davidReward/dokustudienarbeit/README.md

# Bitte beachten: http://stackoverflow.com/questions/6188780/git-latex-workflow
