davidReward/dokustudienarbeit/V2Doku/bericht.tex

%%%%%%%%%%%%%%%%%%%%%%%%%%%%%%%%%%%%%%%%%%%%%%%%%%%%%%%%%%%%%%%%%%%%%%%%%%%%%%
%% Descr:       Vorlage für Berichte der DHBW-Karlsruhe
%% Author:      Prof. Dr. Jürgen Vollmer, vollmer@dhbw-karlsruhe.de
%% $Id: bericht.tex,v 1.9 2010/04/10 10:43:57 vollmer Exp $
%%%%%%%%%%%%%%%%%%%%%%%%%%%%%%%%%%%%%%%%%%%%%%%%%%%%%%%%%%%%%%%%%%%%%%%%%%%%%%

\documentclass[
   ngerman          % neue deutsche Rechtschreibung
  ,a4paper          % Papiergrösse
% ,twoside          % Zweiseitiger Druck (rechts/links)
% ,10pt             % Schriftgrösse
% ,11pt
	,12pt
  ,pdftex
]{report}

% Bitte die Codierung Ihrer Dateien auswählen:
%\usepackage[latin1]{inputenc}      % Für UNIX mit ISO-LATIN-codierten Dateien
%\usepackage[applemac]{inputenc}  % Für Apple Mac
%\usepackage[ansinew]{inputenc}   % Für Microsoft Windows
\usepackage[utf8]{inputenc}      % UTF-8 codierte Dateien

% Um Markierungen von Baustellen zu ermöglichen.
\usepackage{color}
\usepackage{bericht}
\usepackage{geometry}
\usepackage{booktabs} % Schönere Tabellen
\usepackage{pdfpages}
\geometry{a4paper, top=25mm, left=25mm, right=25mm, bottom=25mm,
headsep=10mm, footskip=12mm}
\newcommand{\zB}{z.\,B.\ }
\newcommand{\dahe}{d.\,h.\ }

%%%%%%%%%%%%%%%%%%%%%%%%%%%%%%%%%%%%%%%%%%%%%%%%%%%%%%%%%%%%%%%%%%%%%%%%%%%%%%%
%% Angaben zur Arbeit
%%%%%%%%%%%%%%%%%%%%%%%%%%%%%%%%%%%%%%%%%%%%%%%%%%%%%%%%%%%%%%%%%%%%%%%%%%%%%%%

\newcommand{\Autor}{Jan Gerber und David Preiß}
\newcommand{\MatrikelNummer}{5757291 (Jan Gerber) 3199578(David Preiß)}
\newcommand{\Kursbezeichnung}{TINF14B3}

\newcommand{\FirmenName}{EDEKA Handelsgesellschaft Südwest mbH }
\newcommand{\FirmenStadt}{Offenburg }

%\newcommand{\BetreuerFirma}{Roland Schober}
\newcommand{\BetreuerDHBW}{Prof. Hans-Jörg Haubner}

%\newcommand{\Was}{Praxisbericht}
%\newcommand{\Was}{Robotik II}
\newcommand{\Was}{Studienarbeit}
%\newcommand{\Was}{BACHELORARBEIT}

\newcommand{\Titel}{Sensorknoten - Internet der Dinge}

\newcommand{\AbgabeDatum}{15. Mai 2017}

\newcommand{\Dauer}{Theoriephase 5. \& 6. Semester}

\newcommand{\Abschluss}{Bachelor of Engineering}
% \newcommand{\Abschluss}{Bachelor of Science}

\newcommand{\Studiengang}{Informationstechnik}
% \newcommand{\Studiengang}{Angewandte Informatik}

\newcommand{\ITServices}{IT Services }
\newcommand{\ESW}{EDEKA S\"udwest }
\newcommand{\ESWformal}{EDEKA Handelsgesellschaft S\"udwest mbH }

\hypersetup{%%
  pdfauthor={\Autor},
  pdftitle={\Titel},
  pdfsubject={\Was}
}

%%%%%%%%%%%%%%%%%%%%%%%%%%%%%%%%%%%%%%%%%%%%%%%%%%%%%%%%%%%%%%%%%%%%%%%%%%%%%%%

% Wenn \includeonly{..} benutzt wird, werden nur diese Kaptitel ausgegeben.
%\includeonly{
%  abk
% ,kapitel1
% ,kapitel2
% ,changelog
%}

%%%%%%%%%%%%%%%%%%%%%%%%%%%%%%%%%%%%%%%%%%%%%%%%%%%%%%%%%%%%%%%%%%%%%%%%%%%%%%%

% Benutzt man das "biblatex"-Paket, dann muß das hier stehen:
% BIBLATEX
\bibliography{bericht}

\sloppy

% Alter some LaTeX defaults for better treatment of figures:
    % See p.105 of "TeX Unbound" for suggested values.
    % See pp. 199-200 of Lamport's "LaTeX" book for details.
    %   General parameters, for ALL pages:
    \renewcommand{\topfraction}{0.8}	% max fraction of floats at top
    \renewcommand{\bottomfraction}{0.5}	% max fraction of floats at bottom
    %   Parameters for TEXT pages (not float pages):
    \setcounter{topnumber}{2}
    \setcounter{bottomnumber}{1}
    \setcounter{totalnumber}{5}     % 2 may work better
    %\setcounter{dbltopnumber}{2}    % for 2-column pages
    \renewcommand{\dbltopfraction}{0.9}	% fit big float above 2-col. text
    \renewcommand{\textfraction}{0.1}	% allow minimal text w. figs
    %   Parameters for FLOAT pages (not text pages):
    \renewcommand{\floatpagefraction}{0.4}	% require fuller float pages
	% N.B.: floatpagefraction MUST be less than topfraction !!
    \renewcommand{\dblfloatpagefraction}{0.7}	% require fuller float pages

	% remember to use [htp] or [htpb] for placement

\begin{document}
\lstset{language=Java}
\singlespacing % Alles bis zum eigentlichen Text in 1-fachen Zeilenabstand

%%%%%%%%%%%%%%%%%%%%%%%%%%%%%%%%%%%%%%%%%%%%%%%%%%%%%%%%%%%%%%%%%%%%%%%%%%%%%%%
{
\sffamily
\begin{titlepage}
\begin{center}
\vspace*{-2cm}
\hfill
%\includegraphics[width=4cm]{pics/dhbw-logo}\\[2cm]

\begin{figure}
%\subfigure{\includegraphics[width=0.10\textwidth]{pics/edekaneu.png}}\hfill
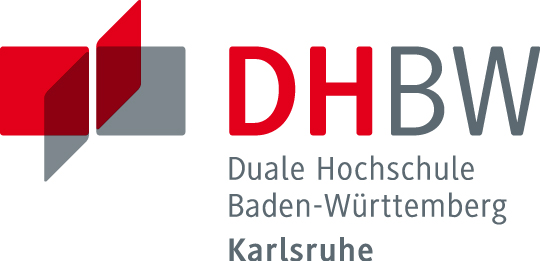
[picture p1: V2Doku/pics/dhbw-logo.png]
\subfigure{}\\[1.5cm]
\end{figure}

{\onehalfspacing \Huge \Titel}\\[1.5cm]

{\Huge  \Was}\\[1.5cm]
{\large für die Prüfung zum}\\[0.5cm]
{\Large \Abschluss}\\[0.5cm]
{\large des Studienganges \Studiengang}\\[0.5cm]
{\large an der}\\[0.5cm]
{\large Dualen Hochschule Baden-Württemberg Karlsruhe}\\[0.5cm]
{\large von}\\[0.5cm]
{\large\bfseries \Autor}\\[1cm]
{\large Abgabedatum \AbgabeDatum}
\vfill

\end{center}
\begin{tabular}{l@{\hspace{2cm}}l}
Bearbeitungszeitraum	         & \Dauer 			\\
Matrikelnummer	                 & \MatrikelNummer		\\
Kurs			         & \Kursbezeichnung		\\
%Ausbildungsfirma				 & \FirmenName \FirmenStadt \\
%Betreuer der Ausbildungsfirma	 & \BetreuerFirma		\\
Gutachter der Dualen Hochschule	 & \BetreuerDHBW		\\
\end{tabular}

\end{titlepage}
}
%%%%%%%%%%%%%%%%%%%%%%%%%%%%%%%%%%%%%%%%%%%%%%%%%%%%%%%%%%%%%%%%%%%%%%%%%%%%%%%

\pagenumbering{roman}

% Nur für Bachelorarbeiten einfügen:
%\input{sperrvermerk}
\input{erklaerung.tex}

\renewcommand{\abstractname}{Zusammenfassung}
\begin{abstract}
\begin{onehalfspacing}
Diese Studienarbeit thematisiert sich mit einem Sensorknoten für das Internet der Dinge. Hierzu werden die theoretischen und technischen Grundlagen des Raspberry Pis und  des Arduinos vorgestellt. Die Umsetzung beschäftigt sich mit der Planung und Entwicklung des Knotens und der dafür benötigter Komponenten.

Im Vordergrund der Arbeit steht die Umsetzung der Sensorknoten mit Hilfe eines Funkmoduls. Sie kommunizieren über eine Art Mesh-Netz untereinander und mit dem Raspberry Pi. 

Motivation der Studienarbeit ist der Wunsch nach einem skalierbaren und energiesparendem Sensorknoten. Er solll die gesammelten Messdaten in einer Datenbank speichen und diese anschließend visualisiert darstellt. Ferner sollen die Bedürfnisse des Nutzers nach einem \textit{Plug and Play} System nicht vernachlässigt werden.

\end{onehalfspacing}
\end{abstract}

%\newpage
% Beginn römische Ziffern bei den Verzeichnissen

\tableofcontents           % Inhaltsverzeichnis hier ausgeben
\listoffigures             % Liste der Abbildungen
\listoftables              % Liste der Tabellen
\lstlistoflistings         % Liste der Listings
%\listofequations           % Liste der Formeln

%%%%%%%%%% WORKAROUND: Eigener Pagestyle für Abkuerzungsverzeichnis %%%%%%%%%%%%%%
\fancypagestyle{abk}{%
\fancyhf{} % clear all header and footer fields
\fancyfoot[C]{\thepage}
\rhead{\slshape ABKÜRZUNGSVERZEICHNIS}
}
\pagestyle{abk}
%%%%%%%%%%%%%%%%%%%%%%%%%%%%%%%%%%%%%%%%%%%%%%%%%%%%%%%%%%%%%%%%%%%%%%%%%%%%%%%%%%%%%

% Jetzt kommt der "eigentliche" Text
\include{abk}              % Abkürzungsverzeichnis

%%%%%%%%%%  meinen Pagestyle wiederherstellen %%%%%%%%%%%%%%%
\pagestyle{fancy}
\fancyhf{} % -- alle Bereiche leeren
\rhead{\slshape\leftmark}
\fancyfoot[C]{\thepage}
%%%%%%%%%%%%%%%%%%%%%%%%%%%%%%%%%%%%%%%%%%%%%%%%%%%%%%%%%%%%%

%Beginn arabische Ziffern und 1,5 Zeilenabstand bei eigentlichem Text
\pagenumbering{arabic}

\onehalfspacing

% ########## Gliederung der Arbeit ################

\input{kapitel/01einleitung} 
\input{kapitel/02analyse}
\input{kapitel/03grundlagen}
\input{kapitel/04konzeption}
\input{kapitel/05realisierung}
\input{kapitel/06fazit} 

% #################################################

%\include{changelog}

\singlespacing %Literaturverzeichnis wieder 1-facher Zeilenabstand.

\addcontentsline{toc}{chapter}{Literaturverzeichnis}

% Haben Sie das "biblatex"-Paket nicht installiert, benutzen Sie folgendes:
% Ohne das "biblatex"-Paket (s. bericht.sty) produziert folgendes
% "deutsche" Zitate in Literaturverzeichnissen gemaß der Norm DIN 1505,
% Teil 2 vom Jan. 1984.
% Die Zitatmarken werden alphabetisch nach Verfassern
% sortiert und sind durch abgekürzte Verfasserbuchstaben plus
% Erscheinungsjahr in eckigen Klammern gekennzeichnet.

% \bibliographystyle{alphadin}
% \bibliography{bericht}

%%%%%%%%%%%%%%%%%%%%%%%%%%%%%%%%%%%%%%%5
% BIBLATEX
% Benutzt man das "biblatex"-Paket, muß man folgendes schreiben:
\def\refname{Literaturverzeichnis}
\printbibliography    

%%%%%%%%%%%%%%%%%%%%%%%%%%%%%%%%%%%%%%%5

% Ab hier beginnt der Anhang

\include{kapitel/anhang}

\newpage
%\addcontentsline{toc}{chapter}{Liste der ToDo's}
%\listoftodos[Liste der ToDo's]

\end{document}
