davidReward/dokustudienarbeit/V2Doku/erklaerung.tex

%%%%%%%%%%%%%%%%%%%%%%%%%%%%%%%%%%%%%%%%%%%%%%%%%%%%%%%%%%%%%%%%%%%%%%%%%%%%%%
%% Descr:       Vorlage für Berichte der DHBW-Karlsruhe, Erklärung
%% Author:      Prof. Dr. Jürgen Vollmer, vollmer@dhbw-karlsruhe.de
%% $Id: erklaerung.tex,v 1.1 2010/01/27 17:08:52 vollmer Exp $
%%%%%%%%%%%%%%%%%%%%%%%%%%%%%%%%%%%%%%%%%%%%%%%%%%%%%%%%%%%%%%%%%%%%%%%%%%%%%%%

% In Bachelorarbeiten muss eine schriftliche Erklärung abgegeben werden. In allen anderen
% Arbeiten entfällt diese. Hierin bestätigen die Studierenden, dass die Bachelorarbeit
% selbständig verfasst und sämtliche Quellen und Hilfsmittel angegeben sind. Diese Erklärung
% bildet das zweite Blatt der Arbeit. Der Text dieser Erklärung muss auf einer separaten Seite
% wie unten angegeben lauten.

\newpage
\thispagestyle{empty}
\begin{framed}
\begin{center}
\Large\bfseries \textsf{Erklärung}
\end{center}

\noindent
gemäß § 5 (3) der "`Studien- und Prüfungsordnung DHBW Technik"' vom 22. September 2011. 

\noindent
Ich habe die vorliegende Arbeit selbstständig verfasst und keine anderen als die angegebenen
Quellen und Hilfsmittel verwendet.

\vspace{3cm}
\noindent
\underline{\hspace{4cm}}\hfill\underline{\hspace{6cm}}\\
Ort~~~~~Datum\hfill Unterschrift\hspace{3.85cm}

\vspace{1cm}
\noindent
\underline{\hspace{4cm}}\hfill\underline{\hspace{6cm}}\\
Ort~~~~~Datum\hfill Unterschrift\hspace{3.85cm}

%\vspace{1cm}
%\noindent
%\underline{\hspace{4cm}}\hfill\underline{\hspace{6cm}}\\
%Ort~~~~~Datum\hfill Unterschrift\hspace{4cm}
%
%
%
%\vspace{1cm}
%\noindent
%\underline{\hspace{4cm}}\hfill\underline{\hspace{6cm}}\\
%Ort~~~~~Datum\hfill Unterschrift\hspace{4cm}

\end{framed}

%%%%%%%%%%%%%%%%%%%%%%%%%%%%%%%%%%%%%%%%%%%%%%%%%%%%%%%%%%%%%%%%%%%%%%%%%%%%%%%
\endinput
%%%%%%%%%%%%%%%%%%%%%%%%%%%%%%%%%%%%%%%%%%%%%%%%%%%%%%%%%%%%%%%%%%%%%%%%%%%%%%%
