davidReward/dokustudienarbeit/V2Doku/sperrvermerk.tex

\newpage
\thispagestyle{empty}
\begin{framed}
\begin{center}
\Large\bfseries \textsf{Sperrvermerk}
\end{center}

\noindent
Die vorliegende Arbeit beinhaltet interne vertrauliche Informationen 
der Firma EDEKA Handelsgesellschaft Südwest mbH. 

\noindent
Die Weitergabe des Inhaltes der Arbeit und eventuell beiliegender Zeichnungen und Daten im Gesamten oder in Teilen ist grundsätzlich untersagt. 

\noindent
Es dürfen keinerlei Kopien oder Abschriften – auch in digitaler Form - gefertigt werden. Ausnahmen bedürfen der schriftlichen Genehmigung der Firma EDEKA Handelsgesellschaft Südwest mbH in Abstimmung mit dem/der Verfasser/in.

\noindent
Die vorliegende Arbeit ist nur den Korrektoren sowie ggf. den Mitgliedern des Prüfungsausschusses zugänglich zu machen. 

\vspace{2cm}
\noindent
\underline{\hspace{4cm}}\\
Stempel\hspace{4cm}

\vspace{1cm}
\noindent
\underline{\hspace{4cm}}\hfill\underline{\hspace{7cm}}\\
Ort~~~~~Datum\hfill Unterschrift des Ausbildungsleiters\hspace{0.7cm}

\end{framed}
