davidReward/dokustudienarbeit/V2Doku/kapitel/anhang.tex

\includepdf[pages=-]{bilder/ArduinoNano-rotated.pdf}
\includepdf[pages=-]{bilder/ArduinoProMini-rotated.pdf}
\includepdf[pages=-]{bilder/ArduinoProMiniUeberarbeitet-rotated.pdf}
