davidReward/dokustudienarbeit/V2Doku/kapitel/05realisierung.tex

\chapter{Realisierung/Implementierung}
\input{kapitel/05/topologie}
\input{kapitel/05/sensoren}
\input{kapitel/05/hw}
%\input{kapitel/05/sender}
\input{kapitel/05/energiespar}
\input{kapitel/05/receiver}
%\input{kapitel/05/dv}
\input{kapitel/05/db}
\input{kapitel/05/webservice}
\input{kapitel/05/frontend}
