davidReward/dokustudienarbeit/V2Doku/anhang/00sperrvermerk.tex

\chapter*{Sperrvermerk}
Der vorliegende Praxisbericht ist mit einem Sperrvermerk versehen und wird ausschließlich zu Prüfungszwecken am Studiengang Informationstechnik der Dualen Hochschule Baden-Württemberg Karlsruhe vorgelegt.
Jede Einsichtnahme und Veröffentlichung – auch von Teilen der Arbeit – bedarf der vorherigen Zustimmung durch die Haake \& Partner GmbH.
