davidReward/dokustudienarbeit/V2Doku/kapitel/01einleitung.tex

\chapter{Einleitung}
Dies ist die Studienarbeit der Studenten der Informationstechnik Jan Gerber und David Preiß. Die Studenten realisierten das Projekt im fünften und sechsten Theoriesemester an der DHBW in Karlsruhe. Sie wurden betreut von Herrn Professor Hans-Jörg Haubner.
\input{kapitel/01/ziel}
\input{kapitel/01/aufgabe}
\input{kapitel/01/technik}
\input{kapitel/01/motivation}
