davidReward/dokustudienarbeit/V2Doku/anhang/03abkJan.tex

 \acro{GPIO}{General Purpose Input Output}
 \acro{REST}{Representational State Transferr}
 \acro{ROA}{Resource-oriented architecture}
 \acro{HTTP}{Hypertext Transfer Protoco}
 \acro{URI}{Uniform Resource Identifier}
 \acro{SSL}{Secure Sockets Layer}
 \acro{HATEOAS}{Hypermedia As The Engine Of Application State}
 \acro{HTTPS}{HyperText Transfer Protocol Secure}
 \acro{IDE}{Integrated Development Environment}
 \acro{USART}{Universal synchronous/asynchronous Receiver-Transmitter}
 \acro{WDT}{Watchdog Timer}
 \acro{SQL}{Structured Query Language}
 \acro{JSON}{JavaScript Object Notation}
 \acro{PCB}{Printed Circuit Board}
