davidReward/dokustudienarbeit/V2Doku/kapitel/03grundlagen.tex

\chapter{Theoretische und technische Grundlagen}
\input{kapitel/03/iot}
\input{kapitel/03/arduino}
\input{kapitel/03/raspi}
\input{kapitel/03/communication}
\input{kapitel/03/sensorik}
\input{kapitel/03/mesh}
\input{kapitel/03/rest}
