davidReward/dokustudienarbeit/V2Doku/kapitel/00deckblatt.tex

\begin{titlepage}
	\begin{longtable}{p{.4\textwidth} p{.4\textwidth}}
		{}
	\end{longtable}
	\enlargethispage{20mm}
	\begin{center}
		\vspace*{12mm}	{\LARGE \textbf{ IoT-Sensorknoten} }\\
		\vspace*{12mm}	{\large \textbf{ Studienarbeit}}\\
		\vspace*{12mm}	für die Prüfung zum\\
		\vspace*{3mm}		{\textbf{ Bachelor of Engineering}}\\
    \vspace*{12mm}	des Studienganges Informationstechnik{} \\
    \vspace*{3mm}		an der Dualen Hochschule Baden-Württemberg Karlsruhe{} \\
		\vspace*{12mm}	von\\
		\vspace*{3mm}		{\large \textbf{ Jan Gerber und David Preiß}}\\
		\vspace*{12mm}	September 2015\\
	\end{center}
	\vfill
	\begin{spacing}{1.2}
	\begin{tabbing}
		mmmmmmmmmmmmmmmmmmmmmm            \= \kill
		\textbf{Bearbeitungszeitraum}       \>  Theoriephase\\
		\textbf{Matrikelnummer, Kurs}  \>  3199578, TINF14B3\\
		\textbf{Betreuer}               \>  Prof. Hans-Jörg Haubner
	\end{tabbing}
	\end{spacing}
\end{titlepage}
\pagenumbering{Roman}
