davidReward/dokustudienarbeit/V2Doku/kapitel/02analyse.tex

\chapter{Problemstellung}
In diesem Kapitel soll die Problemstellung genauer erläutert werden. Hierfür wird der Ist-Zustand genauer betrachtet, sowie der Soll-Zustand der nach der Fertigstellung der Studienarbeit erreicht werden sollte. 
\input{kapitel/02/ist}
\input{kapitel/02/soll}
