davidReward/dokustudienarbeit/V2Doku/anhang/03abkDavid.tex

 \acro{RISC}{Reduced Instruction Set Computer}
 \acro{DSP}{Digitaler Signalprozessor}
 \acro{MMU}{Memory Management Unit}
 \acro{GPIO}{General-purpose input/output}
 \acro{CSI}{Camera Serial Interface}
 \acro{DSI}{Display Serial Interface}
 \acro{SPI}{Serial Peripheral Interface Bus}
 \acro{I2C}[I\textsuperscript{2}C]{Inter-Integrated Circuit}
 \acro{PIXEL}{Pi Improved Xwindows Environment, Lightweight}
 \acro{LXDE}{Lightweight X11 Desktop Environment}
 \acro{IoT}{Internet of Things}
 \acro{RFID}{radio-frequency identification}
 \acro{NFC}{Near Field Communication}
