davidReward/dokustudienarbeit/V2Doku/literatur/links.txt

arm-2009.pdf https://osg.informatik.tu-chemnitz.de/lehre/lab/slides/arm-2009.pdf
