davidReward/dokustudienarbeit/V2Doku/kapitel/01/aufgabe.tex

\section{Aufgabenstellung}
Für die eigentlichen Sensorknoten sollen Arduinos zum Einsatz kommen. Sie lesen die entsprechenden Sensoren aus. Die erfassten Daten senden sie über ein Funkmodul an einen Raspberry Pi. Dieser hat eine Internetanbindung. Der Raspberry Pi verarbeitet die Daten, bringt sie in einen standardisiertes Format und gibt sie an einen externen Server weiter. Der  externe Server kann dann eine Auswertung der Daten vornehmen.
