davidReward/dokustudienarbeit/V2Doku/kapitel/01/technik.tex

\section{Stand der Technik}
Für die Umsetzung der gestellten Aufgabe eigenen sich Arduino-Mikrocontroller und der Raspberry Pi besonders. Sie lösen die generell bestehenden technischen Probleme relativ gut. Zu diesen Problemen gehört unter anderem der Energieverbrauch und die Kommunikation. Für den Bau von Prototypen sind diese Mikrocontroller sehr beliebt. 

Fertige Produkte auf dem Markt nutzen dagegen meist proprietäre eingebettete Systeme. Diese lassen sich allerdings schlecht oder gar nicht modifizieren.
