davidReward/dokustudienarbeit/V2Doku/kapitel/01/ziel.tex

\section{Ziel dieser Arbeit}
Die vorliegende Arbeit zielt darauf ab, Sensorknoten für das Internet of Things zu realisieren. Die Sensorknoten sollen möglichst selbstkonfigurierend sein. Die Teilnahme an dem zu entwickelnden Mesh-Netz soll keine Vorkonfiguration erfordern. 

Ferner ist das Ziel, dass die Sensorknoten energiesparend sind, sodass sie sich mittels Batterie betreiben lassen. Dadurch ergibt sich ein breites Anwendungsgebiet für die Sensorknoten.
