davidReward/dokustudienarbeit/V2Doku/kapitel/03/power.tex

\section{Energiemanagement  mit Interrupts}
