davidReward/dokustudienarbeit/studienarbeit.tex

\documentclass[a4paper,12pt]{scrreprt}

\usepackage[ngerman]{babel}
\usepackage[utf8]{inputenc}
\usepackage{graphicx}
\usepackage{longtable}
\usepackage{fancyhdr}
\usepackage[autostyle=true,german=quotes]{csquotes}
\usepackage{hyperref}
\usepackage[printonlyused]{acronym}
\usepackage{setspace}
\usepackage[utf8]{inputenc} 
\usepackage{listings}

\lstset{breaklines=true}
\pagestyle{fancy}
\fancyhf{}
\lhead{\fancyplain{}{\rightmark }} 
\lfoot[Autor: Jan Gerber, David Preiß]{Autor: Jan Gerber, David Preiß}
\rfoot[\thepage]{\thepage}
\onehalfspacing

\begin{document}

%DECKBLATT
\input{kapitel/00deckblatt}

%SPERRVERMERK
%\input{anhang/00sperrvermerk}

%ERKLÄRUNG
\input{anhang/01erklaerung}

%ABSTRACT
\input{anhang/02abstract}

\tableofcontents

%ABK
\input{anhang/03abk}

\listoffigures

%Bilder einfügen: 
%\begin{figure}
%\includegraphics[width=\columnwidth]{bilder/engDaxRoute} 
%\caption{engDAX Webinterface: engDAX-Routenkonfiguration}
%\label{engDAX Webinterface: engDAX-Routenkonfiguration}
%\end{figure}

\listoftables

%FORMELVZ
%##TODO##

\cleardoublepage
\pagenumbering{arabic}

%HAUPTTEIL
\input{kapitel/01einleitung} 
\input{kapitel/02analyse}
\input{kapitel/03grundlagen}
\input{kapitel/04konzeption}
\input{kapitel/05realisierung}
\input{kapitel/06fazit} 

%LITERATUR
\input{anhang/i_literatur}

\end{document}
