davidReward/dokustudienarbeit/pa1u2.tex

\documentclass[a4paper,12pt]{scrreprt}

\usepackage[ngerman]{babel}
\usepackage[utf8]{inputenc}
\usepackage{graphicx}
\usepackage{longtable}
\usepackage{fancyhdr}
\usepackage[autostyle=true,german=quotes]{csquotes}
\usepackage{hyperref}
\usepackage[printonlyused]{acronym}
\usepackage{setspace}
\usepackage[utf8]{inputenc} 

\pagestyle{fancy}
\fancyhf{}
\lhead{\fancyplain{}{\rightmark }} 
\lfoot[Autor: David Preiß]{Autor: David Preiß}
\rfoot[\thepage]{\thepage}
\onehalfspacing

\begin{document}

%DECKBLATT
\input{kapitel/00deckblatt}

%SPERRVERMERK
\input{anhang/00sperrvermerk}

%ERKLÄRUNG
\input{anhang/01erklaerung}

%ABSTRACT
\input{anhang/02abstract}

\tableofcontents

%ABK
\input{anhang/03abk}

\listoffigures

\listoftables

%FORMELVZ
%##TODO##

\cleardoublepage
\pagenumbering{arabic}

%HAUPTTEIL
\input{kapitel/01einleitung} 
\input{kapitel/02analyse}
\input{kapitel/03praxis1}
\input{kapitel/04praxis2}
   
%LITERATUR
\input{anhang/i_literatur}

\end{document}
