davidReward/dokustudienarbeit/V2Doku/anhang/01erklaerung.tex

\chapter*{Erklärung}
Ich erkläre hiermit ehrenwörtlich: \\
\begin{enumerate}
\item dass ich meinen Praxisbericht ohne fremde Hilfe angefertigt habe;
\item dass ich die Übernahme wörtlicher Zitate aus der Literatur sowie die Verwendung der Gedanken
anderer Autoren an den entsprechenden Stellen innerhalb der Arbeit gekennzeichnet habe;
\item dass ich meinen Praxisbericht bei keiner anderen Prüfung vorgelegt habe;
\item dass die eingereichte elektronische Fassung exakt mit der eingereichten schriftlichen Fassung
übereinstimmt.
\end{enumerate}

Ich bin mir bewusst, dass eine falsche Erklärung rechtliche Folgen haben wird.
\vspace{3em}

Karlsruhe, September 2015
\vspace{4em}

David Preiß
