davidReward/dokustudienarbeit/V2Doku/kapitel/06fazit.tex

\chapter{Lösungsbewertung und Fazit}
\input{kapitel/06/vergleich}
\input{kapitel/06/bewertung}
\input{kapitel/06/zusammenfassung}
\input{kapitel/06/ausblick}
