davidReward/dokustudienarbeit/V2Doku/kapitel/01/motivation.tex

\section{Motivation und Vorausblick}
Hardwareentwicklung, Softwareentwicklung sowie die Webentwicklung sind die relevanten Bereiche dieser Arbeit. 

Nach der Einleitung betrachten die Autoren die gestellte Problemstellung. 
Im dritten Kapitel werden relevante technische und theoretische Grundlagen vermittelt. 

Anschließend folgt die Konzeption. Hier sind die grundsätzlichen Überlegungen zur Realisierung des Projekts niedergeschrieben und graphisch veranschaulicht. 

In dem Kapitel Implementierung sind wesentliche Schritte zur Realisierung beschrieben. Ebenso sind dort relevante Quellcodeausschnitte erklärt.

Das Fazit enthält einen Vergleich zwischen der gestellten Aufgabe und dem Ergebnis sowie einen Ausblick inwiefern dieses Projekt fortsetzbar ist.
