davidReward/dokustudienarbeit/V2Doku/literatur/arm-2009.pdf

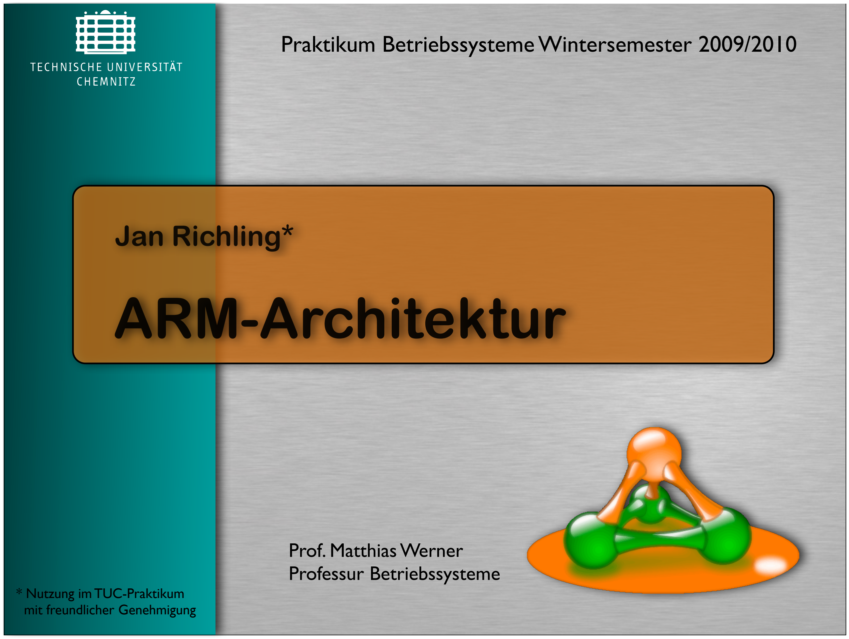
[picture p23: figure]
Prof. Matthias Werner Professur Betriebssysteme; ARM-Architektur; Jan Richling*; * Nutzung im TUC-Praktikum

Praktikum Betriebssysteme Wintersemester 2009/2010

mit freundlicher Genehmigung | Prof. Dr. Matthias Werner | Praktikum Betriebssysteme WS 2009/2010

ARM-Architektur

2-

## Ziele

- !"##"#$"%#"#&'"%&(%)*"++)%,%-./0"102%&'"%&3/"$4$,5)%6&*7"-1+&8#07/-1$2#9& "/#"+&:"0%/";++<+0"6+&=>%&'/"+"
▶(%)*"++)%6)'/
▶(%)*"++)%*2+0?#'"
▶@"9/+0"%
▶A#0"%%240+&2#'&B2+#,.6"#
- B++"6;$"%4%)9%,66/"%2#9&,2=&B@C ▶:"=".$++,0*
▶:"+)#'"%."/0"#
- D4"/-."%&E,6&:"/+4/"$&BFGH@CGIJJK
- 8/#L&2#'&B2+9,;"&E,6&:"/+4/"$&BFGH@CGIJJK
- (%)9%,66/"%2#9
▶D4%,-."#
▶32+,66"#+4/"$&M)#&NL&2#'&B++"6;$"%4%)9%,66"#

2

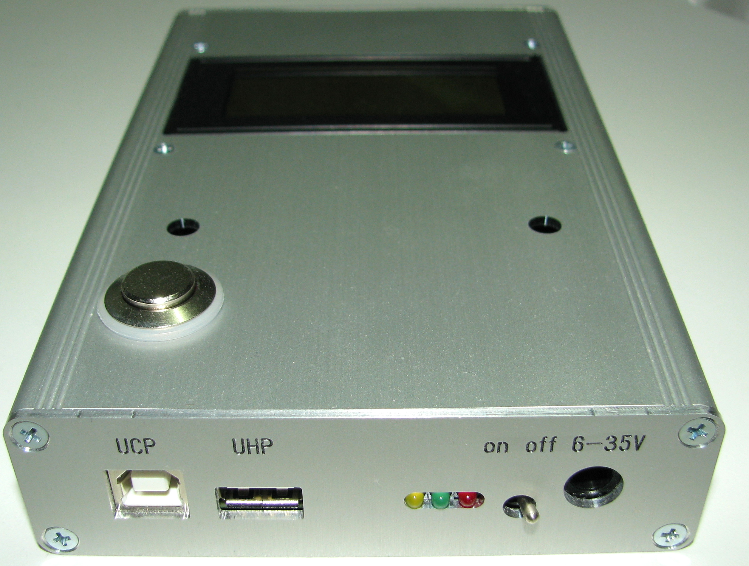
[picture p24: figure]

Prof. Dr. Matthias Werner | Praktikum Betriebssysteme WS 2009/2010

ARM-Architektur

## Zielplattform

- D<+0"6
8/#9";"O"0"+&D<+0"6&,$+&PD<+0"6&)#&,&N./4Q&ED)NK ▶!"#$%&'()*'$+%&$,-".%//"-0%-&$1&+$&2(%.1$2**%$31&04"&2*%&$56&(%6'%&$+%/$ 7%8(&%-/
▶92-:;%-$(6&21/
<D4"/-."%
<D0%)6M"%+)%92#9
<D-.#/O+0"$$"#
- (%)*"++)%
▶,-".%//"-2-8(6'%0'1-=$>7? ▶@%3%(*//2'.=$>7?ABC
▶,-".%//"-32D6*6%=$>7?E
▶,-".%//"-0%-&=$>7?EFGC
▶,-".%//"-=$>CEH7?EFGG

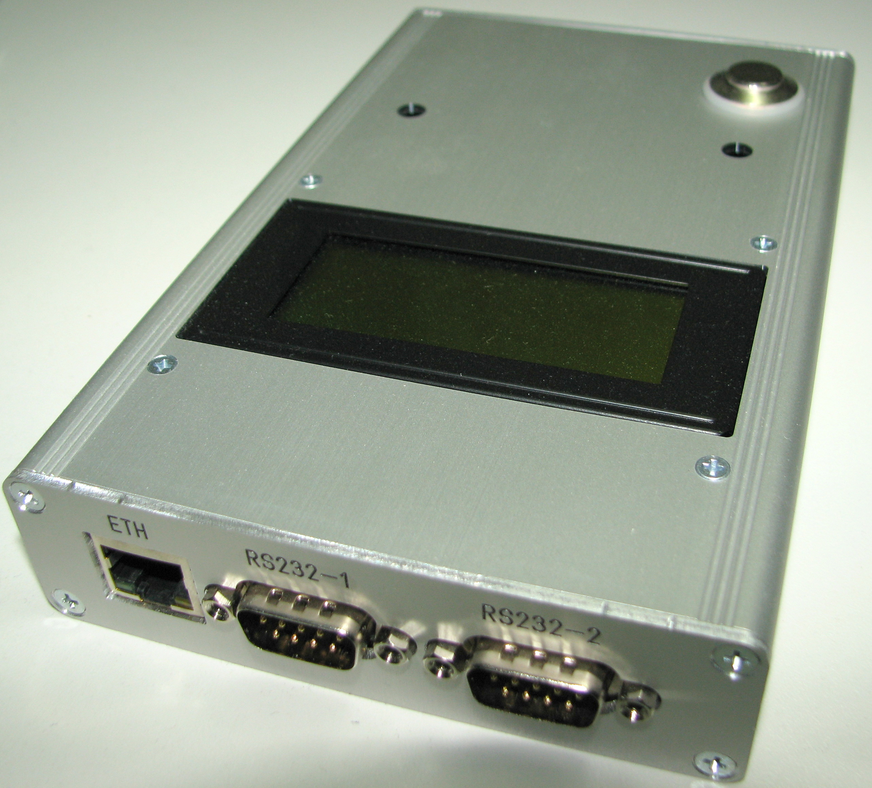
[picture p25: figure]

3 | Prof. Dr. Matthias Werner | Praktikum Betriebssysteme WS 2009/2010

ARM-Architektur

## Taskit Portux MiniPC TUB

- BFGH@CGIJJ
- HR&C:&S$,+.
- RT&C:&@BC
- HUJ&CV*
- 80."%#"0&HJJ&C:/0W+
- T&X&+"%/"$$
- YD:&V)+0&2#'&F,%9"0
- F"X0'/+4$,<&HRXT
- @"+"0LF,+0"%
- :))0$),'"%Z&2;))0
- !,##&[/#2X&;))0"#

Prof. Dr. Matthias Werner | Praktikum Betriebssysteme WS 2009/2010
2-

## Was ist ARM?

- 8/#"&S/%6,
▶B-)%#&@ADN&C,-./#"
▶B'M,#-"'&@ADN&C,-./#"
▶B'M,#-"'&@ADN&C,-./#"+\&[0'] ▶HGU^LHGU_Z&8#07/-1$2#9&'"%&B-)%#&@ADN&C,-./#"&'2%-.&'/"&B-)%#\&[0']&2#0"%& ["/02#9&M)#&D0"M"&S2%;"%&2#'&@)9"%&ED)4./"K&`/$+)# ▶B;&HGGJZ&`"/0"%"#07/-1$2#9&2#'&a"%6,%102#9&'2%-.&'/"&B@C\&[0']
- 8/#&(%)*"++)%'"+/9#
- :"*"/-.#2#9&M)#&(%)*"++)%1"%#"#
▶:"/+4/"$7"/+"&B@CGIJF
- b"+-.?c+4%/#*/4Z
▶a"%1,2=&M)#&d"+/9#+&/#&S)%6&M)#&V,%'7,%";"+-.%"/;2#9"# ▶!"/#"&"/9"#"&V"%+0"$$2#9&M)#&V,%'7,%"
▶[/*"#*#".6"%&E;"/+4/"$+7"/+"&B06"$K&/#0"9%/"%"#&!"%#"&/#&"/9"#"&V,%'7,%"&
E;"/+4/"$+7"/+"&BFGH@CGIJJK
5 | Prof. Dr. Matthias Werner | Praktikum Betriebssysteme WS 2009/2010
2-

## Varianten

- FLa,%/,#0"Z
Y#0"%+0>0*0&F.26;LC)'2+
- CLa,%/,#0"Z
Y#0"%+0>0*0&C2$e4$/1,e)#&*7"/"%&^IL:/0L3,.$"#&*2&"/#"%&RTL:/0L3,.$&E$,#9"& C2$e4$/1,e)#K
- 8La,%/,#0"Z
8#.,#-"'&dD(&f&A#+0%21e)#"#&=>%&:"+-.$"2#/92#9&0<4/+-."%&dD(L g4"%,e)#"#
- hLa,%/,#0"Z
h,*"$$"&f;/"0"0&D)cL&2#'&V,%'7,%";"+-.$"2#/92#9&=>%&h,M,L:<0"-)'"

6

ARM-Architektur

## Versionen 1-4

- a"%+/)#&HZ
i/"&/#&"/#"6&1)66"%*/"$$"#&(%)'210&M"%7"#'"0\&IRL:/0&B'%"++%,26\&#2%& 9"%/#9"&F"/$6"#9"&'"+&,102"$$"#&A#+0%21e)#++,0*"+
- a"%+/)#&IZ
8%7"/0"%0"&a"%+/)#&H\&6".%&@"9/+0"%\&!)4%)*"++)%LY#0"%+0>0*2#9\&IRL:/0& B'%"++%,26\&C2$e4$/1,e)#+/#+0%21e)#"#
- a"%+/)#&^Z
^IL:/0&B'%"++%,26\&=>.%0&D0,02+%"9/+0"%&N(D@&2#'&D(D@&"/#\&*7"/&#"2"& (%)*"++)%6)'/\&CLa,%/,#0"
- a"%+/)#&TZ
*2+?0*$/-."%&ED<+0"6K&(%)*"++)%6)'2+\&F.26;LC)'2+&
EFLa,%/,#0"K
▶>-8(6'%0'1-$+%-$I6%*J*2K"-D
▶>**%$6&$+6%/%-$LM$A"-N%/'%**'%&$9%'26*/$N%*'%&$2;$L%-/6"&$B
7 | Prof. Dr. Matthias Werner | Praktikum Betriebssysteme WS 2009/2010

ARM-Architektur

## Versionen 5-7

- a"%+/)#&_Z
8%7"/0"%0&a"%+/)#&T&26&"/#/9"&A#+0%21e)#"#\&M"%;"++"%0&32+,66"#,%;"/0& *7/+-."#&F.26;L&2#'&B@CLC)'2+\&hL&2#'&8La,%/,#0"
- a"%+/)#&RZ
A#+0%21e)#"#&=>%&;"++"%"&C2$e6"'/,LY#0"%+0>0*2#9&E+4"*/"$$&DACdL A#+0%21e)#"#K\&M"%;"++"%0"&A#0"%%240L:".,#'$2#9\&#"2"&D0,02+;/0+\&F.26;I& )4e)#,$
- a"%+/)#&jZ
F.26;I&);$/9,0)%/+-.\&#"2"&DACdLA#+0%21e)#"#&Ei8gi&k&4,-1"'&DACdK\& dD(LY#0"%+0>0*2#9\&(%)l$"&=>% ▶>&O%&+1&N%&$P>7?AQR>S=$??TU$("(%$,%-3"-D2&8%$;%6$&6%+-6N%D$ 5&%-N6%A%-;-218(U$"J4D6%-'$3:-$?1*4'2/06&N ▶58('.%6'$P>7?AQR7S=$V%-6&N%$M2'%&.U$L"-(%-/2N;2-0%6'U$N%/8(:'.'%-$!J%68(%-▶?68-"8"&'-"**%-$P>7?AQR?S=$V%-6&N%$C-2&/6/'"-2&.2(*U$L"-(%-/2N;2-0%6'U$4%3$ %6&N%;%W%'

Prof. Dr. Matthias Werner | Praktikum Betriebssysteme WS 2009/2010
2-

## Namensbildung für Implementationen

- :"9/##"#&6/0&B@CM]]]
▶N%3"*N'$A"&$+%-$L%-/6"&XXX
▶XXX$1&+$+2&&$+%-$>13.)(*1&N$+%-$L2-62&'%& ▶@%/"&+%-(%6'=$?"+%**%$2;$L%-/6"&$B$1&'%-/':'.%&$6&$+%-$7%N%*$?U$/"$+2//$+6%/$ &68('$D%(-$213N%3:(-'$O6-+X$>1/&2(D%&$"(&%$?$O%-+%&$2*/$Y?$N%0%&&.%68(&%'
- :"/+4/"$Z&B@CM_FXC
- :"+)#'"%."/0Z&:"*"/-.#2#9"#&).#"&QMm&;"*"/-.#"#&A64$"6"#0,e)#"#\
- 3,.$&/+0&#/-.0&'/%"10&6/0&B%-./0"102%M"%+/)#&1)%%"$/"%0
- :"/+4/"$Z&
▶Z%-&$>7?EFGC$6/'$%6&%$[DJ*%D%&'24"&$+%-$EX$V%&%-24"&$P>7?ES$1&+$ 6DJ*%D%&4%-'$>7?R>-8(6'%0'1-$ABCU$2*/"$L%-/6"&$B$D6'$C(1D;R?"+1/
▶!\/'%DR"&R2R#(6J$>CEH7?EFGG$%&'()*'$1X2X$%6&%&$>7?EFGCRZ%-&
9 | Prof. Dr. Matthias Werner | Praktikum Betriebssysteme WS 2009/2010
2-

## ARM: Einordnung

- 3/"$+<+0"6"Z&8/#9";"O"0"&D<+0"6"
- b"%/#9"%&8#"%9/"M"%;%,2-.
- V)."&("%=)%6,#*&E9"6"++"#&,#&6,%10>;$/-."#&C/1%)-)#0%)$$"%#K
- V)."&A#0"9%,e)#&ED)NK
- S?./91"/0&*2%&B2+=>.%2#9&P>;$/-."%Q&:"0%/";++<+0"6"&E[/#2X\&`/#')7+&C);/$"\&'/M"%+"& 8-.0*"/0+<+0"6"K
- ("%=)%6,#*Z
- i/-.0&'/%"10&6/0&(NLF"-.#/1&M"%9$"/-.;,%
- BFGH@CGIJJ&"#0+4%/-.0&;"/&A#0"9"%La"%,%;"/02#9&/#&"07,&"/#"6&("#e26&H&6/0& M"%9$"/-.;,%"%&F,1n%"o2"#*
- BFGH@CGIJJZ&IJJ&CA(D&EC/$$/)#&A#+0%2-e)#+&4"%&D"-)#'K&$,20&B06"$
- 8#"%9/"M"%;%,2-.
- BFGH@CGIJJ&;"#pe90&2#0"%&a)$$,+0&I_&6B&;"/&H\U&a)$0Z&T_&6`
- BFGH@CGIJJ&;%,2-.0&/6&D0,#';<&J\_&6B&;"/&H\U&a)$0Z&J\G&6`
- A#0"9%/"%0"&("%/4."%/"&1,##&'/"+"&`"%0"&q"&#,-.&i20*2#9&"%.p."# [8d&,#&AWgL()%0Z&HJ&)'"%&6".%&6B
- r;$/-."%7"/+"&1"/#"&;"+)#'"%"#&!>.$6,s#,.6"#

10

ARM-Architektur

## Architektur-Parameter

- @ADNLd"+/9#
- ^IL:/0&B'%"++L&2#'&d,0"#;2+&E6,X]&T&b:&,'%"++/"%;,%K
- [),'WD0)%"LB%-./0"102%
- ^LB'%"++LA#+0%21e)#"#&6/0&="+0"%&[?#9"&E^I&:/0K
- j&(%)*"++)%LC)'/
- ^j&@"9/+0"%
- _&9%2#'+?0*$/-."&B'%"++/"%2#9+6)'/&6/0&q"7"/$+&;/+&*2&HH&Y#0"%=)%6,0"#
- d,0"#0<4"#Z
- `)%0&E^I&:/0K\&,#&TL:<0"Lb%"#*"#&,2+9"%/-.0"0
- V,$;7)%0&EHR&:/0K\&,#&IL:<0"Lb%"#*"#&,2+9"%/-.0"0
- :<0"&EU&:/0K
- A#+0%21e)#"#
- _T&B@CLA#+0%21e)#"#Z&9"#,2&"/#&`)%0&;%"/0
- ^U&F.26;LA#+0%21e)#"#Z&9"#,2&"/#&V,$;7)%0&;%"/0
- d,0"#M"%,%;"/0"#'"&g4"%,e)#"#&,%;"/0"#&,$$"&,2=&`p%0"%#
11 | Prof. Dr. Matthias Werner | Praktikum Betriebssysteme WS 2009/2010

ARM-Architektur

## Prozessor-Modi

User | usr | Regulärer Benutzermodus
System | sys | Regulärer privilegierter Modus
Modus | Kurzform

Beschreibung

Supervisor | svc | Modus für Systemrufe (SWI)
Abort | abt | Memory Abort
Undefined | und | Undefinierte Instruktionen
Interrupt | irq | Interrupts
Fast Interrupt | fiq | Beschleunigte Interrupts

### Ausnahme-Modi

Prof. Dr. Matthias Werner | Praktikum Betriebssysteme WS 2009/2010
2-

## Prozessor-Modi

- B$$"&C)'/&,2s"%&Y+"%LC)'"&+/#'&4%/M/$"9/"%0
- B$$"&C)'/&;/+&,2=&Y+"%&2#'&D<+0"6&+/#'&B2+#,.6"LC)'/
- (%)9%,66"&$,2="#&/6&Y+"%LC)'2+\&;/+&B2+#,.6"&,2c%/O\&'/"&/6& ;"0%"t"#'"#&C)'2+&;".,#'"$0&7/%'
- C)'/&.,;"#&0"/$7"/+"&6)'2+L+4"*/l+-."&@"9/+0"%
- (%)*"++)%&+0,%0"0&/6&D24"%M/+)%LC)'2+
- 8X4$/*/0"&C)'2+LY6+-.,$02#9"#&+/#'&/#&,$$"#&4%/M/$"9/"%0"#&C)'/&6p9$/-.
- Y+"%LC)'2+&1,##&#2%&>;"%&D)c7,%"LA#0"%%240&ED`AK&,1eM&M"%$,++"#&7"%'"#
13 | Prof. Dr. Matthias Werner | Praktikum Betriebssysteme WS 2009/2010
2-

## Register

- ^j&@"9/+0"%
- i20*"%+/-.0Z&@JL@H_
- @JL@HI&6"/+0&;"$/";/9&;"#20*;,%
- :"+)#'"%"&S2#1e)#"#&2#'&@"9/+0"%Z ▶7H]=$,#$^$,-"N-2D$#"1&'%-▶7HB=$M7$^$M6&0$7%N6/'%-$P>1/&2(D%R?"+1/U$@MR[&/'-104"&S ▶7H_=$!,$^$!'280J"6&'%-
▶#,!7=$#1--%&'$,-"N-2D$!'2'1/$7%N6/'%-▶!,!7=$!2A%+$,-"N-2D$!'2'1/$7%N6/'%-
- @"9/+0"%&+/#'&0"/$7"/+"&6)'2+L+4"*/l+-. ▶L%-%6&328('$?"+1/O%8(/%*
▶5-.%1N'$D"+1/R2;()&N6N%$!68('$213$7%N6/'%-▶5-3"-+%-'$@%28('1&N$;%6$+%-$@%'-6%;//\/'%D%&'O680*1&N

14

ARM-Architektur

## Register und Prozessor-Modi

User/System
R0
R1
R2
R3
R4
R5
R6
R7 | Fast Interrupt
R8 | R8_fiq
R9 | R9_fiq
R10 | R10_fiq
R11 | R11_fiq
R12 | R12_fiq | Interrupt | Supervisor | Undefined | Abort
R13 SP | R13_fiq | R13_irq | R13_svc | R13_undef | R13_abt
R14 LR | R14_fiq | R14_irq | R14_svc | R14_undef | R14_abt
R15 PC
cpsr
| spsr_fiq | spsr_irq | spsr_svc | spsr_undef | spsr_abt
15 | Prof. Dr. Matthias Werner | Praktikum Betriebssysteme WS 2009/2010

ARM-Architektur

## Register und Prozessor-Modi

CPSR PC

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
User/System-Modus

CPSR | PC

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
R13_svc
R14_svc

Supervisor-Modus

SPSR_svc

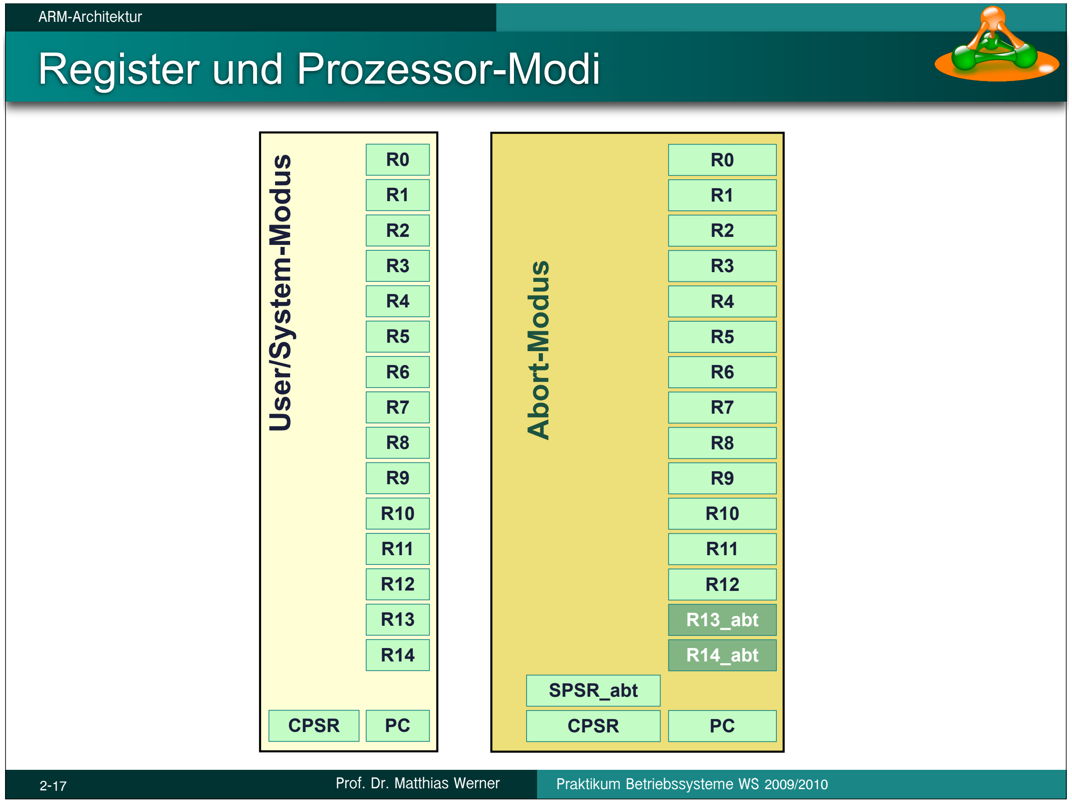
[picture p26: figure]
Register und Prozessor-Modi; CPSR; R13_abt; R14_abt; Abort-Modus; SPSR_abt; User/System-Modus

Prof. Dr. Matthias Werner | Praktikum Betriebssysteme WS 2009/2010

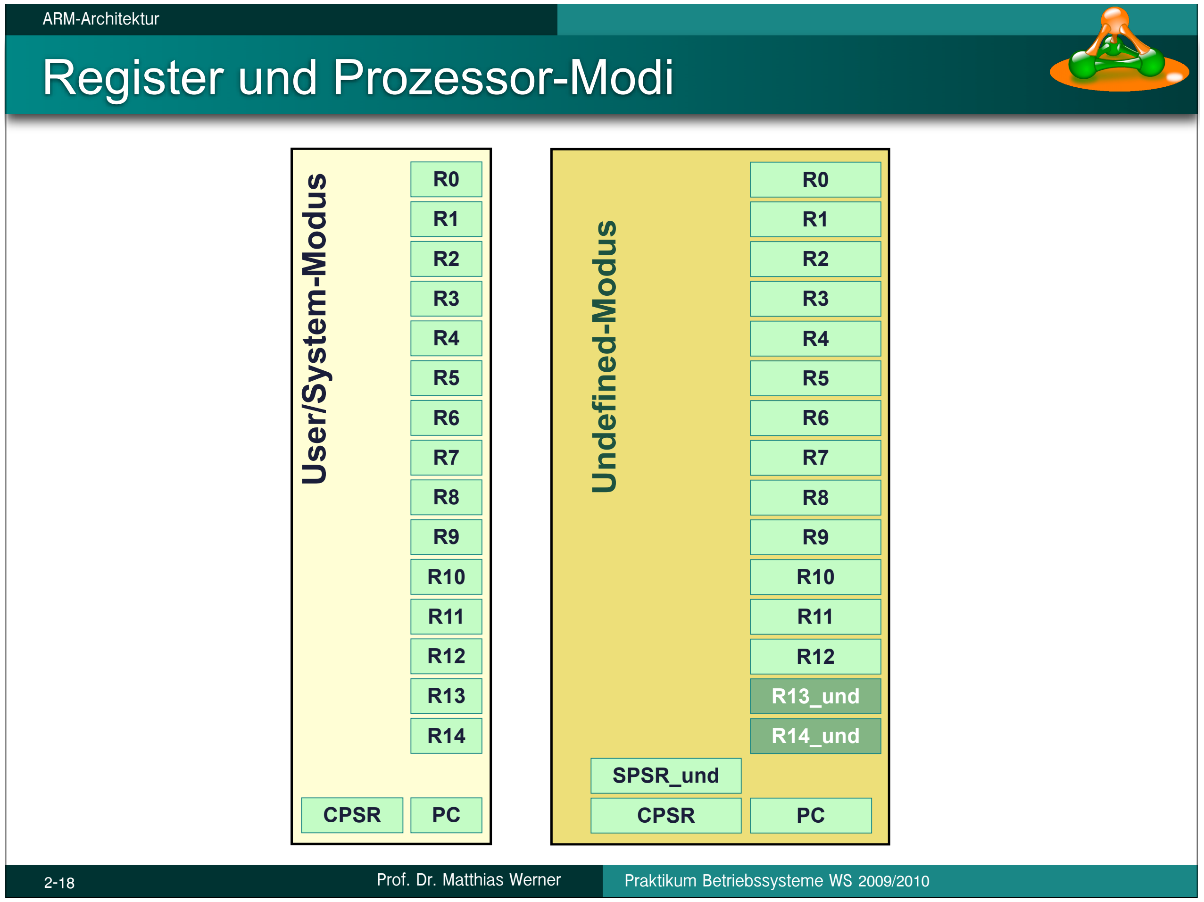
[picture p27: figure]
Register und Prozessor-Modi; CPSR; R13_und; R14_und; Undefined-Modus; SPSR_und; User/System-Modus

Prof. Dr. Matthias Werner | Praktikum Betriebssysteme WS 2009/2010

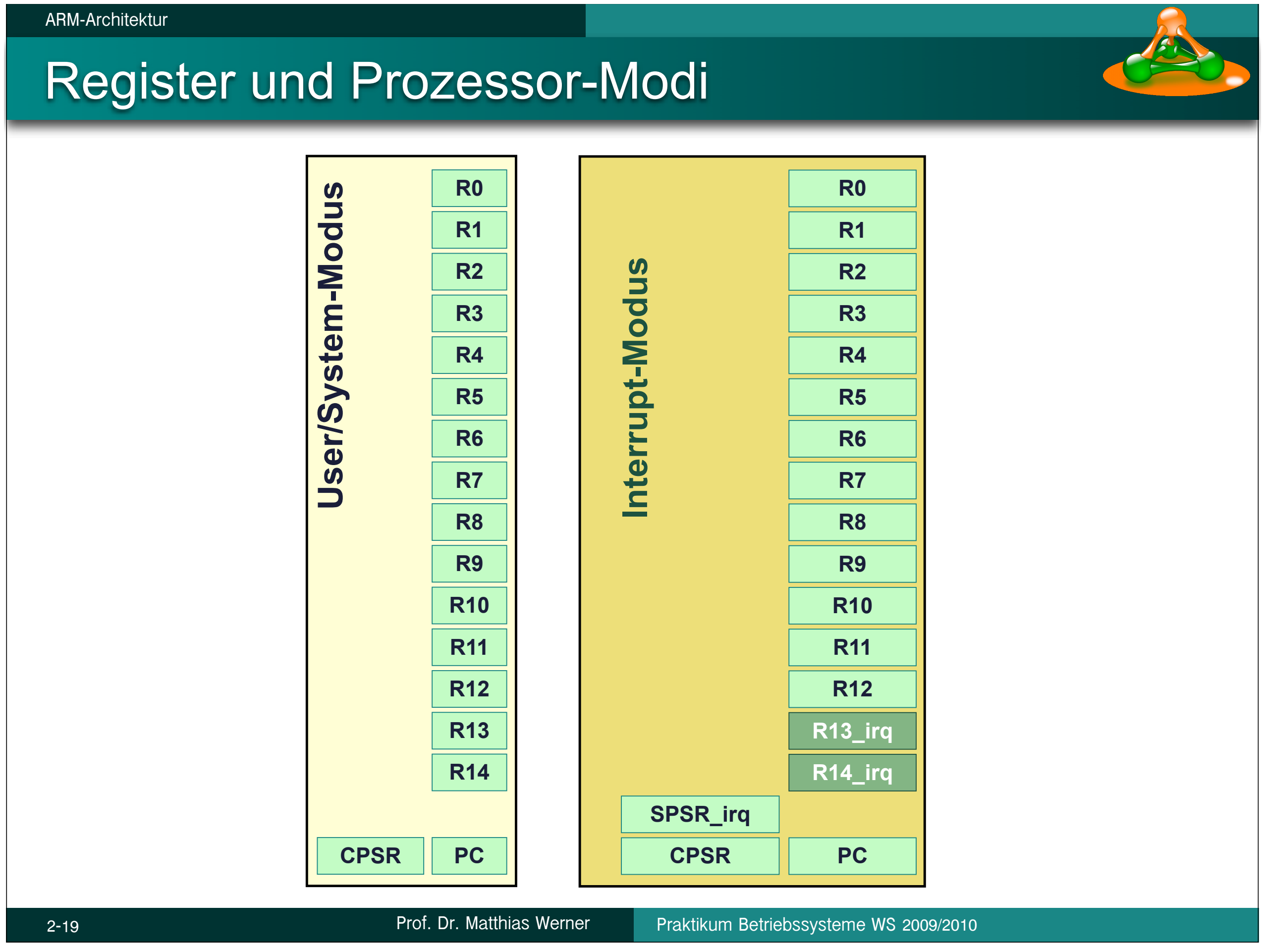
[picture p28: figure]
ARM-Architektur Register und Prozessor-Modi; CPSR; R13_irq; R14_irq; Interrupt-Modus; SPSR_irq; User/System-Modus
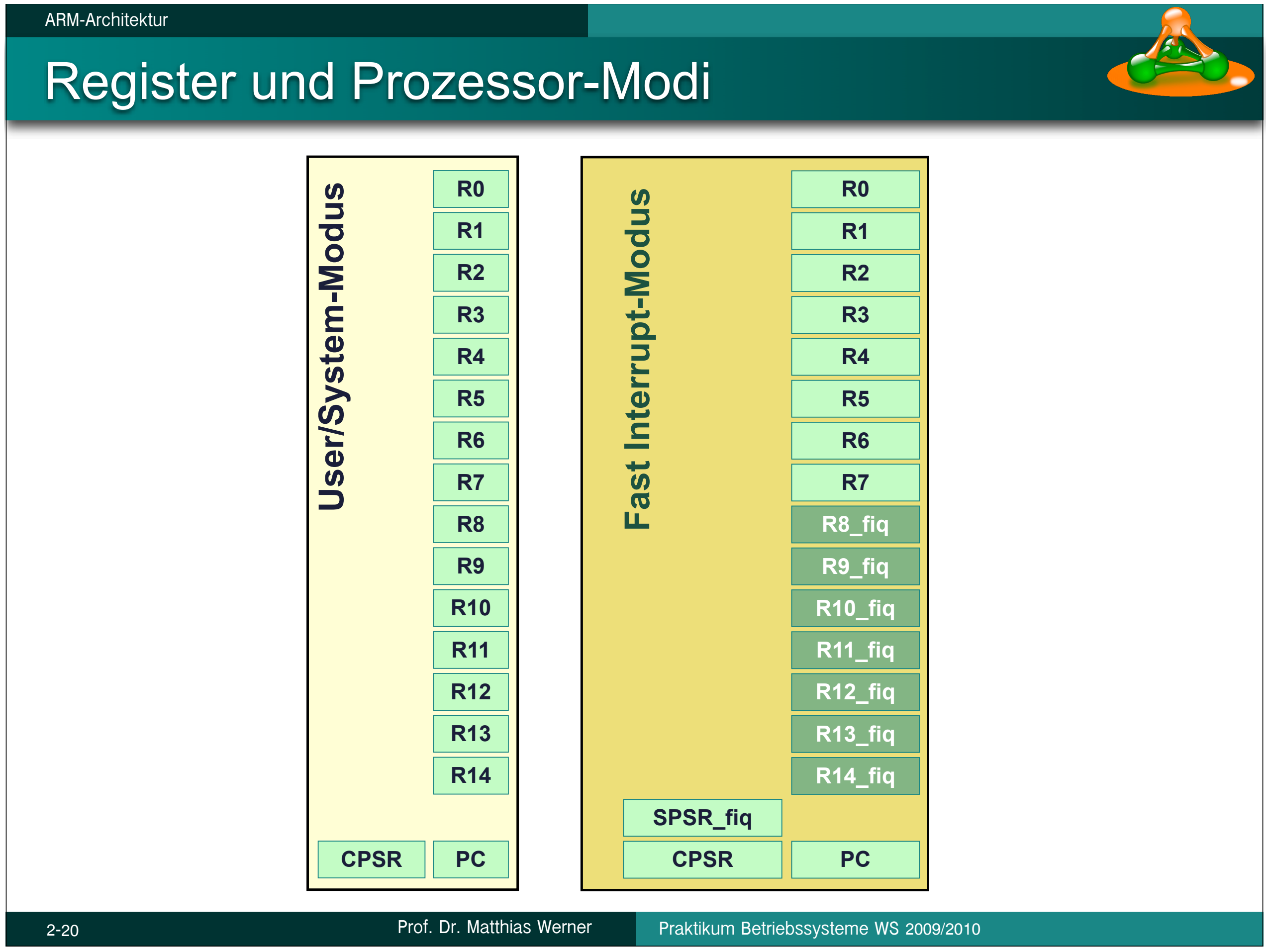
[picture p29: figure]
ARM-Architektur Register und Prozessor-Modi; CPSR; R8_fiq; R9_fiq; R10_fiq; R11_fiq; R12_fiq; R13_fiq; R14_fiq; Fast Interrupt-Modus; SPSR_fiq; User/System-Modus

Prof. Dr. Matthias Werner | Praktikum Betriebssysteme WS 2009/2010
2-

## Prozessor-Statusregister

- i&Ei"9,eMK\&3&Ei2$$K\&N&Er;"%0%,9K&2#'&a&Er;"%$,2=K&+/#'&:"'/#92#9+L S$,9+
- uZ&i2%&/#&8La,%/,#0"&,$+&r;"%$,2=&=>%&"%7"/0"%0"&dD(LA#+0%21e)#"#
- A&2#'&SZ&S>%&A#0"%%240L&;*7]&S,+0&A#0"%%240LC)'"
- FZ&F.26;LC)'"
- C&1)'/"%0&'"#&C)'2+&'"%&N(Y
- N(D@Z&N2%%"#0&(%)9%,6&D0,02+&@"9/+0"% B102"$$"%&(%)*"++)%L32+0,#'
- D(D@Z&D,M"'&(%)9%,6&D0,02+&@"9/+0"% (%)*"++)%L32+0,#'&M)%&$"0*0"6&C)'2+L`"-.+"$

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
### Undefiniert

26 | 8

21

M4..M0 | Mode
10000 | usr
10001 | fiq
10010 | irq
10011 | svc
10111 | abt
11011 | und
11111 | sys
Prof. Dr. Matthias Werner | Praktikum Betriebssysteme WS 2009/2010
2-

## Ausnahmen (Exceptions)

- `"##&"/#"&B2+#,.6"&,2c%/O\&9"+-./".0&S)$9"#'"+Z

### R14_<exception_mode> = return link SPSR_<exception mode> = CPSR CPSR[4:0] = exception mode number CPSR[5] = 0 ; Execute in ARM state If <exception_mode> = RESET or FIQ CPSR[6] = 1 ; Disable FIQs CPSR[7] = 1 ; Disable IRQs PC = exception vector address

22

ARM-Architektur

## Ausnahmen (Exceptions)

- S>%&q"'"&B2+#,.6"&9/;0&"+&"/#"#&8/#0%,9&/#&'"%&A#0"%%240La"10)%LF,;"$$"&EAaFK
- r;$/-.Z&A#0"%%240La"10)%LF,;"$$"&"#0.?$0&B'%"++"#&'"%&:".,#'$2#9+%)2e#"#
- !"#$%&'()*+,)-+.)!/01!.23,4+546.)+743894)-,+):74+..6;41<+54=.1$>?+99+) >6@AB3.?>.+7)"=-+(
C(N&v&"X-"4e)#&M"-0)%&,''%"++K ▶5/$/'%('$&1-$%6&$%6&.6N%/$`"-'$P_F$@6'S$.1-$L%-3:N1&N
▶?aN*68(0%6'%&
<D4%2#9&%"$,eM&*26&(%)9%,66*?.$"%&)'"%&@"9/+0"% <D4%2#9&6/0&3/"$,'%"++"&/#&@"9/+0"% <D4%2#9&6/0&3/"$,'%"++"&/#&D4"/-."%&%"$,eM&*2&(%)9%,66*?.$"%&)'"%&@"9/+0"% <D)=)%e9"%&@>-1+4%2#9
▶7:80/J-1&N$21/$>1/&2(D%;%(2&+*1&N$%-3"-+%-'$7:80/%'.1&N$+%/$?"+1/$
P!,!7$!$#,!7S$1&+$M7$!$,#
23 | Prof. Dr. Matthias Werner | Praktikum Betriebssysteme WS 2009/2010

ARM-Architektur

## Ausnahmen (Exceptions): Interrupt-Vektor-Tabelle

Art der Ausnahme | Modus | Adresse IVT | Adresse HV

Reset

Undefined
Instruction

Software Interrupt

Prefetch Abort

Data Abort

IRQ (Interrupt)

FIQ (Fast IRQ)

Supervisor

Supervisor

Abort

Abort

IRQ

FIQ

Undefined

0x00000000

0x00000008

0x0000000C

0x00000010

0x00000018

0x0000001C

0x00000004

0xFFFF0000

0xFFFF0008

0xFFFF000C

0xFFFF0010

0xFFFF0018

0xFFFF001C

0xFFFF0004

IVT: Standard-Adresse
HV: Alternative Adresse im hohen Speicherbereich

Prof. Dr. Matthias Werner | Praktikum Betriebssysteme WS 2009/2010
2-

## Ausnahmen (Exceptions): Prioritäten

- B2+#,.6"#&/#&,;+0"/9"#'"%&(%/)%/0?0
HX7%/%'
FX92'2$>;"-'
_Xb2/'$[&'%--1J'$7%c1%/'
BX[&'%--1J'$7%c1%/'
]X,-%3%'8($>;"-'
dXT&+%e&%+$[&/'-184"&$ $ | P!"##$#%#&'()%*+,+--$-%+./,$)$#0
dX!"fO2-%$[&'%--1J'$ $ | $$$$$$$$1+,.2%3-$&'($%4,&5,&)6)S
- 8#0+-."/'"0&>;"%&@"/."#=)$9"&'"%&:".,#'$2#9&;"/&9$"/-.*"/e9"6&B2c%"0"#
- B2+#,.6"#&1p##"#&'2%-.&B2+#,.6"#&2#0"%;%)-."#&7"%'"# ▶[&'%--1J'$1&+$b2/'$[&'%--1J'$0a&&%&$N%/J%--'$O%-+%&
▶<=.@,234(
@%(2&+*1&N/-"14&%&$D://%&$%&'/J-%8(%&+$J-"N-2DD6%-'$O%-+%&
25 | Prof. Dr. Matthias Werner | Praktikum Betriebssysteme WS 2009/2010
2-

## Befehlssätze

- B@CLC)'"
- D0,#',%'LC)'2+
- 8/#*/9&6p9$/-."%&C)'2+&=>%&B2+#,.6"L:".,#'$2#9
- _T&A#+0%21e)#"#
- S>%&(%,1e126&%"$"M,#0&2#'&/6&S)$9"#'"#&M)%9"+0"$$0
- F.26;LC)'2+
- Vp."%"&N)'"Ld/-.0"&'2%-.&HRL:/0LA#+0%21e)#"#
- ^U&:,+/+LA#+0%21e)#"#
▶`"#/9"%&6?-.e9&,$+&B@C
▶`"-.+"$&q"'"%*"/0&6p9$/-.Z&:w&E:%,#-.L,#'L8X-.,#9"K&;"/&9"+"0*0"6&2#0"%+0"#&:/0&'"%& B'%"++"
- a)#&(%,1e126+.,%'7,%"&2#0"%+0>0*0\&,;"%&/6&(%,1e126&#/-.0&%"$"M,#0
- h,*"$$"LC)'2+
- :"+-.$"2#/90"&B2+=>.%2#9&M)#&h,M,L:<0"-)'"
- i/-.0&7"/0"%&/6&d"0,/$&)t"#9"$"90
- a)#&(%,1e126+.,%'7,%"&#/-.0&2#0"%+0>0*0

26

ARM-Architektur

## ARM-Befehlssatz

- B$$"&A#+0%21e)#"#&+/#'&^I&:/0&$,#9
- D".%&+0%2102%/"%0"&!)'/"%2#9Z&+"6,#e+-.&?.#$/-."&A#+0%21e)#"#&7"%'"#& ,2-.&?.#$/-.&1)'/"%0
- :"'/#90"&B2+=>.%2#9&>99+.&A#+0%21e)#"# ▶g;"%"&:/0+&EIUL^HK&+/#'&+0"0+&=>%&'/"&:"'/#92#9&%"+"%M/"%0 ▶!"/#"&:"'/#92#9Z&B[&E,$7,<+K
- B'%"++/"%2#9+6)'/
▶37"/&)'"%&'%"/&g4"%,#'"#&E3/"$\&u2"$$"\&)4e)#,$"&u2"$$"K ▶3/"$&2#'&)4e)#,$"&u2"$$"&,DD+.&@"9/+0"% ▶u2"$$"Z&QD./c"%Lg4"%,#'m&f&1,##&/##"%.,$;&"/#"+&3<1$2+&26&/#&'"%&A#+0%21e)#& ,#9"9";"#"#&`"%0&M"%+-.);"#&7"%'"#
▶h"&#,-.&F<4&'"+&:"=".$+&2#0"%+-./"'$/-."&Y#0"%=)%6,0"
- d"0,/$+Z&i?-.+0"&S)$/"#&2#'&B@C&B%-./0"-02%"&@"="%"#-"&C,#2,$
27 | Prof. Dr. Matthias Werner | Praktikum Betriebssysteme WS 2009/2010

ARM-Architektur

## ARM-Befehlssatz

- B$$9"6"/#"&A#+0%21e)#+=)%6Z
<opcode>{<cond>}{S} <Rd>, <Rn>, <shifter_operand>
- @'Z&3/"$
- @#Z&)4e)#,$"&u2"$$"E#K
- N)#'Z&:"'/#92#9E"#K
▶`%&&$&68('$2&N%N%;%&=$>M$P2*O2\/S
- DZ&DL:/0
▶!'%1%-1&N$+%-$!'2'1/Rb*2N/ ▶!'%1%-1&N$+%-$?"+1/RTD/8(2*'1&N%&

Prof. Dr. Matthias Werner | Praktikum Betriebssysteme WS 2009/2010
2-

## Befehlstypen

- :%,#-.LA#+0%21e)#"#
- d,0"#M"%,%;"/0"#'"&A#+0%21e)#"#
- C2$e4$/1,e)#+LA#+0%21e)#"#
- D0,02+%"9/+0"%LA#+0%21e)#"#
- [),'WD0)%"LA#+0%21e)#"#
- [),'WD0)%"LC2$e4$"LA#+0%21e)#"#
- D"6,4.)%LA#+0%21e)#"#
- A#+0%21e)#"#\&'/"&B2+#,.6"#&9"#"%/"%"#
- !)4%)*"++)%LA#+0%21e)#"#
29 | Prof. Dr. Matthias Werner | Praktikum Betriebssysteme WS 2009/2010
2-

## Branch-Instruktionen

B{<cond>} <target_address> oder
BL{<cond>} <target_address>
- :"%"-.#"0&(N&"#0+4%"-."#'&3/"$,'%"++"
- 3/"$,'%"++"&7/%'&;"%"-.#"0
- d/%"10"&B#9,;"#&"/#"+&^IL:/0L3/"$"+&/+0&7,234&6p9$/-.
- C"/+0&/#'/%"10&)'"%&%"$,eM
- [Z&C/0&[/#1%"9/+0"%
- @>-1+4%2#9&E,$+)&B'%"++"&#,-.&:[K&7/%'&/#&[/#1%"9/+0"%&E[@\&@HTK&9"+4"/-."%0
- !,##&=>%&Y#0"%4%)9%,66,2=%2="&;"#20*0&7"%'"#&E[@&%"O"#&;"/&D-.,-.0"$2#9K
- @>-1+4%2#9Z&MOV PC,LR

30

ARM-Architektur

## Datenverarbeitende Instruktionen

<opcode>{cond}{S} Rd,Rn,<Op2>
- B$$"&;"1,##0"#&,%/0.6"e+-."#\&$)9/+-."#&2#'&a"%9$"/-.+)4"%,e)#"#&6/0& B2+#,.6"&M)#&C2$e4$/1,e)#&2#'&d/M/+/)#
- xg4IyZ&D./c"%Lg4"%,#'&)'"%&B2+'%2-1
- :"/+4/"$"Z
ADD R1,R2,R3 ; R1:=R2+R3
ADDEQ R2,R4,R5 ; Wenn Z-Flag dann R2:=R4+R5
TEQS R4,#3 | ; Teste R4==3
MOV PC,R14 | ; Rückkehr von Unterprogramm
MOV R0,R0 | ; Leer-Instruktion (NoOP)
31 | Prof. Dr. Matthias Werner | Praktikum Betriebssysteme WS 2009/2010

ARM-Architektur

## Multiplikations-Instruktionen

MUL{L}{cond}{S} Rd,Rm,Rs
MLA{L}{cond}{S} Rd,Rm,Rs,Rn
- ?1*4J*6024"&$1&+$?1*4J*6024"&g>++64"& ▶h%O%6*/$3:-$_F@6'$X&_F@6'$!$_F@6'$P";%-%$@6'/$2;N%/8(&6W%&S$1&+$ ▶_F@6'$Y$_F@6'$!$dB@6'$PM$i$M"&NU$.1/)'.*68($/6N&%+j1&/6N&%+S
- @%6/J6%*%=
MUL R1,R2,R3 | ; R1:=R2*R3
MLA R1,R2,R3,R4 | ; R1:=R2*R3+R4

SMULL R1,R4,R2,R3 ; {R4,R1}:=R2*R3, signed
UMLAL R1,R5,R2,R3 ; {R5,R1}:=R2*R3+{R5,R1}, unsigned
- 5/$%Y6/4%-'$5+,7+$96A6/6"&U$D1//$J%-$@6;*6"'(%0$"+%-$Z"J-".%//"-$-%2*6/6%-'$O%-+%&$ !$L"-/68('$;%6$+%-$@%&1'.1&N$6D$,-20401D

Prof. Dr. Matthias Werner | Praktikum Betriebssysteme WS 2009/2010
2-

## Statusregister-Instruktionen

MRS Rd,CPSR
MSR CPSR,Rn
- 8%$,2;"#&329%/t&,2=&D0,02+%"9/+0"%
- Y6+-.,$02#9"#&'"%&C)'/
- D4"%%"#WS%"/9";"#&M)#&A#0"%%240+
- :"/+4/"$Z&C)'2+7"-.+"$
MRS R0,CPSR | ; Kopiere CPSR nach R0
BIC R0,R0,#0x1F | ; Modus-Bits löschen
ORR R0,R0,#new_mode ; Neuen Modus setzen
MSR CPSR,R0 | ; Zurückschreiben
33 | Prof. Dr. Matthias Werner | Praktikum Betriebssysteme WS 2009/2010
2-

## Load/Store-Instruktionen

<LDR|STR>{cond}{B}{T} Rd,<Address>
- >+-%//%$O6-+$2*/$>1/+-180$;%-%8(&%'
- !%(-$A6%*%$?aN*68(0%6'%&=$!6%(%$k2&+;18(
- ?%6/'$-%*24AU$6&+6-%0'$"+%-$:;%-$7%N6/'%-U$+2$0%6&%$_FR@6'R`%-'%$DaN*68($/6&+
- T&D6W%*;2-RlJ%-2&+%&=$7%*24A$:;%-$,#
- @=$@\'%O%6/%U$/"&/'$O"-'O%6/%
- @%6/J6%*%=
LDR R1,[R2,#16] ; Lade R1 mit Inhalt von ; Adresse (R2+16)
STR R1,[R2,R4]! ; Speichere R1 auf Adresse
; (R2+R4) und schreibe
; Adresse nach R2
STR R1,[R2],R4 ; Speichere R1 nach Adresse in R2 ; und schreibe R2+R4 zurück ; nach R2

34

ARM-Architektur

## Load/Store-Multiple-Instruktionen

<LDM|STM>{cond}<FD|ED|FA|EA|IA|IB|DA|DB> Rn{!},<Rlist>{^}
- 8%$,2;0&',+&[,'"#&M)#&@"9/+0"%#&6/0&'"6&A#.,$0&>6A+,7>7-+.A=9E+7-+. D4"/-."%,'%"++"#&;*7]&',+&D4"/-."%#&M)#&@"9/+0"%#&,#&,2="/#,#'"%=)$9"#'"& D4"/-."%,'%"++"#
- C".%"%"&a,%/,#0"#Z
- AB\&A:\&dB\&d:Z
AZ&A#-%"6"#0\&dZ&d"-%"6"#0\&:Z&:"=)%"\&BZ&Bc"%
- Sd\&8d\&SB\&8BZ&S>%&D0,-1)4"%,e)#"#&E#?-.+0"&S)$/"K
- :"/+4/"$Z&STMDA R13!, {R0 - R12, LR}
- DFdCB&f&D0)%"&C2$e4$<&d"-%"6"#0&Bc"%
- A#'"X%"9/+0"%&7/%'&#,-.&q"'"6&D-.%/O&'"1%"6"#e"%0
- @H^&/+0&A#'"X%"9/+0"%&6/0&'"%&:,+/++4"/-."%,'%"++"
- z&;"+,90\&',++&@H^&#,-.&q"'"6&D-.%/O&,102,$/+/"%0&7/%'
- @JL@HI&2#'&[@&+/#'&'/"&@"9/+0"%\&'/"&/#&'"#&D4"/-."%&1)4/"%0&7"%'"#&+)$$"#
- B;$,2=Z&@J&#,-.&B'%"++"\&'/"&/#&@H^&+0".0\&@H^&26&T&'"1%"6"#e"%"#\&@H&,#&'/"+"&B'%"++"\&
2+7]
35 | Prof. Dr. Matthias Werner | Praktikum Betriebssysteme WS 2009/2010

ARM-Architektur

## Load/Store-Multiple-Instruktionen

### - A+0&#>0*$/-.&;"/6&Y69,#9&6/0&'"6&D0,-1Z& !,##&"/#"#&9,#*"#&D,0*&M)#&d,0"#&M)6&D0,-1&/#&'/"&@"9/+0"%& 1)4/"%"#&E)'"%&269"1".%0K&6/0&B102,$/+/"%2#9&'"+&D(

- @/-.02#9&'"+&D0,4"$LP`,-.+026+Q&7/%'&'2%-.&[dCWDFCL:"=".$&="+09"$"90
- 8+&9".p%"#&/66"%&P9$"/-.$,20"#'"Q&:"=".$"&*2+,66"#Z B2=&D0,-1&$"9"#&6/0&DFCSd&"%=)%'"%0&["+"#&6/0&[dCSd
- Cp9$/-.1"/0"#Z&Sd\&8d\&SB\&8B ▶b1**=$5-/'$I%6N%-$)&+%-&U$+2&&$/8(-%6;%& ▶5DJ'\=$5-/'$/8(-%6;%&U$+2&&$I%6N%-$)&+%-& ▶>/8%&+6&N=$>13/'%6N%&+%-$!'2J%*U$!C?$N%('$&28($";%&U$M9?$&28($1&'%& ▶9%/8%&+6&N=$>;/'%6N%&+%-$!'2J%*U$!C?$N%('$&28($1&'%&U$M9?$&28($";%&

Prof. Dr. Matthias Werner | Praktikum Betriebssysteme WS 2009/2010
2-

## Atomare Swap (für Semaphore)

<SWP>{cond}{B} Rd,Rm,[Rn]
- D`(&ED7,4K&2#'&D`(:&ED7,4&:<0"K&"%$,2;"#&,0)6,%"&["+"WD-.%"/;"L g4"%,e)#"#
- :"/+4/"$&HZ
! SWP R1, R2, [R3]
▶7_$%&'()*'$!J%68(%-2+-%//% ▶!`,$*)+'$7H$D6'$+6%/%-$!J%68(%-2+-%//%$1&+$/8(-%6;'$7F$2&$+6%/%$>+-%//%
- :"/+4/"$&IZ
! SWP R1, R1, [R2]
▶7F$%&'()*'$!J%68(%-2+-%//% ▶!`,$'21/8('$[&(2*'$A"&$7H$1&+$+%-$!J%68(%-2+-%//%
- B0)6/*/0?0&+0"$$0&+/-."%\&',++&"+&1"/#"&Y#0"%;%"-.2#9&*7/+-."#&'"#&F"/$"#&'"%&
g4"%,e)#&9";"#&1,##
37 | Prof. Dr. Matthias Werner | Praktikum Betriebssysteme WS 2009/2010
2-

## Trap

SWI{cond}

- [p+0&"/#"#&D)c7,%"LA#0"%%240&EF%,4K&,2+ ▶`%8(/%*'$6&$!1J%-A6/"-R?"+% ▶,#$O6-+$213$GYm$N%/%'.'
▶M7$/J%68(%-'$7:80/J-1&NR>+-%//%
- !,##&*2%&@",$/+/"%2#9&M)#&D<+0"6%2="#&;"#20*0&7"%'"# ▶7%N6/'%-$GR_$0a&&%&$.1-$T&'%-/8(%6+1&N$A%-/8(6%+%&%-$b1&04"&%&$;%&1'.'$ O%-+%&

38

ARM-Architektur

## Koprozessor-Instruktionen

- >7?R9%/6N&$%-DaN*68('$%6&328(%$5-O%6'%-1&N%&$+1-8($+6%$Z"J-".%//"-R >-8(6'%0'1-
- :/+&*2&HR&!)4%)*"++)%"#&,#&"/#"6&B@CL!"%#
- B@C&/+0&=>%&S$2s+0"2"%2#9&*2+0?#'/9
- [,9"%0&:"%"-.#2#9"#&,2+
- !)662#/1,e)#&>;"%&:2+&2#'&B2+#,.6"# <`"##&1"/#&!)4%)*"++)%&%",9/"%0\&9/;0&"+&"/#"&2#'"l#"'LB2+#,.6" <:".,#'$2#9&'/"+"%&B2+#,.6"#&"%6p9$/-.0&D)c7,%"L862$,e)#
- Z"J-".%//"-%&=
- `/"&B@C&$),'W+0)%"
- :/+&*2&HR&@"9/+0"%
- :"$/";/9"&/#0"%#"&a"%,%;"/02#9+;%"/0"
- @%6/J6%*%=
- S$/"s1)66,L:"%"-.#2#9"#&ES(Y\&,2=&3/"$4$,5)%6&#/-.0&M)%.,#'"#K
- D<+0"6&N)#0%)$&(%)-"++)%&EN(H_&,2=&3/"$4$,5)%6\&+0"2"%0&2],]&CCY\&%"$"M,#0&=>%&
D4"/-."%+-.20*LB2=9,;"K
- d";29&N)662#/-,e)#&N.,##"$&EN(HT&,2=&3/"$4$,5)%6K
39 | Prof. Dr. Matthias Werner | Praktikum Betriebssysteme WS 2009/2010

ARM-Architektur

## Koprozessor-Instruktionen

CDP{cond} p#,<expression1>,cd,cn,cm{,<expression2>} <LDC|STC>{cond}{L} p#,cd,<Address>
<MCR|MRC>{cond} p#,<expression1>,Rd,cn,cm{,<expression2>}
- P#: Nummer des Koprozessors
- Ausdrücke werden zu einer Konstante berechnet und weitergegeben
- cd, cn und cm sind Koprozessor-Befehle und –Register
- CDP: Koprozessor-Datenoperationen
- LDC/STC: Koprozessor-Datentransfer
- MCR/MRC: Koprozessor-Registertransfer
- Beispiele:
CDP p1,10,c1,c2,c3 | ; CP1 führt Op. 10 auf c2 und c3
| ; durch und legt das Ergebnis nach c1
LDC p1,c2,table | ; Lade c2 von CP1 aus Tabelle relativ zu PC
MCR p6,0,R4,c5,c6 | ; CP6 führt Operation 0 auf R4 durch und
| ; schreibt Ergebnis nach c4
MRC p2,5,R3,c5,c6 | ; CP2 führt Operation 5 auf c5 und c6 durch
| ; und schreibt Ergebnis nach R3

Prof. Dr. Matthias Werner | Praktikum Betriebssysteme WS 2009/2010
2-

## Besonderheit: Bedingte Ausführung

- :"'/#90"&B2+=>.%2#9&,$$"%&A#+0%21e)#"#&+4,%0&D4%>#9"&"/#
- a"%;"++"%0&("%=)%6,#-"&ED4%2#9M)%."%+,9"\&(/4"$/#"K
- !)64,10"%"%&N)'"
- :"/+4/"$Z
if (a == 0)
{
b = 23;
}
else
{
b = 42;
c = a;
}
41 | Prof. Dr. Matthias Werner | Praktikum Betriebssysteme WS 2009/2010
2-

## Besonderheit: Bedingte Ausführung

- A#&AB^ILN)'"&E).#"&;"'/#90"&B2+=>.%2#9&,$$"%&:"=".$"K

TEST EAX, EAX
JNE _else
MOV EBX, 23
JMP _done
_else: MOV EBX, 42
MOV ECX, EAX
_done:

42

ARM-Architektur

- In ARM-Code (ohne bedingte Ausführung aller Befehle) TEQ R0, #0
BNE else
MOV R1, #23
B done
else: MOV R1, #42
MOV R2, R0
done:
- In ARM-Code (mit bedingter Ausführung aller Befehle) TEQ R0, #0
MOVEQ R1, #23
MOVNE R1, #42
MOVNE R2, R0

## Besonderheit: Bedingte Ausführung

ARM-Architektur

## Besonderheit: Shifter-Operand

- A##"%.,$;&"/#"%&g4"%,e)#&1,##&"/#&u2"$$)4"%,#'&M"%+-.);"#&)'"%&%)e"%0& 7"%'"#Z
MOV R1, R0, LSL #3 | ; R1 := R0 * 8
ADD R3, R2, R1, LSR #2 | ; R3 := R2 + R1 / 4
MOV R3, R2, ROR R1 | ; R2 um R1 nach
| ; rechts rotieren
| ; und Wert in R3
| ; laden

Prof. Dr. Matthias Werner | Praktikum Betriebssysteme WS 2009/2010
2-

## Besonderheit: S-Bit

- a/"$"&B@CL:"=".$"&.,;"#&"/#&S"$'&=>%&',+&DL:/0
- :"'"202#9&M,%//"%0&6/0&!)#0"X0
- gcZ
▶`"##&(N&#/-.0&,$+&3/"$&,#9"9";"# <D"0*"&:"'/#92#9+{,9+
<:"#20*"&Y+"%L@"9/+0"%&+0,O&6)'2+L+4"*/l+-."#&@"9/+0"%# ▶`"##&(N&,$+&3/"$&,#9"9";"# <[,'"&#,-.&B2+=>.%2#9&N(D@&6/0&A#.,$0&M)#&D(D@
- b"#,2"&A#0"%4%"0,e)#&/+0&M)#&:"=".$&2#'&32+0,#'&,;.?#9/9
- :"/+4/"$Z&LDM/STM&6/0&9"+"0*0"6&DL:/0 ▶[dC&6/0&(N&/#&F%,#+="%$/+0"Z&D(D@|6)'"&!&N(D@ ▶DFC&6/0&(N&/#&F%,#+="%$/+0"Z&Y+"%L&+0,O&C)'2+L@"9/+0"% ▶@H_&#/-.0&/#&F%,#+="%$/+0"Z&Y+"%L&+0,O&C)'2+L@"9/+0"%
- a"%7"#'2#9Z&@>-11".%&,2+&B2+#,.6";".,#'$2#9"#Z
MOVS PC,LR
45 | Prof. Dr. Matthias Werner | Praktikum Betriebssysteme WS 2009/2010
2-

## Thumb-Befehlssatz

- HR&:/0&A#+0%21e)#+$?#9"
- ^U&:,+/+LA#+0%21e)#"#
- h"'"%*"/0&329%/t&,2=&U&@"9/+0"%&E@JL@jK
- 8/#*"$#"&A#+0%21e)#"#&;/"0"#&,2-.&329%/t&,2=&(N&E@H_K\&[@&E@HTK\&D(&E@H^K& )'"%&V/9.&@"9/+0"%+&E@UL@H_K
- `"-.+"$&*2%&[,2=*"/0&E6/0&:w\&:[w\&D(D@\[d@W[dCK
- B2+#,.6"#&7"%'"#&,DD+.),D)!/010=-6@&;".,#'"$0&f&/#&q"'"6&B@CL D<+0"6&"X/+e"%0&',6/0&9"6/+-.0"%&N)'"
- a)#&(%,1e126+.,%'7,%"&2#0"%+0>0*0
- A6&(%,1e126&#/-.0&7"/0"%&;"0%,-.0"0
- `"%&6,9\&',%=&9"%#"&F"/$"&'"+&gD&/6&F.26;LC)'2+&/64$"6"#e"%"#

46

ARM-Architektur

## Thumb-Befehlssatz

- :%,#-.LA#+0%21e)#"#
- d,0"#M"%,%;"/0"#'"&A#+0%21e)#"#
- F+,7+&C2$e4$/1,e)#+LA#+0%21e)#"#
- F+,7+&D0,02+%"9/+0"%LA#+0%21e)#"#
- [),'WD0)%"LA#+0%21e)#"#
- [),'WD0)%"LC2$e4$"LA#+0%21e)#"#
- F+,7+&D"6,4.)%LA#+0%21e)#"#
- A#+0%21e)#"#\&'/"&8X-"4e)#+&9"#"%/"%"#
- F+,7+&!)4%)*"++)%LA#+0%21e)#"#
47 | Prof. Dr. Matthias Werner | Praktikum Betriebssysteme WS 2009/2010

ARM-Architektur

## Thumb-Befehlssatz

- A#+0%21e)#+=)%6Z
<opcode> <Rd>, <Rn>, <3rd_operand>
- ^]&g4"%,#'Z&@"9/+0"%&)'"%&12%*"%&A66"'/,0"L`"%0

Prof. Dr. Matthias Werner | Praktikum Betriebssysteme WS 2009/2010
2-

## Speicher

- B@CL!"%#&+0"$$0&^IL:/0L:2++"&=>%&B'%"++"#&2#'&d,0"#&;"%"/0 ▶Z2&&$;%6$;\'%O%6/%-$>+-%//6%-1&N$D2Y6D2*$B$V@$2+-%//6%-%&
- !"%#&1,##&D4"/-."%M"%7,$02#9+"/#."/0&EC"6)%<&C,#,9"6"#0&Y#/0\&CCYK& "#0.,$0"#
▶lJ4"&2*U$&68('$;%6$2**%&$Z%-&%&
▶>7?EFGC$(2'$??T
- a"%7"#'2#9&'"%&B'%"++$"/02#9"#&'"+&!"%#+&.?#90&M)#&A64$"6"#0,e)#&'"%& ("%/4."%/"&,;
- (%,1e126Z&
BFGH@CGIJJ&/#&'"%&!)#l92%,e)#&'"%&3/"$4$,5)%6 ▶[&'%-&%$!J%68(%-;%-%68(%$PC%6*$+%/$>CEH7?EFGGS
▶5Y'%-&%$!J%68(%-;%-%68(%$P+1-8($C2/06'$(6&.1N%3:N'S
▶>13$!J%68(%-$2;N%;6*+%'%$56&j>1/N2;%$PD%D"-\RD2JJ%+$[jlS
49 | Prof. Dr. Matthias Werner | Praktikum Betriebssysteme WS 2009/2010
2-

## Speicher der Zielplattform

- b$/"'"%0&'/"&^I&B'%"++$"/02#9"#&,2=&/# ▶B$@6'$3:-$+6%$>1/O2(*$%6&%-$n#(6JR/%*%8'$7%N6"&o ▶Fm$@6'$3:-$+6%$>+-%//6%-1&N$6&&%-(2*;$+%-$#(6JR/%*%8'R7%N6"&
- A'""&',;"/Z
▶5-DaN*68('$213$%6&328(%$`%6/%$+6%$[&'%N-24"&$/%(-$1&'%-/8(6%+*68(%-$!J%68(%-$ ▶>1/O2(*$+%-$#(6JR/%*%8'R7%N6"&$N%&%-6%-'$n#(6JR/%*%8'oR!6N&2*$3:-$h%O%6*/$%6&%$ Z"DJ"&%&'%$PA%-/8(6%+%&%$!J%68(%-U$[jlS
- F.")%"e+-.Z&HR&@"9/)#"#&EITvHRK
- (%,1e+-.Z
▶m$7%N6"&%&$P#!G$;6/$#!QS$A"&$h%O%6*/$F]d$?@$PFIU&@\'%S ▶F$/J%.6%**%$@%-%68(%
<A#0"%#"&D4"/-."%
<8/#WB2+9,;"
▶I1N-6p$213$:;-6N%$7%N6"&%&$3:(-'$.1-$>;"-'R>1/&2(D%

50

ARM-Architektur

## Speicher der Zielplattform

<=.@,234(
- 7%2*%-$!J%68(%-$6/'$D%6/'$ 0*%6&%-$2*/$+6%$%&'/J-%8(%&+%$ 7%N6"&
- I1N-6p$n+2(6&'%-o$3:(-'$.1D$ n`-2JR>-"1&+o
- 329%/t&6)'2$)&b%ps"&'"+&%",$"#& D4"/-."%+
- b"#"%/"%0&1"/#"&B2+#,.6"
- S>.%0&*2&P/#0"%"++,#0"#Q&8t"10"#
0x00000000-0x0FFFFFFF | Interne Speicher
0x10000000-0x1FFFFFFF | CS0 16 MB ext. Flash
0x20000000-0x2FFFFFFF | CS1 64 MB ext. RAM
0x30000000-0x3FFFFFFF | CS2
0x40000000-0x4FFFFFFF | CS3
0x50000000-0x5FFFFFFF | CS4
0x60000000-0x6FFFFFFF | CS5
0x70000000-0x7FFFFFFF | CS6
0x80000000-0x8FFFFFFF | CS7
0x90000000- | Undefiniert
| (abort-Ausnahme
| bei Zugriff)

-0xEFFFFFFF

0xF0000000-0xFFFFFFFF | Interne Peripherie
0x00000000 | Boot-Speicher
0x00100000 | Internes ROM (128k)
0x00200000 | Internes RAM (16k)
0x00300000 | USB-Host-Interface
0x00400000 | Undefiniert (abort)
51 | Prof. Dr. Matthias Werner | Praktikum Betriebssysteme WS 2009/2010

ARM-Architektur

## Boot-Speicher

- >7?RZ%-&$/'2-'%'$D6'$>1/3:(-1&N$213$>+-%//%$GYGGGGGGGG
- I1-$5-6&&%-1&N=$9"-'$*6%N'$+%-$7%/%'RL%0'"-
- ,-";*%D=$>&$+6%/%-$!'%**%$+2-3$;%6D$>&/8(2*'%&$0%6&$q:8(4N%-$!J%68(%-$*6%N%&r
- >CEH7?EFGG$02&&$6&$>;()&N6N0%6'$A"&$%6&%-$%Y'%-&%&$M%6'1&N$P@?!S$1&+$+%D$ n7%D2JoRZ"DD2&+"$A%-/8(6%+%&%$!J%68(%-$+"-'(6&$2;;6*+%&=
- a)%&@"6,4\&:CDvvJZ&NDJ&E"X0"%#"%&S$,+.K
- a)%&@"6,4\&:CDvvHZ&A#0"%#"+&@gC
- i,-.&@"6,4Z&A#0"%#"+&@BC
- I6%*J*2K"-D=$@?!iiG
@""'%'$+2D6'$21/$+%D$b*2/($+%&$@""'*"2+%-$TR@""'
- TD$+6%$[&'%--1J'RL%0'"-RC2;%**%&$)&+%-&$.1$0a&&%&U$D6@@$%6&$7%D2J$ +1-8(N%3:(-'$O%-+%&
- F,;"$$"#&$/"9"#&',##&/6&/#0"%#"#&@BC&,;&JXJJIJJJJJ
- !p##"#&,2-.&2#0"%&JXJJJJJJJJ&*29"9%/t"#&7"%'"#
- B$0"%#,eM"Z&Y6+-.,$0"#&,2=&P.)."Q&F,;"$$"#&,;&JXSSSSJJJJ

Prof. Dr. Matthias Werner | Praktikum Betriebssysteme WS 2009/2010
2-

## Memory Management Unit

- B@CGIJF&"#0.?$0&D4"/-."%M"%7,$02#9+"/#."/0&EC"6)%<&C,#,9"6"#0&Y#/0\& CCYK
▶7%2*6/6%-'$!J%68(%-A6-'12*6/6%-1&N ▶>;;6*+1&N$A6-'1%**%-$>+-%//%&$213$J(\/602*6/8(% ▶>;;6*+1&N$O6-+$+1-8($!%6'%&'2;%**%&$+%e&6%-' ▶C-2&/J2-%&'$3:-$+%&$Z%-&
▶7%2*6/6%-'$.1/)'.*68($!J%68(%-/8(1'.$P?%D"-\$,-"'%84"&$T&6'U$?,TS ▶`6-+$:;%-$Z"J-".%//"-$H]$N%/'%1%-'
- !,##&4.<+/1,$/+-."+&D4"/-."%$,<)20&M)$$+0?#'/9&M"%;"%9"#
- <=.@,234(
▶b:-$N%.6%*'%D$I1N-6p$213$;%/4DD'%$>+-%//%&$P.X@X$[&'%--1J'RL%0'"-RC2;%**%U$56&j >1/N2;%S$D1//$3:-$%&'/J-%8(%&+%$>;;6*+1&N$N%/"-N'$O%-+%&
- `/%'&'2%-.&:"0%/";++<+0"6&9"+0"2"%0

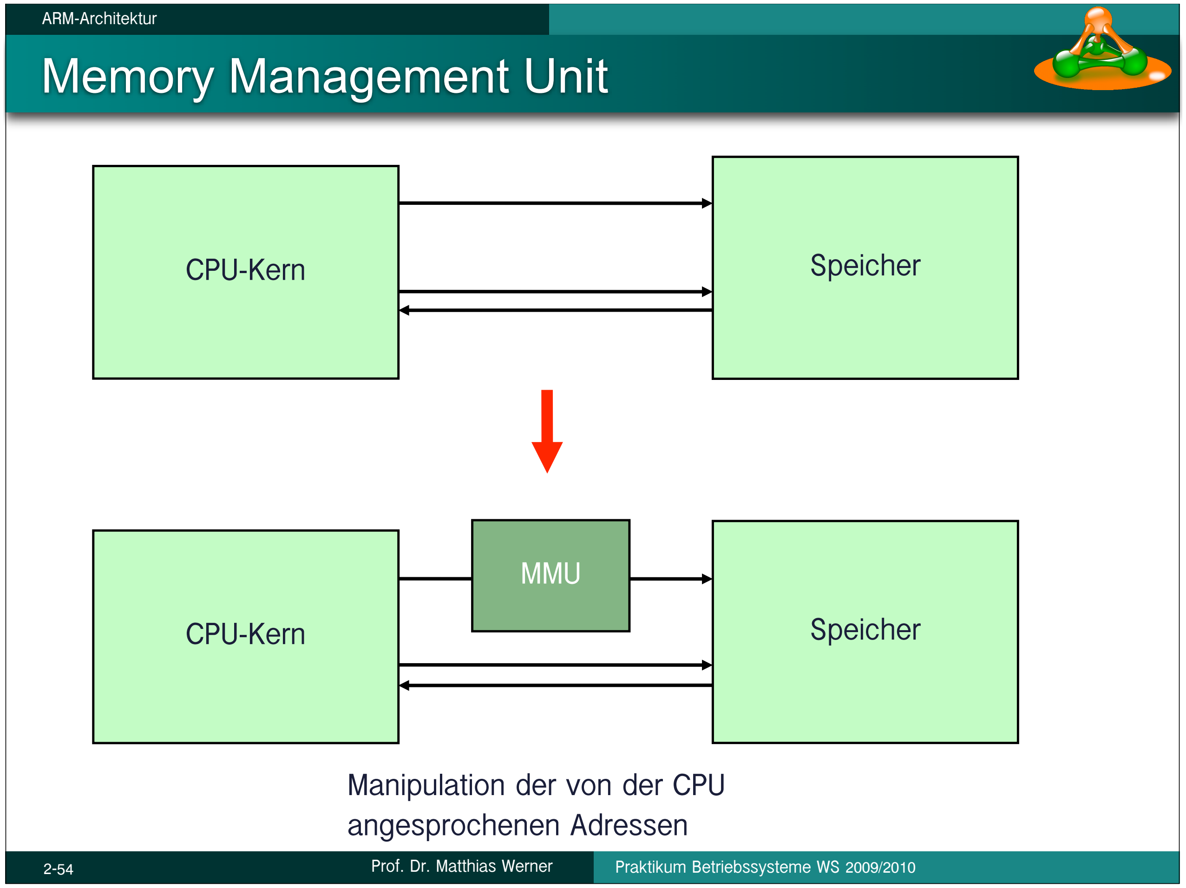
[picture p30: figure]
CPU-Kern; Speicher; Datenbus; Adressbus; MMU; Manipulation der von der CPU angesprochenen Adressen; Memory Management Unit

53 | Prof. Dr. Matthias Werner | Praktikum Betriebssysteme WS 2009/2010

ARM-Architektur

## Ein/Ausgabe

- >7?RZ%-&$0"DD1&6.6%-'$6D$>CEH7?EFGG$D6'$TDN%;1&N$P7%/'$+%/$!"#$1&+$ +%//%&$TD3%*+S$:;%-
- d,0"#WB'%"++;2+
- 37"/&A#0"%%240L["/02#9"#&EA@u&2#'&SAuK
- d";29LD-.#/O+0"$$"#&E9"+0"2"%0&M)#&!)4%)*"++)%&HTK
- F+,7+&'/%"10"#&8/#WB2+9,;"L["/02#9"#
- >13$!J%68(%-$2;N%;6*+%'%$56&j>1/N2;%$PD%D"-\RD2JJ%+$[jlS
- b"%?0&.,0&@"9/+0"%&=>%
<!)#l92%,e)#
<d,0"#,2+0,2+-.
- @"9/+0"%&7"%'"#&/#&'"#&B'%"++%,26&'"+&!"%#+&+,7E+?9+7-+4&EJXSSSBJJJJ&;/+& JXSSSSSSSSK
- 329%/t&=>.%0&*2&"#0+4%"-."#'"#&@",1e)#"#&'"+&b"%?0"+
- gc&1,##&',+&b"%?0&"/#"#&A#0"%%240&,2+$p+"#
<8%+4,%0&P()$$/#9Q
<:".,#'$2#9+%)2e#"&=%,90&',+&b"%?0&,;&2#'&=>.%0&,#9"=)%'"%0"&g4"%,e)#&'2%-.
55 | Prof. Dr. Matthias Werner | Praktikum Betriebssysteme WS 2009/2010

ARM-Architektur

## Ein/Ausgabegeräte des AT91RM9200 (Auswahl)

- (,%,$$"$&AWg&E(AgK
- d/%"10&+0"2"%;,%"&8/#WB2+9,;"$"/02#9"#
- :"/+4/"$Z&B#+0"2"%2#9&'"%&[8d+&E+/"."&:"/+4/"$4%)9%,66K
- D<+0"6L3"/09";"%
- !,##&4"%/)'/+-."&A#0"%%240+&9"#"%/"%"#
- A#0"%%240LN)#0%)$$"%
- D-.,$0"0&A#0"%%240L["/02#9"#&'"%&("%/4."%/"9"%?0"&,2=&A@u&2#'&SAu&'"+&!"%#+
- A#0"%%240Lu2"$$"#&"/#*"$#&1)#l92%/"%;,%
- D"%/"$$"&D-.#/O+0"$$"#
- 80."%#"0
- A6&(%,1e126&;"#20*0&=>%&d)7#$),'&'"+&N)'"+
- YD:
- }
- d"0,/$+Z&V,#';2-.&'"+&BFGH@CGIJJ&

Prof. Dr. Matthias Werner | Praktikum Betriebssysteme WS 2009/2010
2-

## Spezialfall Display

- 8/#*/9"&"X0"%#&./#*29"=>90"&B2+9,;""/#."/0&'"%&3/"$4$,5)%6

### - A+0&,#&(Ag&2#'&D4"/-."%;2+&,#9"+-.$)++"#

▶(AgZ&D0"2"%2#9&E["+"WD-.%"/;LY6+-.,$02#9\&D/9#,$/+/"%2#9\&N./4LD"$"-0\& }K
▶D4"/-."%;2+Z&d,0"#0%,#+="% <A+0&,#&ND^&EJXTJJJJJJJLJXTSSSSSSSK&,#9"+-.$)++"# <:"#pe90&#2%&"/#"&B'%"++"
<`%,4LB%)2#'Z&h"'"&B'%"++"&,2+&JXTJJJJJJJLJXTSSSSSSS&1,##&9"#20*0& 7"%'"#

### - B#+0"2"%2#9&62++&'/"&9""/9#"0"&D"o2"#*&,2+&D0"2"%+/9#,$"#&2#'&

9"+"#'"0"#&d,0"#7p%0"%#&"%*"29"#
▶D4?0"%"&B2=9,;"

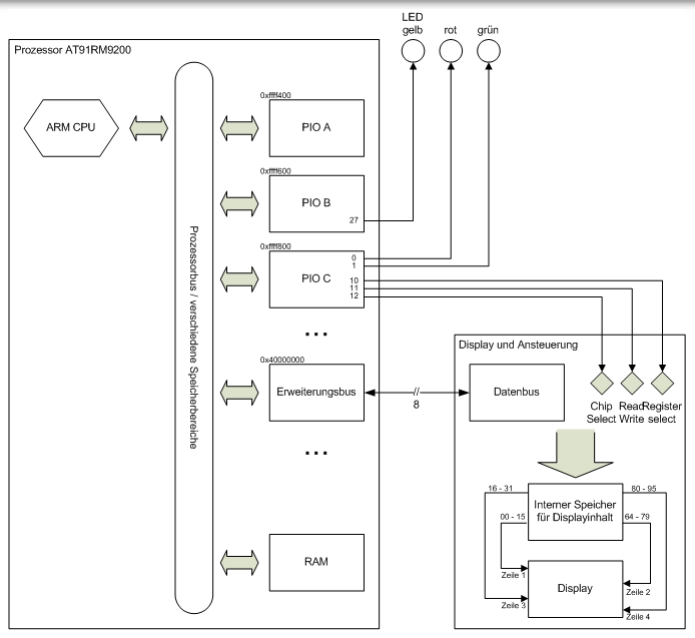
[picture p31: figure]

57 | Prof. Dr. Matthias Werner | Praktikum Betriebssysteme WS 2009/2010
2-

Spezialfall Display: Anbindung

58

ARM-Architektur

## Programmierung

- biYLF))$+&=>%&>;$/-."&(%)9%,66/"%+4%,-."# ▶N88$2*/$#-"//8"DJ6*%-$3:-$>7? ▶8-"//R;6&14*/$3:-$M6&0%&
▶8-"//R2/$2*/$>//%D;*6%-%-$3:-$>7?
- A6&(%,1e126
▶#$3:-$2**%/U$O2/$6&$#$D28(;2-$6/' ▶>//%D;*%-$3:-$D2/8(6&%&&2(%$lJ%-24"&%&$P.X@X$@%(2&+*1&N$A"&$>1/&2(D%&S ▶V2&.$"(&%$>//%D;*%-$A675G=7,+.4)+@)7,234r
- V"%,2+=)%'"%2#9
▶Z"D;6&24"&$A"&$>//%D;*%-R$1&+$#RC%6*%&
▶!6&&A"**%$>13N2;%&'%6*1&N
▶5DJ3%(*1&N=$?aN*68(/'$A6%*$6&$#r
59 | Prof. Dr. Matthias Werner | Praktikum Betriebssysteme WS 2009/2010

ARM-Architektur

## Kombination von C und Assembler

- [&*6&%R>//%D;*%-
- 8/#*"$#"&A#+0%21e)#"#&'/%"10&/#&NLN)'"&"/#;"O"#
- :"/+4/"$&C)'2+7"-.+"$Z
printf(“Wechsle Modus...\n”); asm("MRS r1,cpsr");
asm("BIC r1,r1, #0x80");
asm("MSR cpsr_c,r1");
printf(“Modus gewechselt!\n”);
- <=.@,234()
:"#20*2#9&M)#&@"9/+0"%#&.,0&8/#{2++&,2=&NL(%)9%,66z
- >//%D;*%-Rl;h%0'Rb6*%/$D6'$#Rl;h%0'Rb6*%/$*6&0%&
- F%"##2#9&'"+&N)'"+
- 32+,66"#+4/"$&>;"%&8/#+4%2#9,'%"++"#&2#'&(,%,6"0"%>;"%9,;"&E#?-.+0"&S)$/"K
- [/#1"#

Prof. Dr. Matthias Werner | Praktikum Betriebssysteme WS 2009/2010
2-

## Übergabe von Parametern

- r;$/-."%&`"9Z&
- (,%,6"0"%&"/#"%&S2#1e)#&7"%'"#&,2=&'"#&D0,-1&9"$"90
- B2=9"%2="#"&S2#1e)#&$/"+0&+/"
- ["90&,6&8#'"&',+&8%9";#/+&,2=&D0,-1
- B2=%2="%&$/"+0&"+
- B@C&#,-.&B@C&(%)-"'2%"&N,$$&D0,#',%'&EB(NDKZ
- 8%+0"&M/"%&AiFL(,%,6"0"%&7"%'"#&>;"%&@J&;/+&@^&>;"%9";"#
- RTL:/0L`"%0"&4,,%7"/+"&6/0&@JW@H&2#'&@IW@^
- @>-19,;"Z&@J&;*7]&@JW@H&;"/&RT&:/0
- r;%/9"&(,%,6"0"%Z&D0,-1
- B@CLbNNZ
- S)$90&B(ND\&$"90&'/"&(,%,6"0"%&',##&,;"%&,2=&'"#&D0,-1
- <=.@,234(
- r;"%9,;"&>;"%&@"9/+0"%&/+0&#/-.0&7/"'"%"/#0%/O+=?./9\&@"O"#&'"%&(,%,6"0"%&,2=&9""/9#"0"&
`"/+"&E*]:]&D0,-1K
- :"#20*2#9&M)#&@"9/+0"%#&.,0&7/"'"%&8/#{2++&,2=&NL(%)9%,66z
61 | Prof. Dr. Matthias Werner | Praktikum Betriebssysteme WS 2009/2010
2-

## Übergabe von Parametern

- :"/+4/"$-)'"&[8dLB#+0"2"%2#9
- B++"6;$"%%)2e#"&/#/e,$/+/"%0&[8dL()%0 ▶,2-2D%'%-=$@2/6/2+-%//%$+%/$,[lR#"&'-"**%-/ ▶7:80N2;%=$H
▶@%&1'.1&N$+%/$!'280$.1-$7%W1&N$A%-O%&+%'%-$7%N6/'%-
- NL@)2e#"&%2c&B++"6;$"%%)2e#"&,2= ▶s;%-N6;'$@2/6/2+-%//%$3:-$#"&'-"**%-▶C%/'%'$7:80N2;%O%-'

62

ARM-Architektur

## Assemblerseite

led_init:
stmfd sp!, {r2} | ;save used registers
mov r2, #YELLOW_LED_REGISTER ;set r1 with yellow
str r2, [r0] | ;enable I/O for yellow
| ;led

add r0, #PIOB_OER_OFFSET
str r2, [r0] | ;enable output for ;yellow led
ldmfd sp!, {r2} | ;restore used registers
mov r0, #1 | ;set return value TRUE
mov pc, lr | ;return
63 | Prof. Dr. Matthias Werner | Praktikum Betriebssysteme WS 2009/2010

ARM-Architektur

## C-Seite

if(led_init((PIOB_REGISTER_ADDRESS)PIOB_BASE)==1) {
// do something
}

Prof. Dr. Matthias Werner | Praktikum Betriebssysteme WS 2009/2010
2-

## Literatur

- :>-."%
▶>7?$!\/'%D$>-8(6'%8'1-%$t$!'%A%$b1-;%-▶>7?$!\/'%D$9%A%*"J%-u/$V16+%$^$>&+-%O$!*"//U$9"D6&68$!\D%/U$#(-6/$`-6N('
- g#$/#"Lu2"$$"#&E+/"."&[/#1+&,2=&`";+"/0"K ▶>7?$>-8(6'%8'1-%$7%3%-%&8%$?2&12* ▶>7?$>//%D;*\$M2&N12N%$,-"N-2DD6&N
▶7%3%-%&.(2&+;18($.1D$>7?EFGC ▶7%3%-%&.(2&+;18($.1D$>CEH7?EFGG
65 | Prof. Dr. Matthias Werner | Praktikum Betriebssysteme WS 2009/2010
2-

## Wie geht es weiter?

## ▶B#+-.$/"s"#'Z&8/#=>.%2#9&())$&~&a)%=>.%2#9&F))$LN.,/#& ▶i?-.+0"&`)-."Z&:"+4%"-.2#9&B2=9,;"&H

▶:/+&',./#Z
▶h"'"%&;,20&:"/+4/"$-)'"&#,-.&2#'&=>.%0&/.#&,2+

66
