davidReward/dokustudienarbeit/V2Doku/bilder/arduinoIDE.png

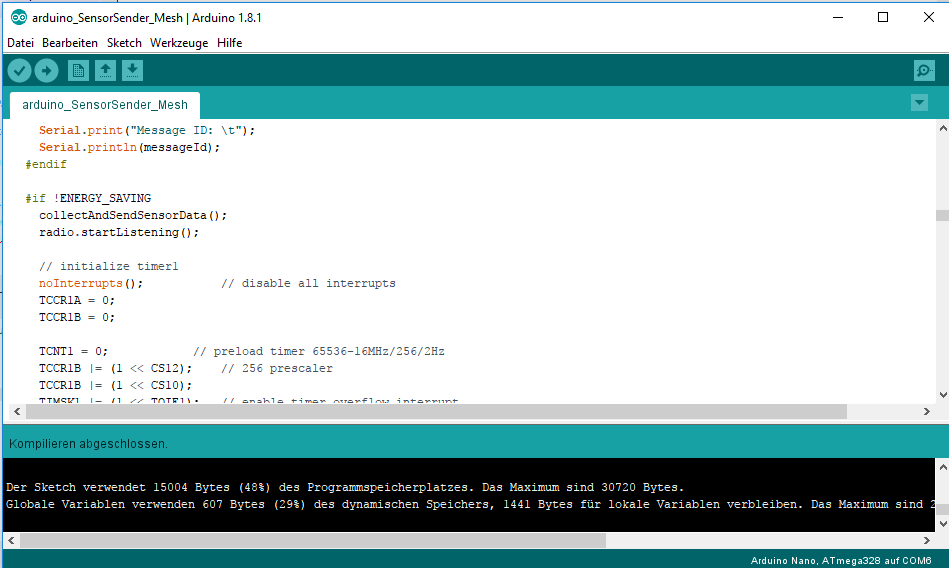
V2Doku/bilder/arduinoIDE.png
