davidReward/dokustudienarbeit/V2Doku/bilder/i2c_0.png

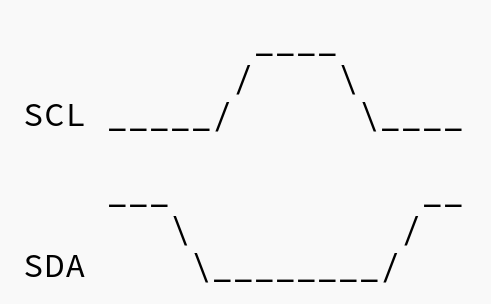
V2Doku/bilder/i2c_0.png
