davidReward/dokustudienarbeit/V2Doku/bilder/i2c_1.png

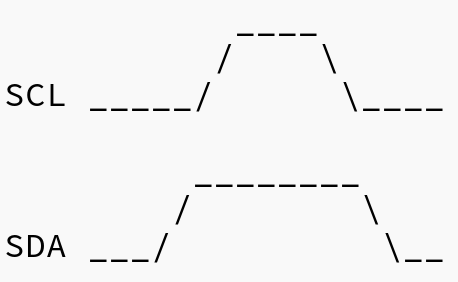
V2Doku/bilder/i2c_1.png
