davidReward/dokustudienarbeit/V2Doku/bilder/i2c_ack.png

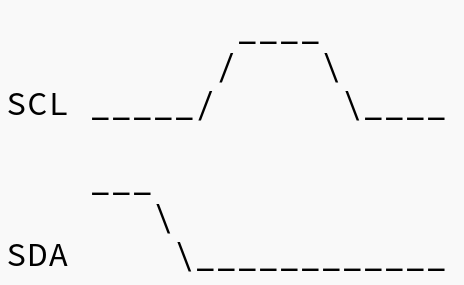
V2Doku/bilder/i2c_ack.png
