davidReward/dokustudienarbeit/V2Doku/bilder/i2c_frei.png

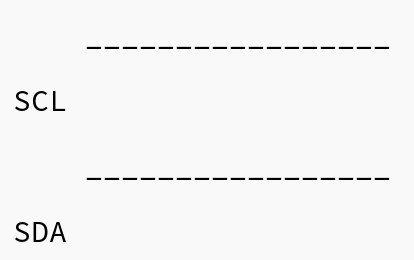
V2Doku/bilder/i2c_frei.png
