davidReward/dokustudienarbeit/V2Doku/bilder/i2C_noAck.png

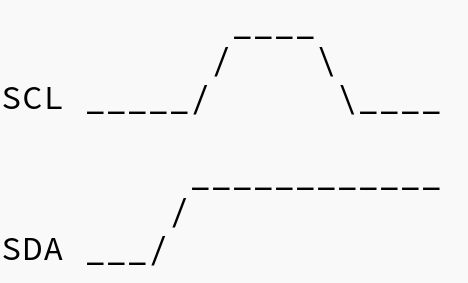
V2Doku/bilder/i2C_noAck.png
