davidReward/dokustudienarbeit/V2Doku/bilder/i2c_start.png

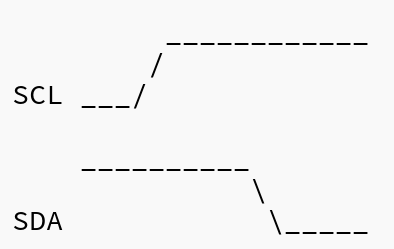
V2Doku/bilder/i2c_start.png
