davidReward/dokustudienarbeit/V2Doku/bilder/i2c_stopp.png

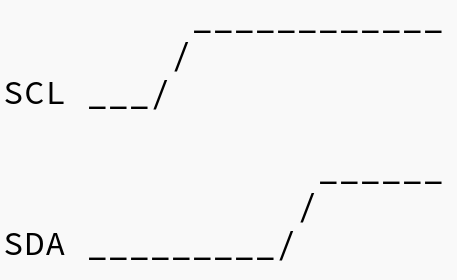
V2Doku/bilder/i2c_stopp.png
