davidReward/dokustudienarbeit/V2Doku/bilder/IMG_1876.JPG

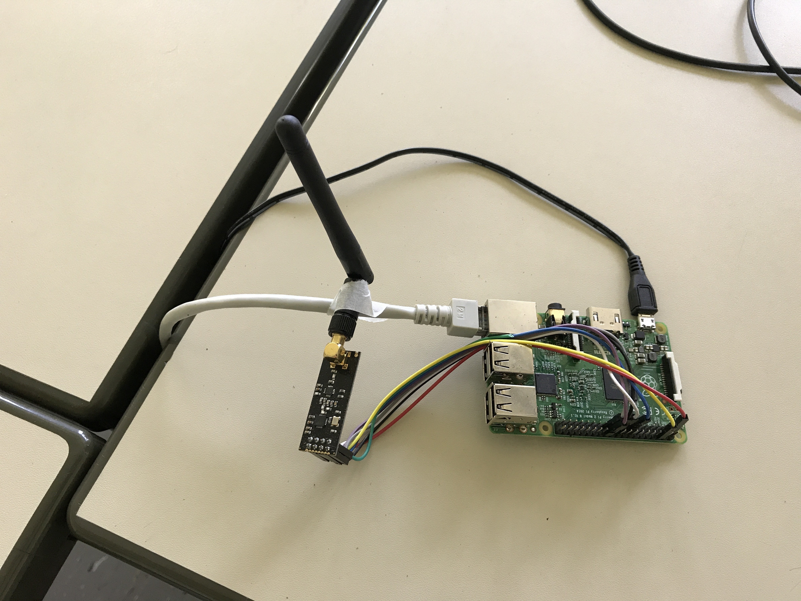
V2Doku/bilder/IMG_1876.JPG
