davidReward/dokustudienarbeit/V2Doku/bilder/IMG_1877.JPG

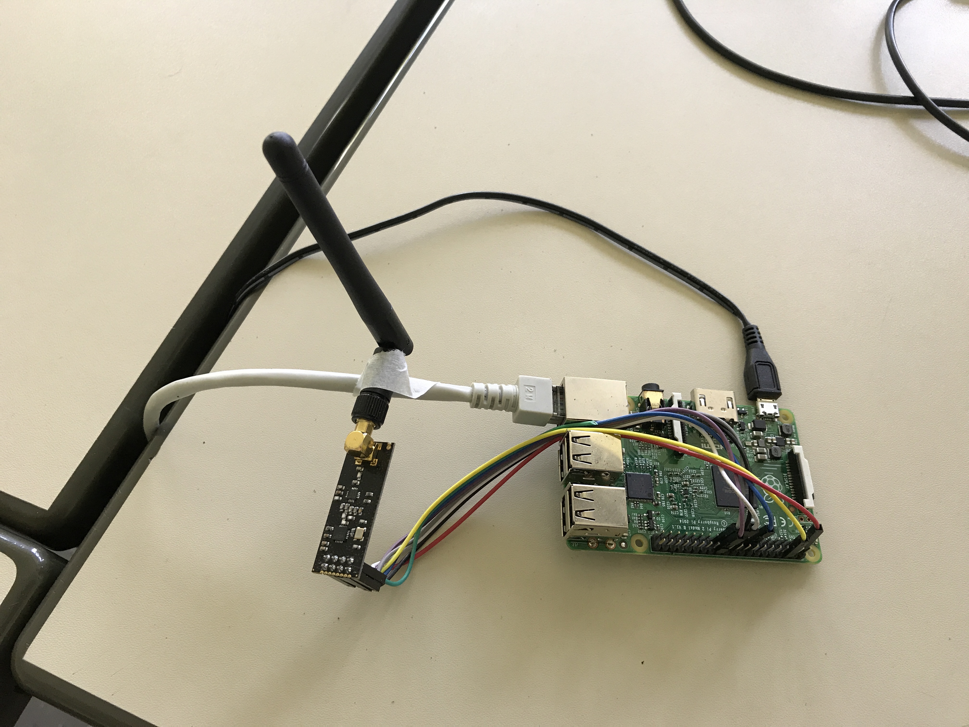
V2Doku/bilder/IMG_1877.JPG
