davidReward/dokustudienarbeit/V2Doku/bilder/IMG_1880.JPG

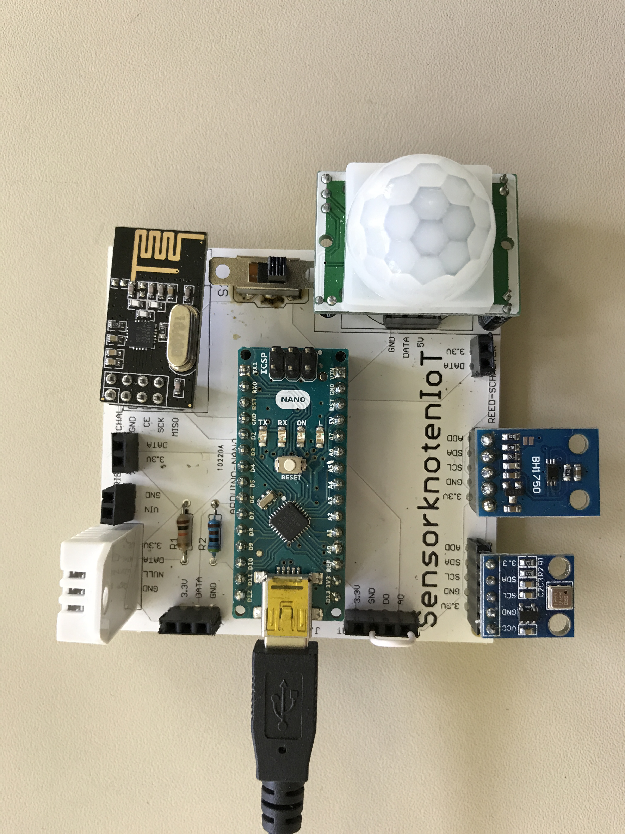
V2Doku/bilder/IMG_1880.JPG
