davidReward/dokustudienarbeit/V2Doku/bilder/IMG_1882.JPG

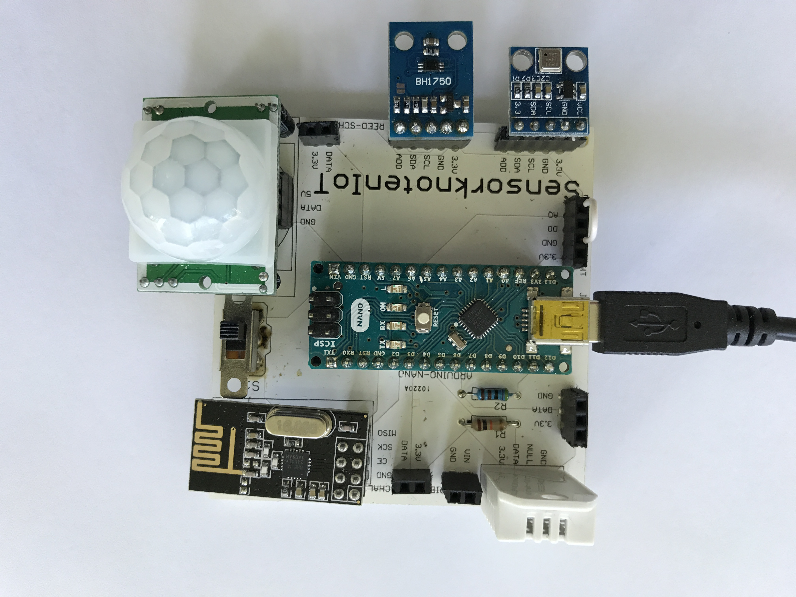
V2Doku/bilder/IMG_1882.JPG
