davidReward/dokustudienarbeit/V2Doku/bilder/IMG_1883.JPG

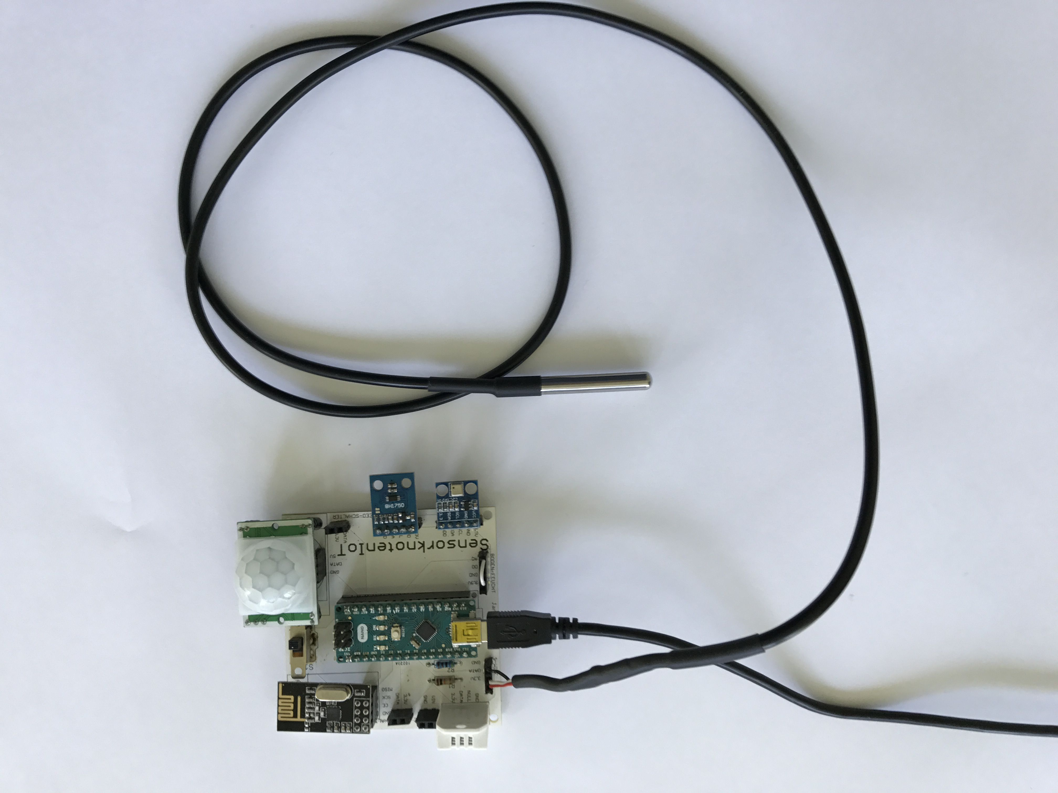
V2Doku/bilder/IMG_1883.JPG
