davidReward/dokustudienarbeit/V2Doku/bilder/IMG_1885.JPG

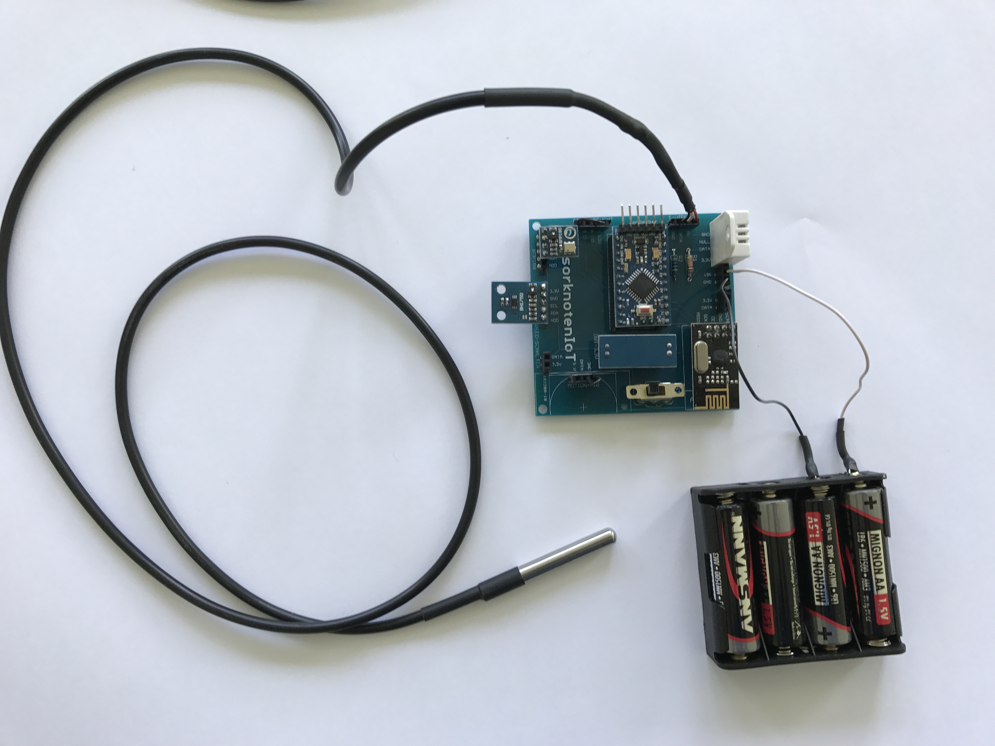
V2Doku/bilder/IMG_1885.JPG
