davidReward/dokustudienarbeit/V2Doku/bilder/IMG_1889.JPG

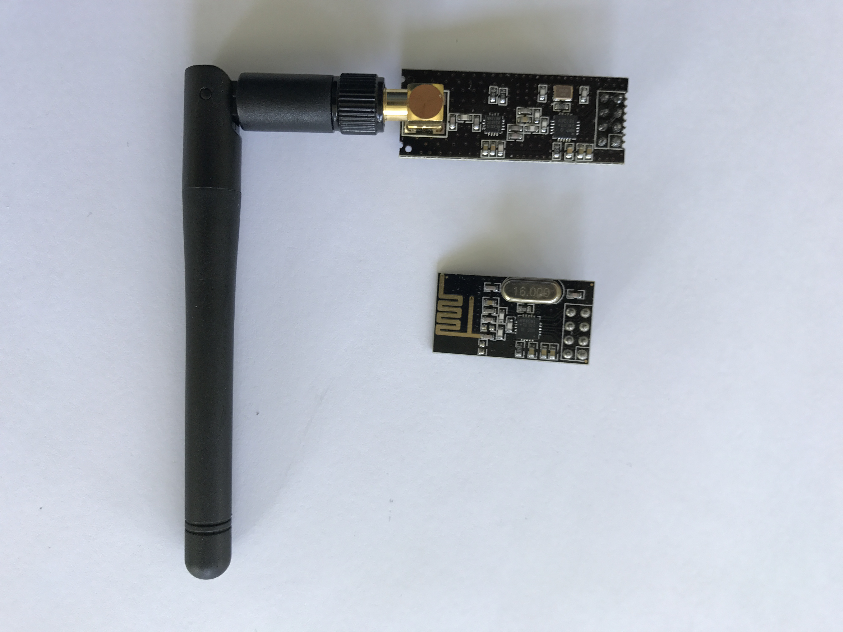
V2Doku/bilder/IMG_1889.JPG
