davidReward/dokustudienarbeit/V2Doku/bilder/IMG_1890.JPG

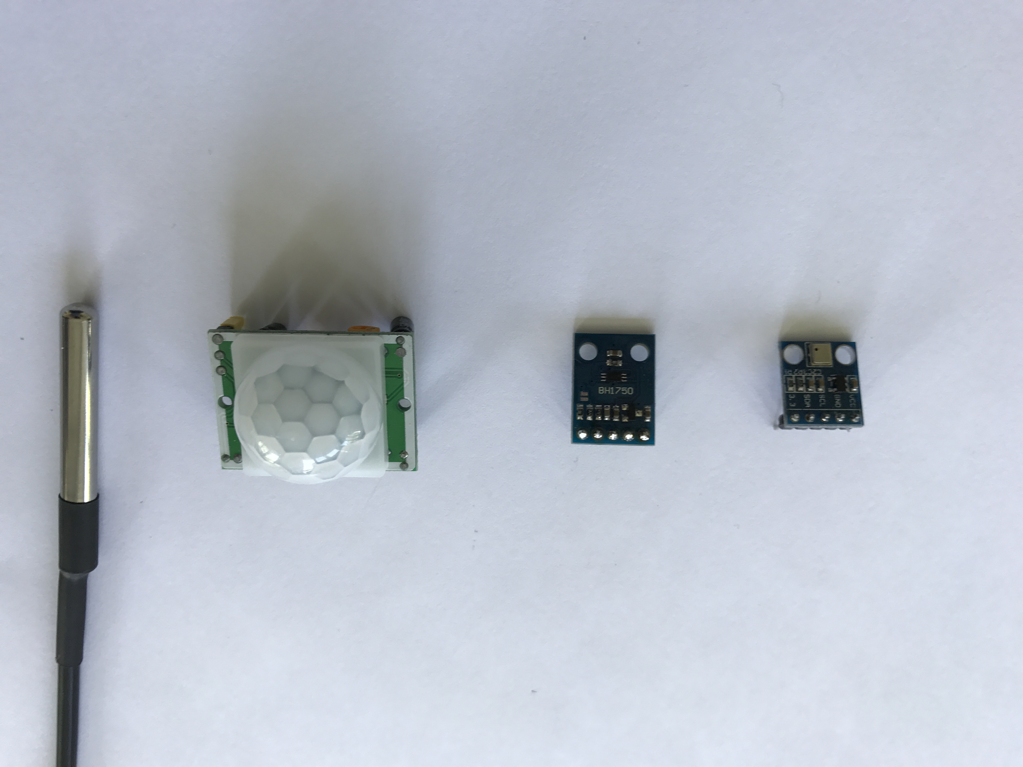
V2Doku/bilder/IMG_1890.JPG
