davidReward/dokustudienarbeit/V2Doku/bilder/IMG_1891.JPG

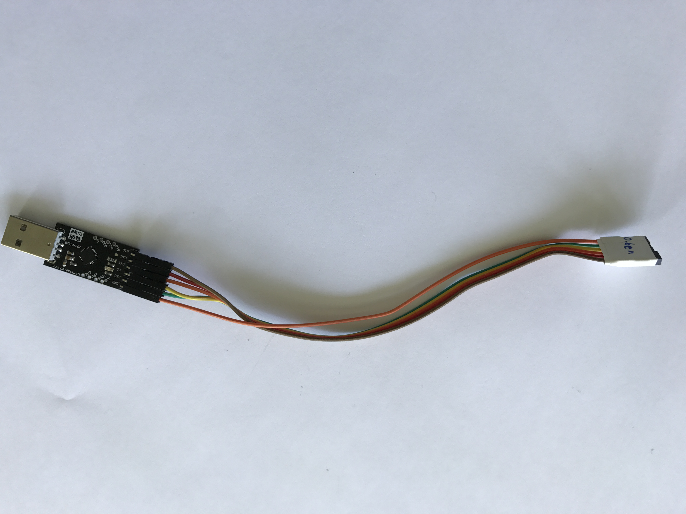
V2Doku/bilder/IMG_1891.JPG
