davidReward/dokustudienarbeit/V2Doku/bilder/IMG_1898.JPG

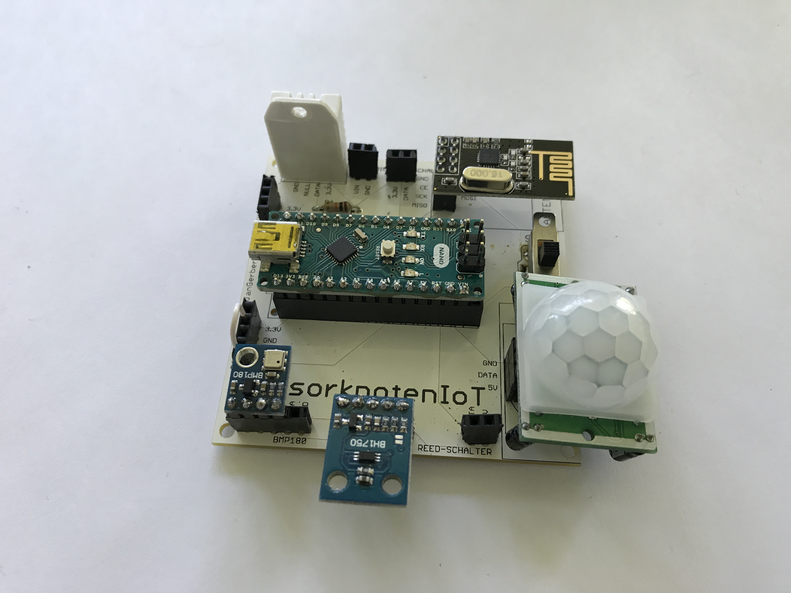
V2Doku/bilder/IMG_1898.JPG
