davidReward/dokustudienarbeit/V2Doku/bilder/IMG_1899.JPG

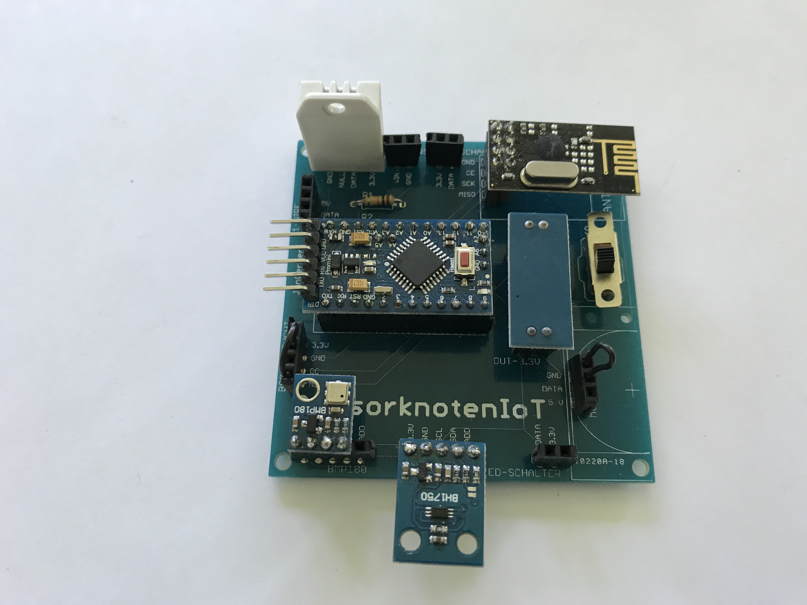
V2Doku/bilder/IMG_1899.JPG
