davidReward/dokustudienarbeit/V2Doku/bilder/IMG_1900.JPG

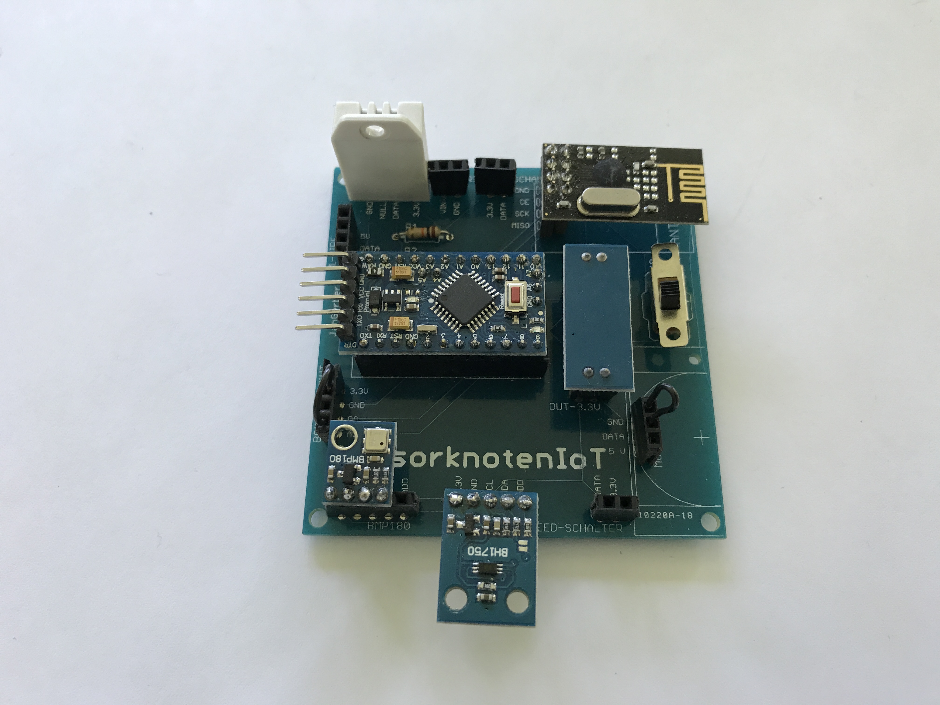
V2Doku/bilder/IMG_1900.JPG
