davidReward/dokustudienarbeit/V2Doku/bilder/IMG_1902.JPG

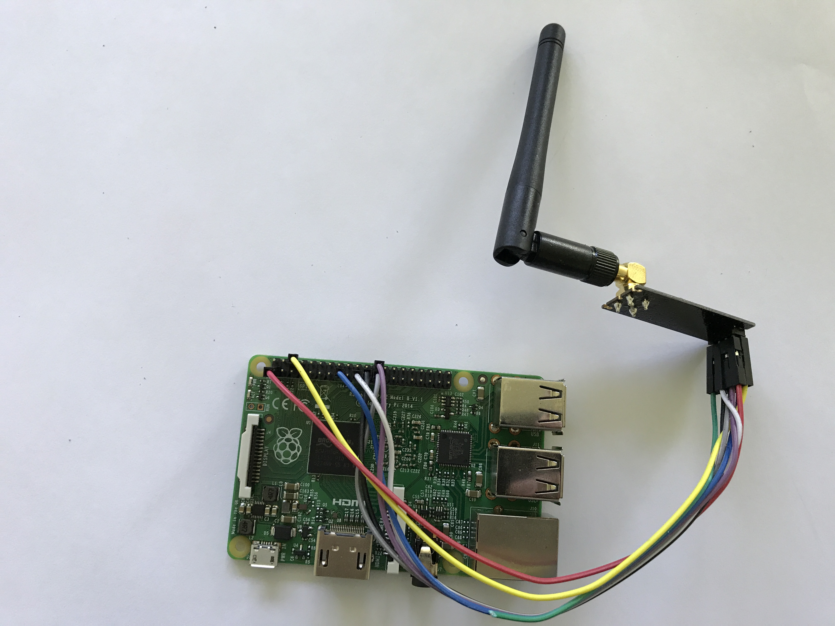
V2Doku/bilder/IMG_1902.JPG
