davidReward/dokustudienarbeit/V2Doku/bilder/IMG_1941.JPG

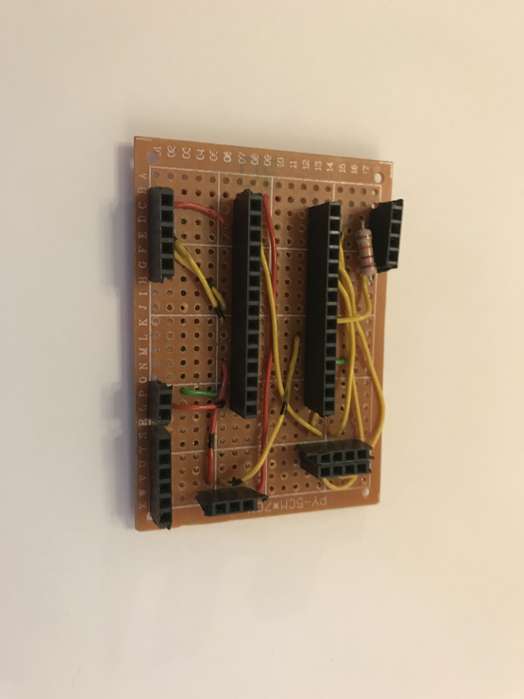
V2Doku/bilder/IMG_1941.JPG
