davidReward/dokustudienarbeit/V2Doku/bilder/IMG_1949.JPG

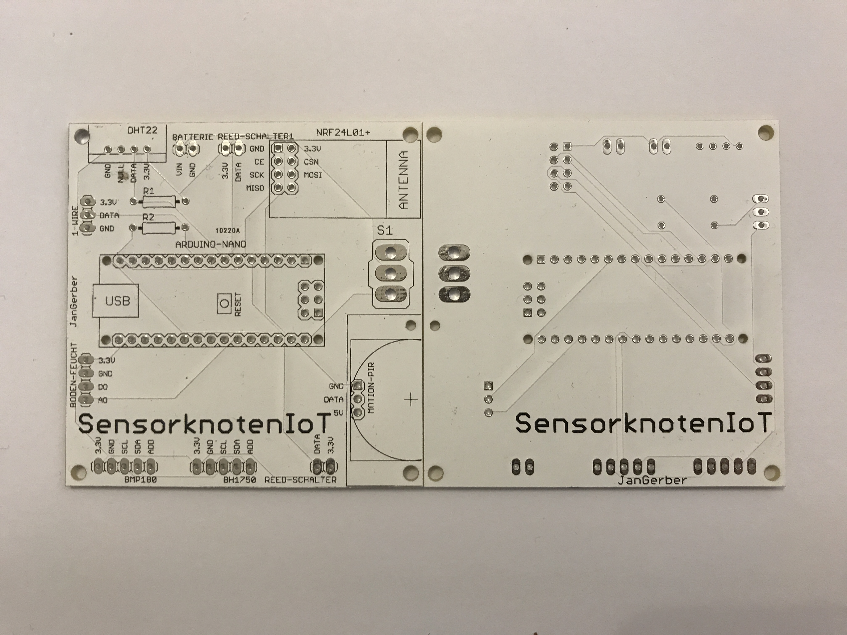
V2Doku/bilder/IMG_1949.JPG
