davidReward/dokustudienarbeit/V2Doku/bilder/ipv4cisco.png

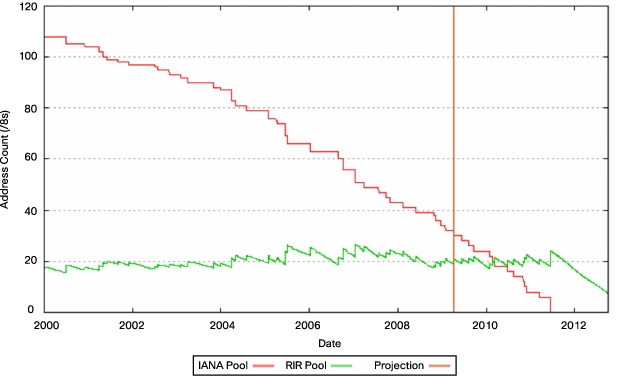
V2Doku/bilder/ipv4cisco.png
