davidReward/dokustudienarbeit/V2Doku/bilder/mini.JPG

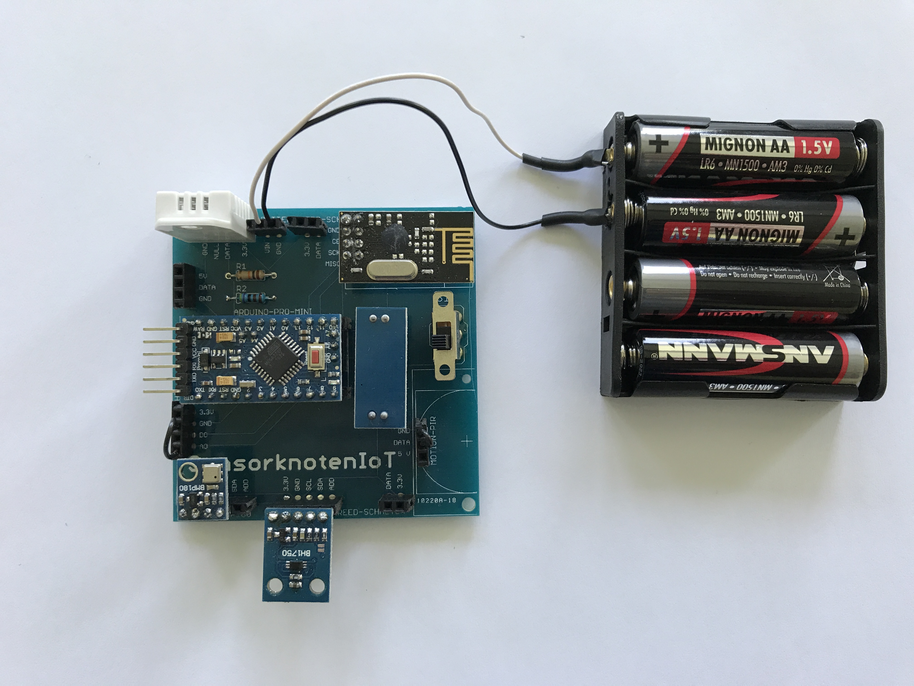
V2Doku/bilder/mini.JPG
