davidReward/dokustudienarbeit/V2Doku/bilder/mmu.png

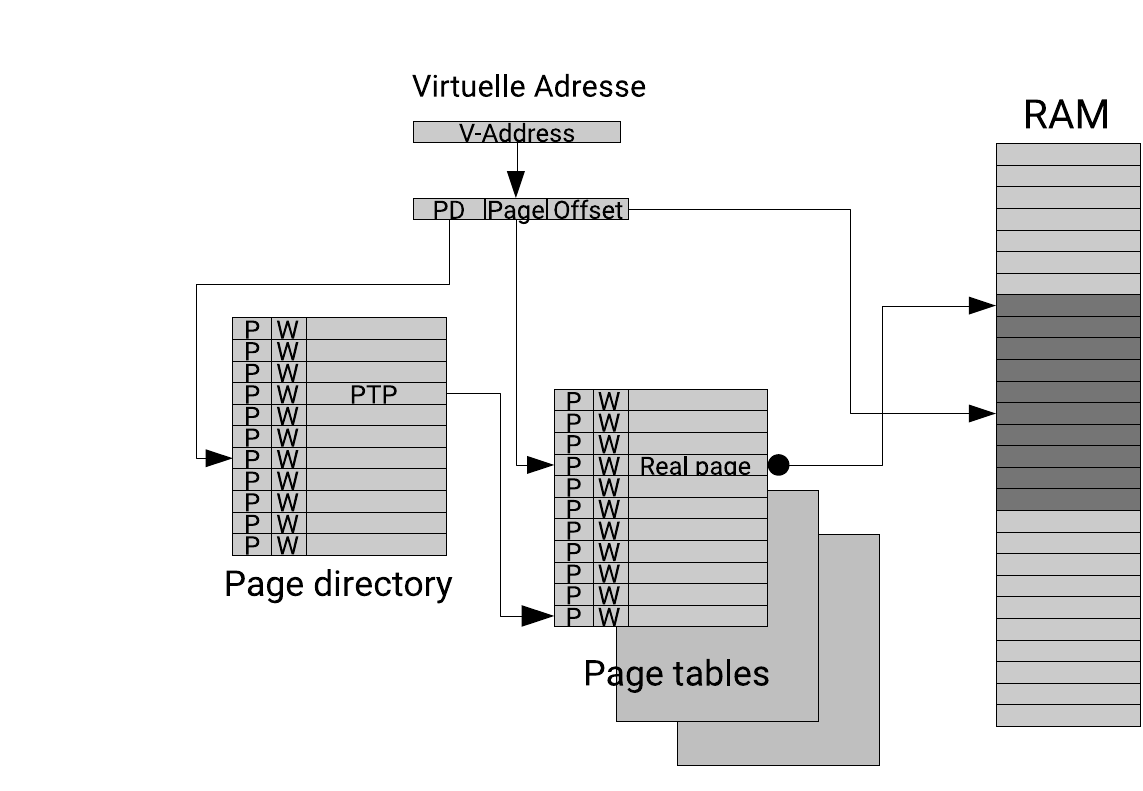
V2Doku/bilder/mmu.png
