davidReward/dokustudienarbeit/V2Doku/bilder/nano.JPG

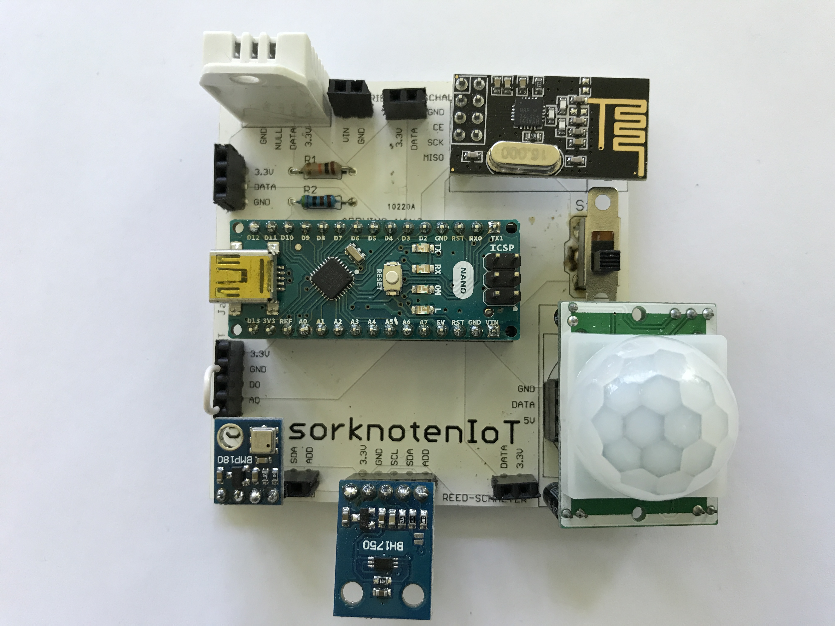
V2Doku/bilder/nano.JPG
