davidReward/dokustudienarbeit/V2Doku/bilder/overviewRegister.png

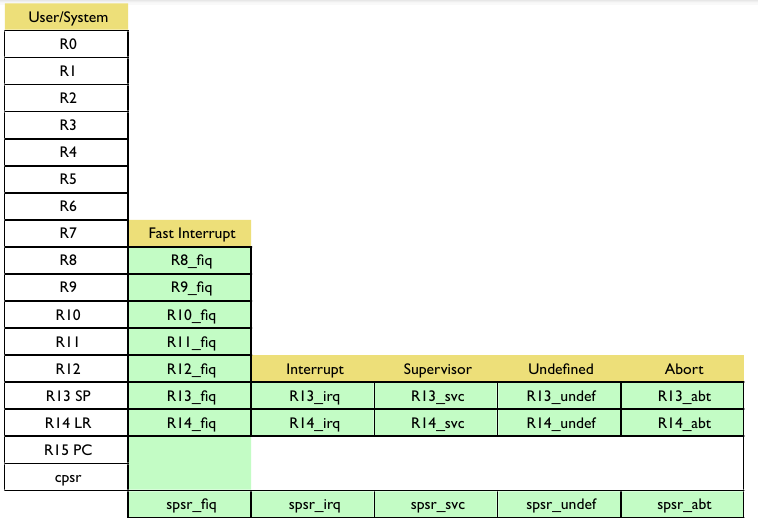
V2Doku/bilder/overviewRegister.png
