davidReward/dokustudienarbeit/V2Doku/bilder/pycharm.png

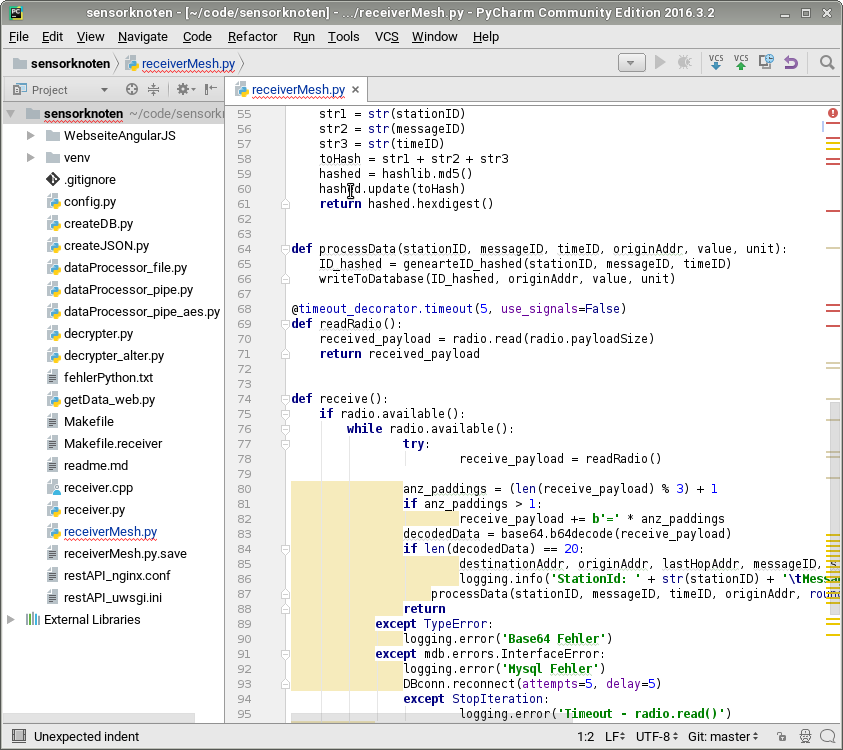
V2Doku/bilder/pycharm.png
