davidReward/dokustudienarbeit/V2Doku/bilder/raspi.JPG

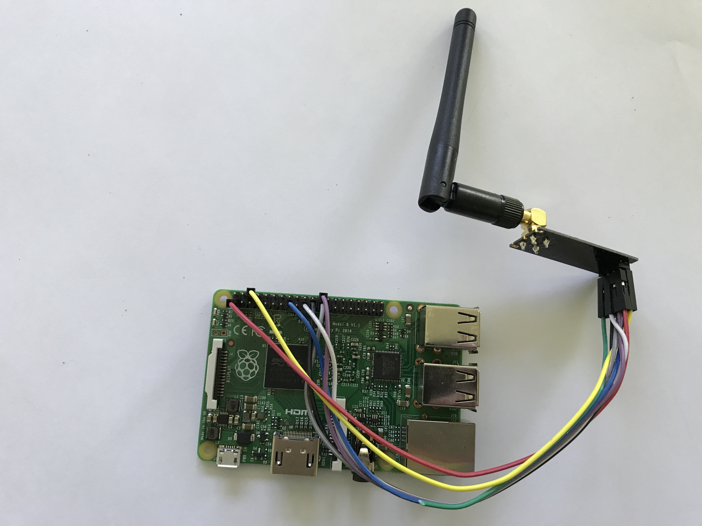
V2Doku/bilder/raspi.JPG
