davidReward/dokustudienarbeit/V2Doku/bilder/regelung.png

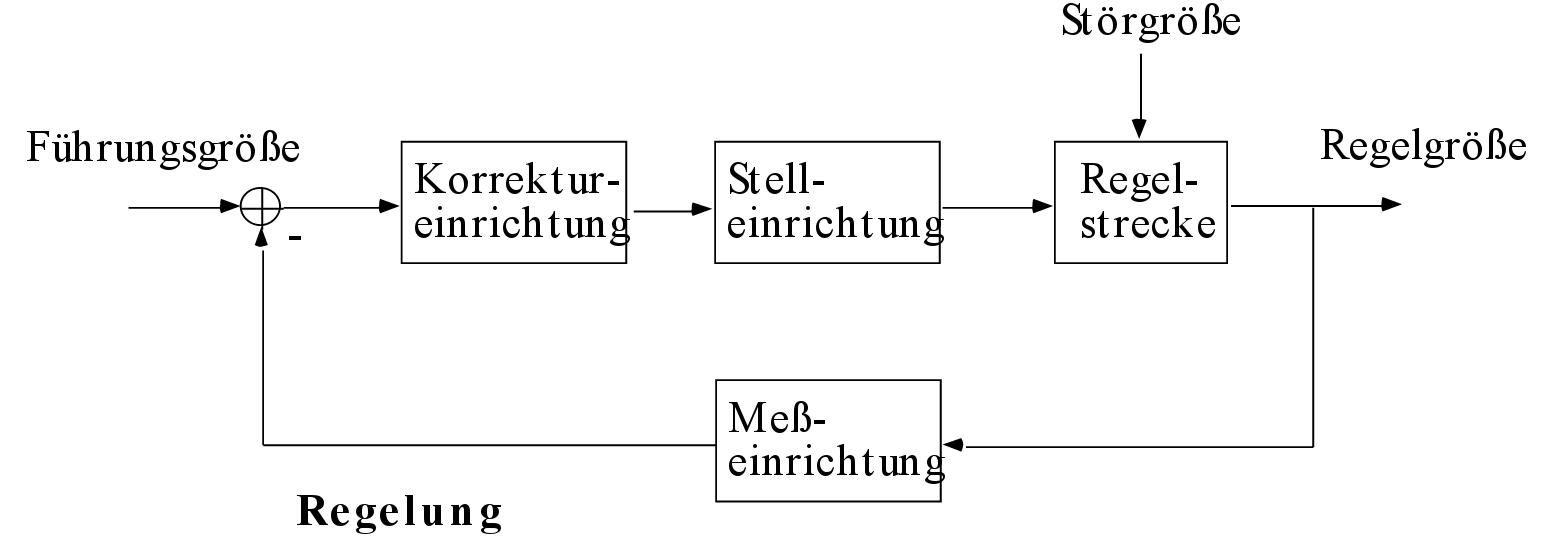
V2Doku/bilder/regelung.png
