davidReward/dokustudienarbeit/V2Doku/bilder/rf24_pins1.jpg

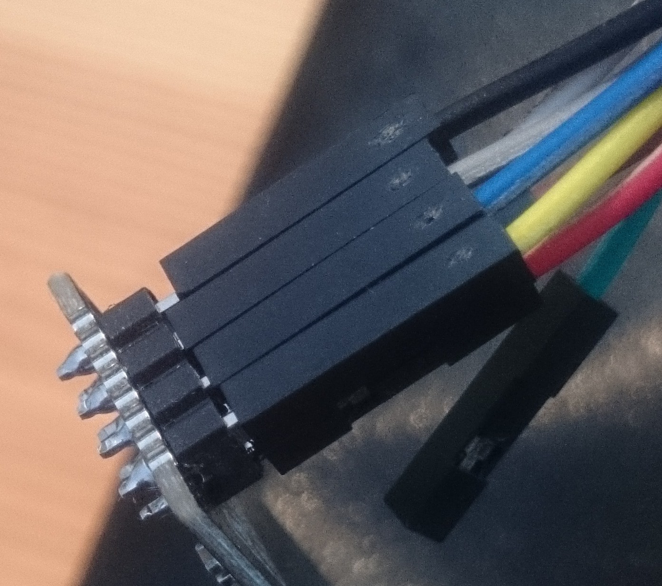
V2Doku/bilder/rf24_pins1.jpg
