davidReward/dokustudienarbeit/V2Doku/bilder/rf24_pins2.JPG

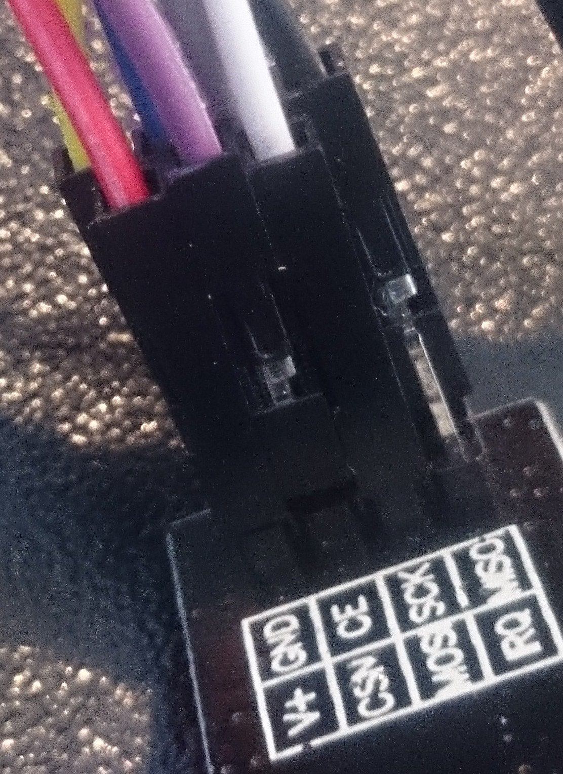
V2Doku/bilder/rf24_pins2.JPG
