davidReward/dokustudienarbeit/V2Doku/bilder/serverSchema.png

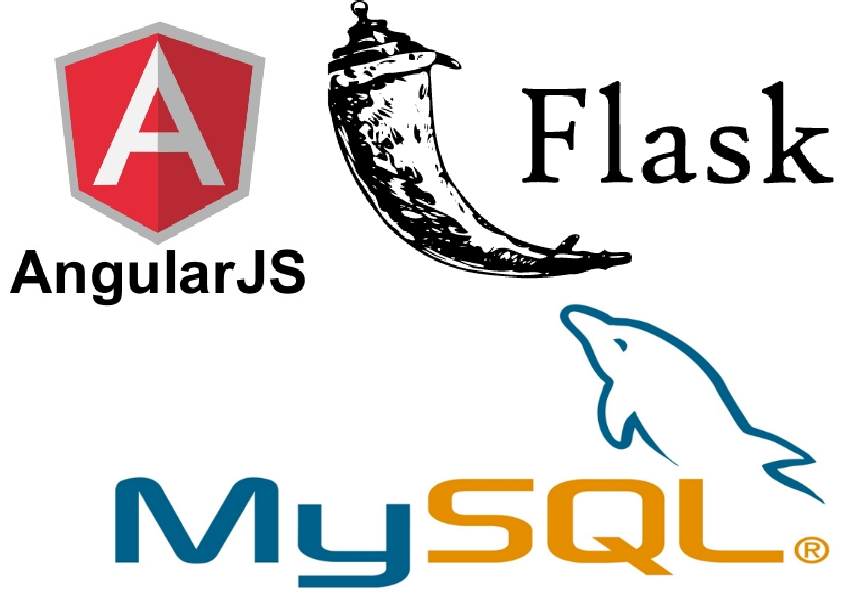
V2Doku/bilder/serverSchema.png
