davidReward/dokustudienarbeit/V2Doku/bilder/spi.png

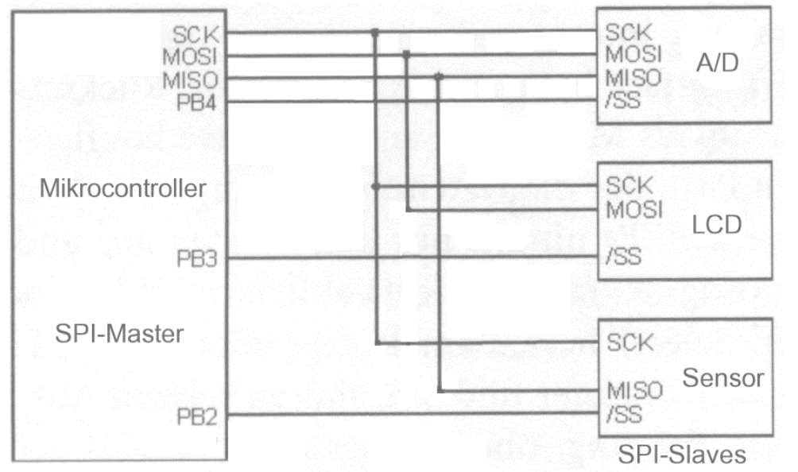
V2Doku/bilder/spi.png
