davidReward/dokustudienarbeit/V2Doku/bilder/steuerung.png

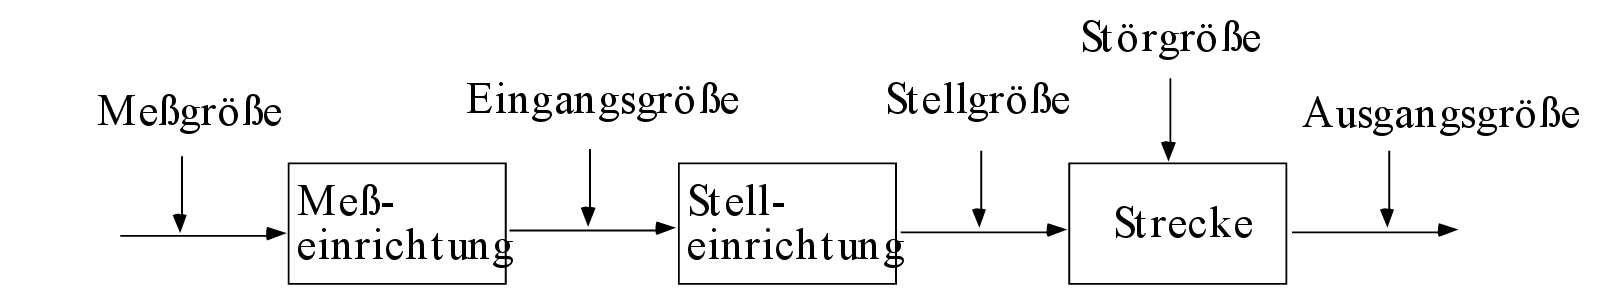
V2Doku/bilder/steuerung.png
