davidReward/dokustudienarbeit/V2Doku/bilder/verkabelung_raspi.JPG

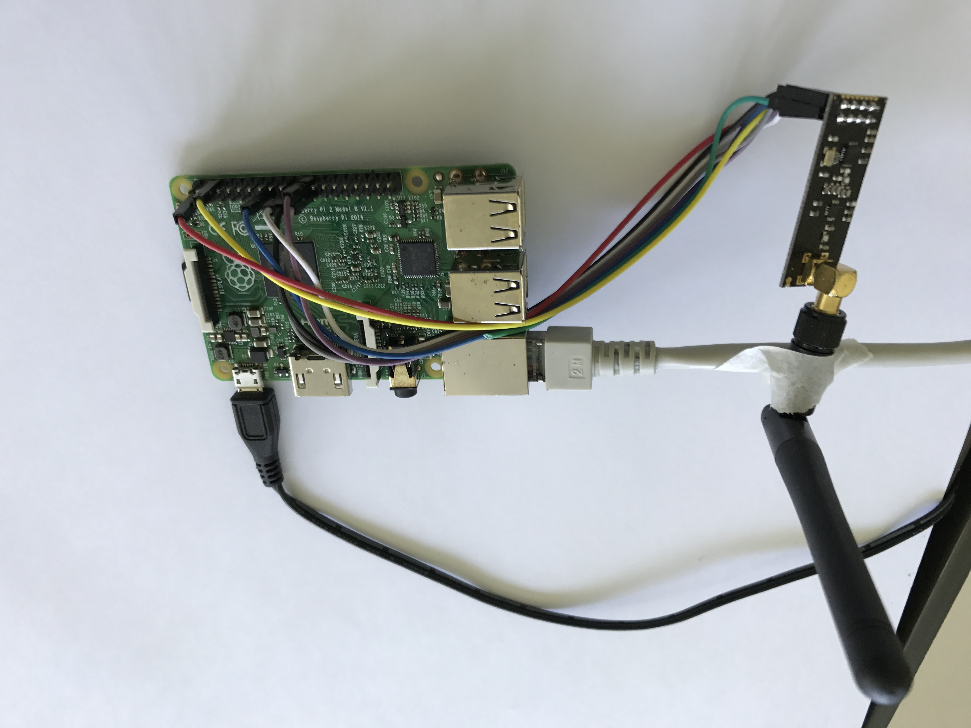
V2Doku/bilder/verkabelung_raspi.JPG
