davidReward/dokustudienarbeit/V2Doku/bilder/verkabelung_raspi_2.JPG

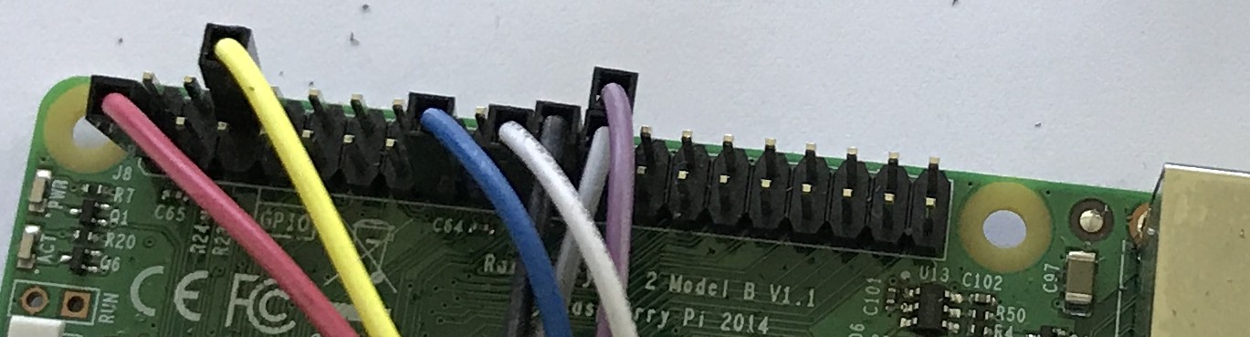
V2Doku/bilder/verkabelung_raspi_2.JPG
