davidReward/dokustudienarbeit/V2Doku/pics/edekaneu.png

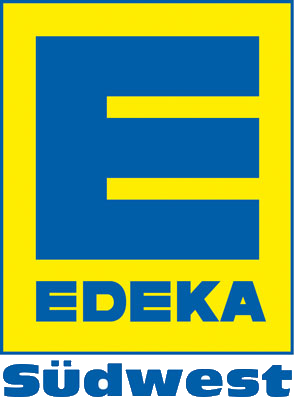
V2Doku/pics/edekaneu.png
