davidReward/dokustudienarbeit/V2Doku/pics/reinforcementLearning.png

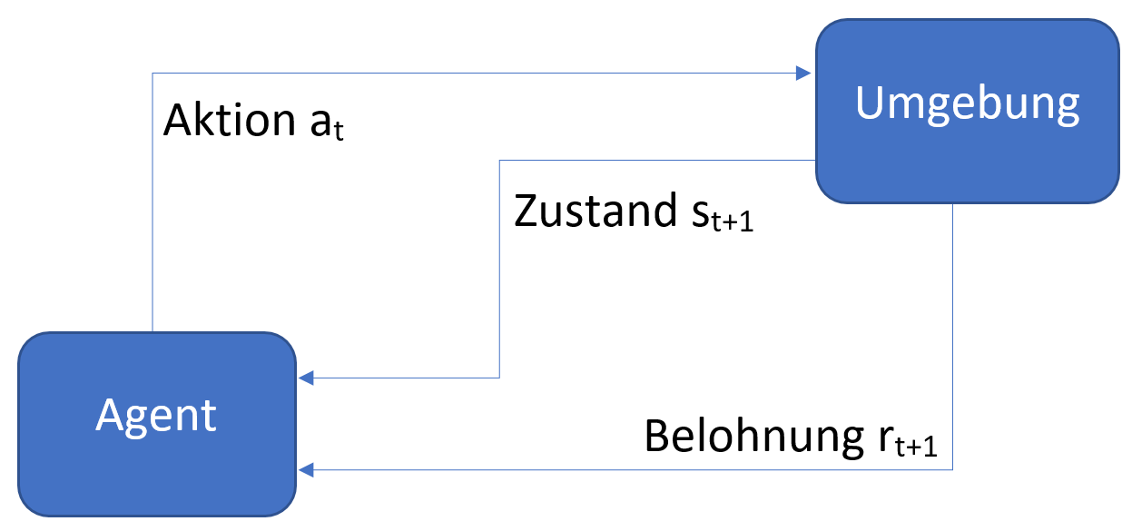
V2Doku/pics/reinforcementLearning.png
