davidReward/dokustudienarbeit/V2Doku/bilder/aufbauMikrocontroller.png

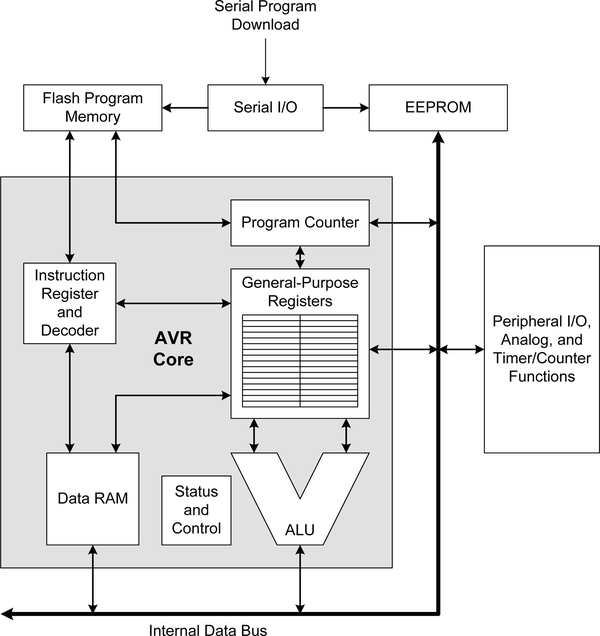
V2Doku/bilder/aufbauMikrocontroller.png
