davidReward/dokustudienarbeit/V2Doku/bilder/AvrMicrocontrollerAufbau.png

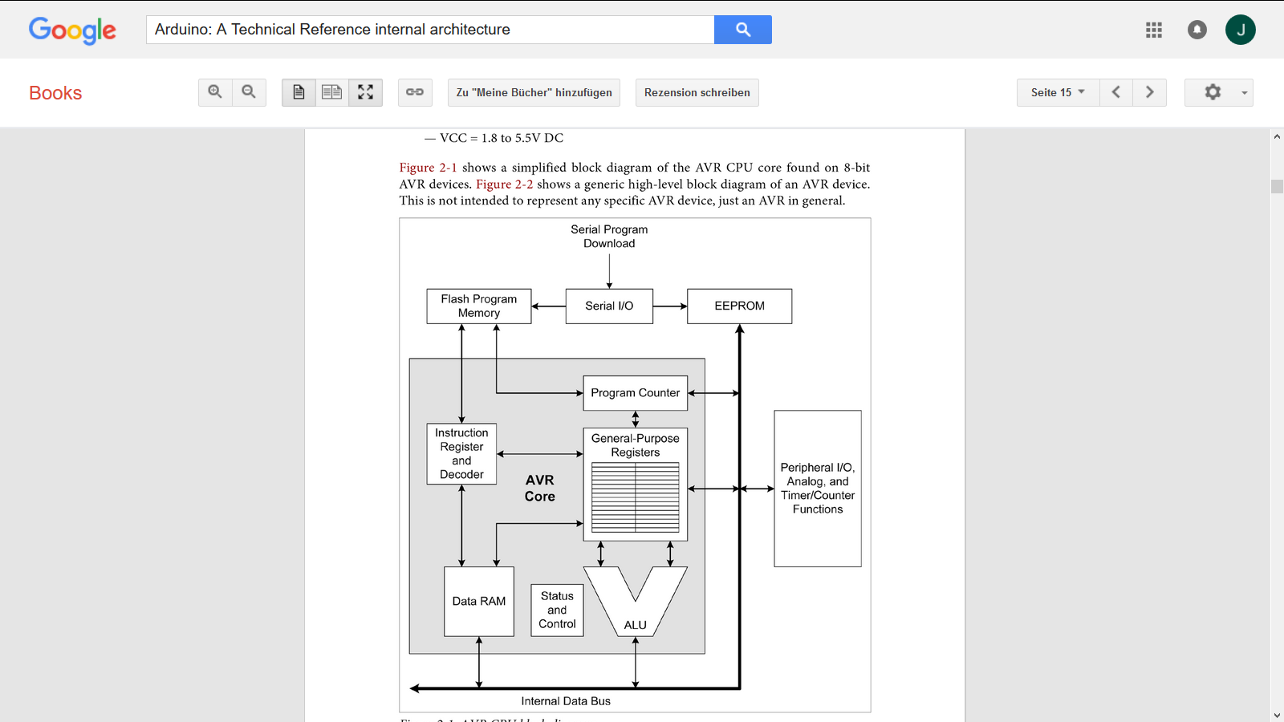
V2Doku/bilder/AvrMicrocontrollerAufbau.png
