davidReward/dokustudienarbeit/V2Doku/bilder/ArduinoProMiniUeberarbeitet-rotated.pdf

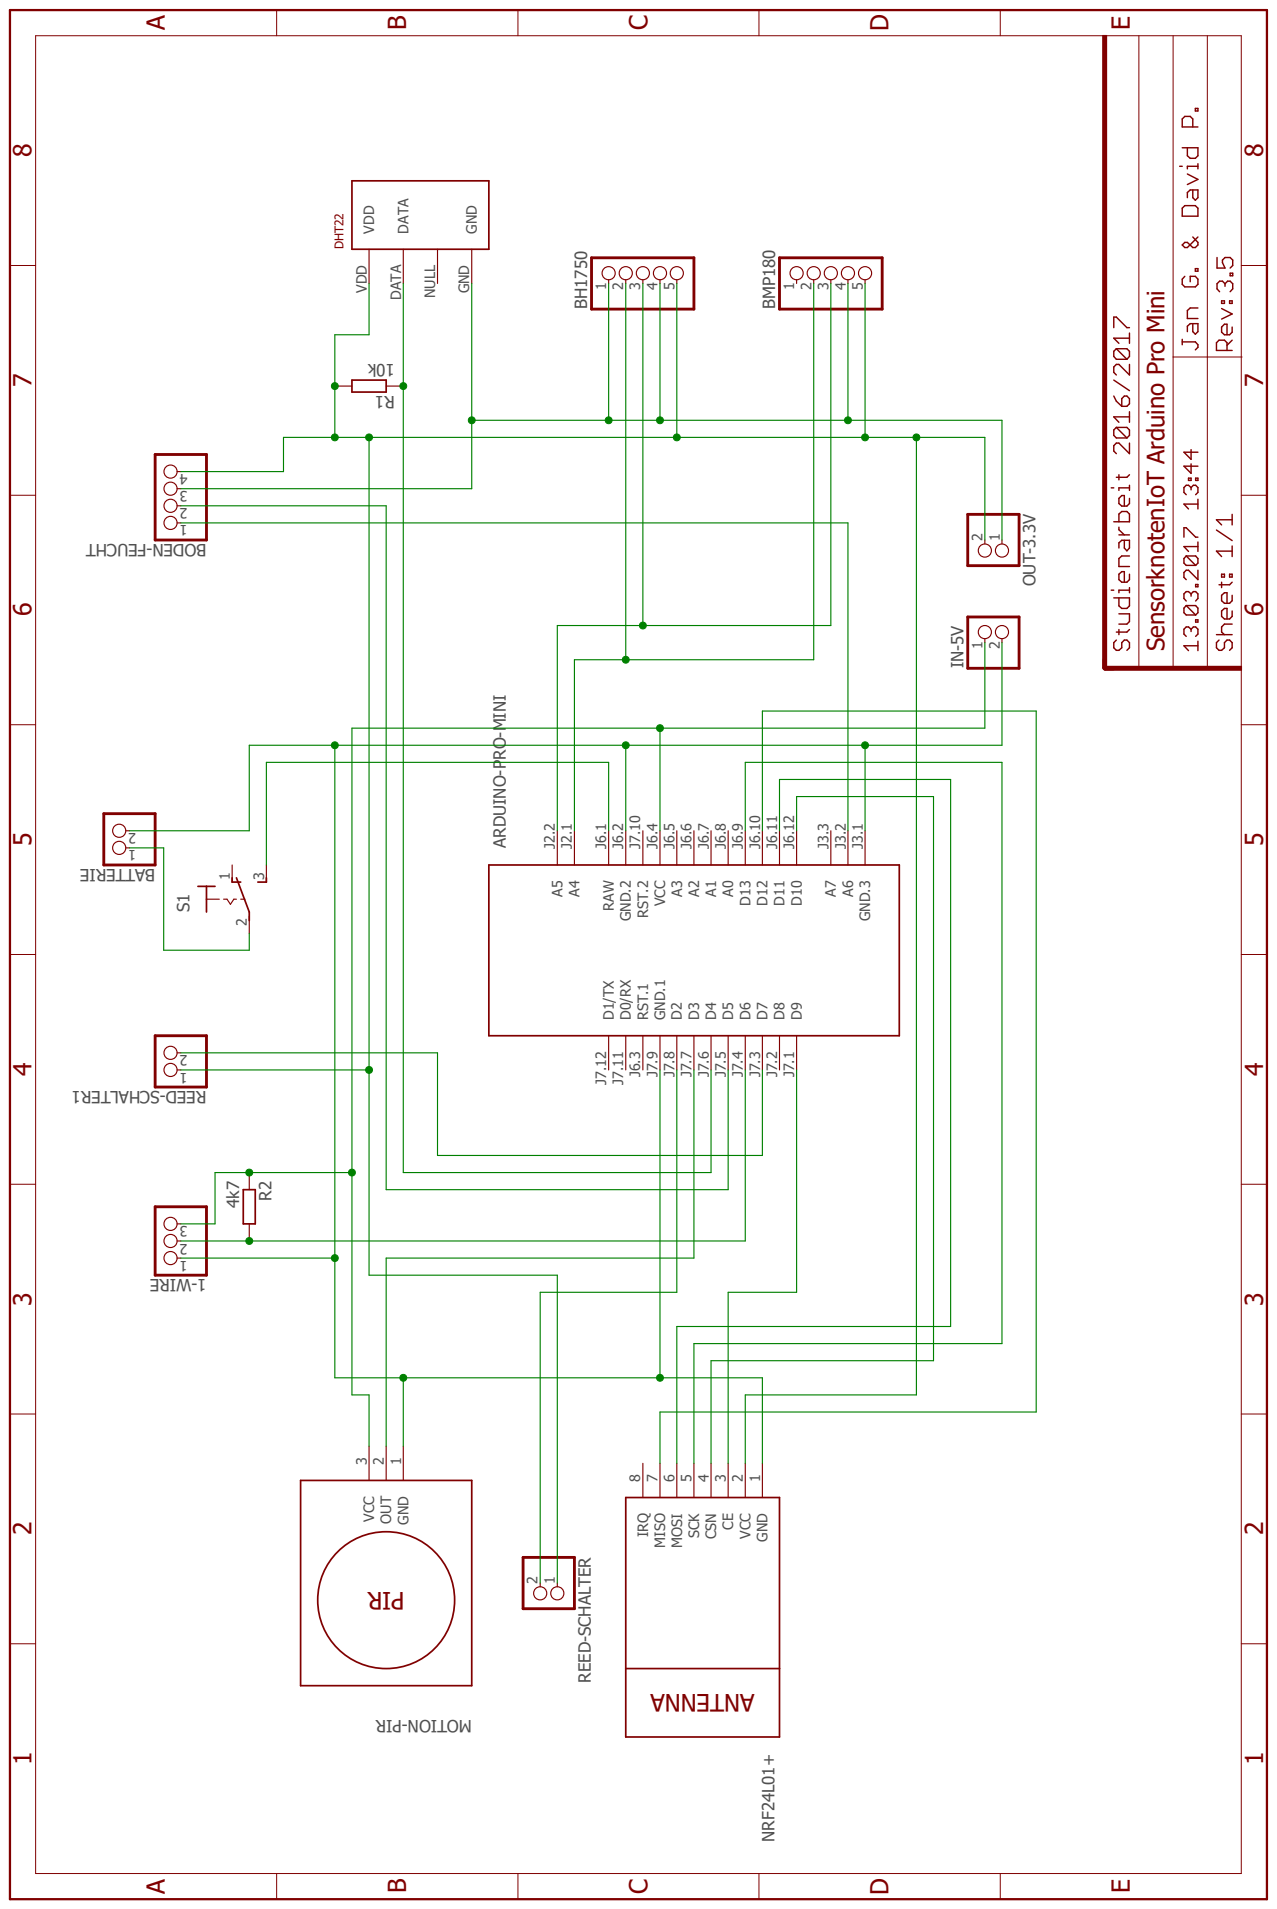
[picture p76: page 1]

1 SensorknotenIoT Arduino Pro Mini ANTENNA PIR
