davidReward/dokustudienarbeit/V2Doku/bilder/ArduinoProMiniUeberarbeitet.pdf

A

1 | 2 | 3 | 4 | 5 | 6 | 7 | 8

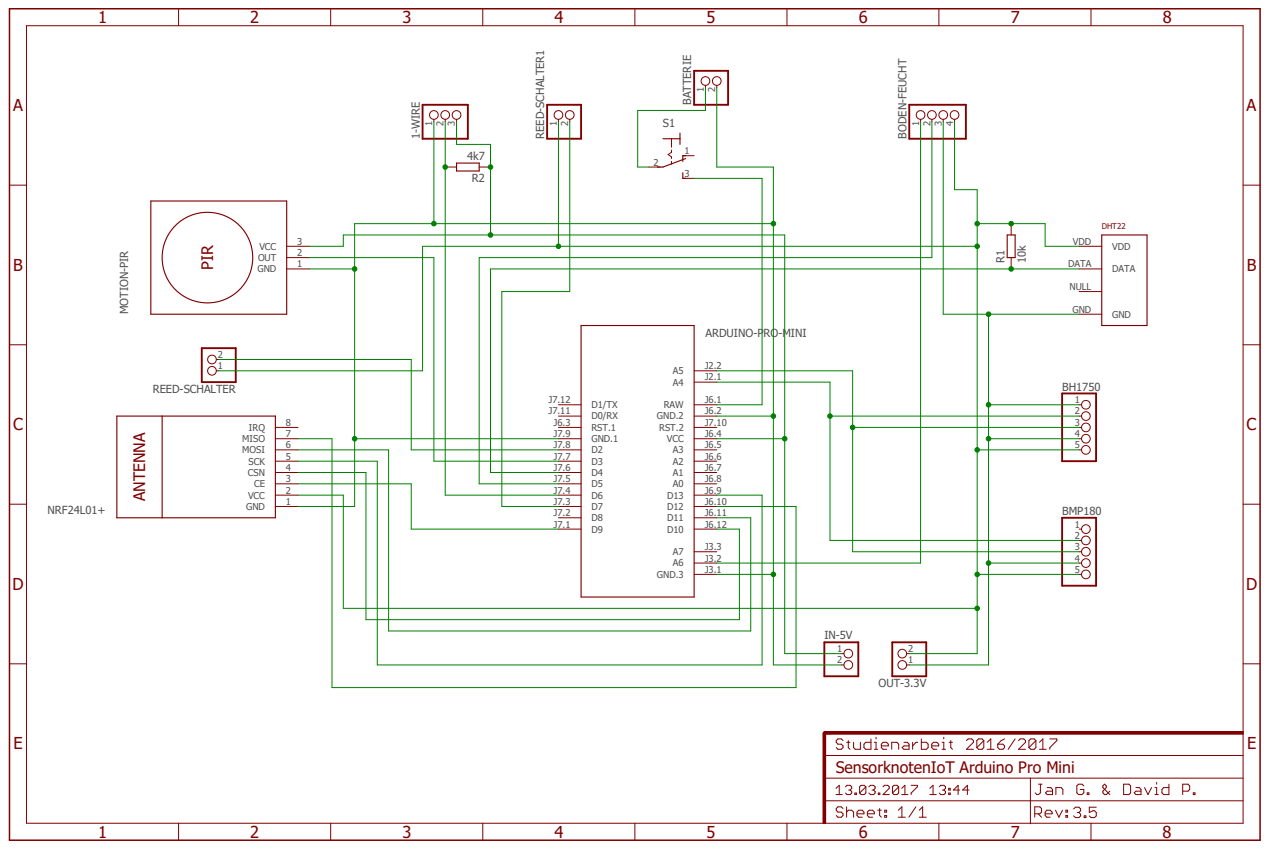
[picture p77: page 1]

GND GND R¹ BATTERIE 1
