davidReward/dokustudienarbeit/V2Doku/bilder/ArduinoNano-rotated.pdf

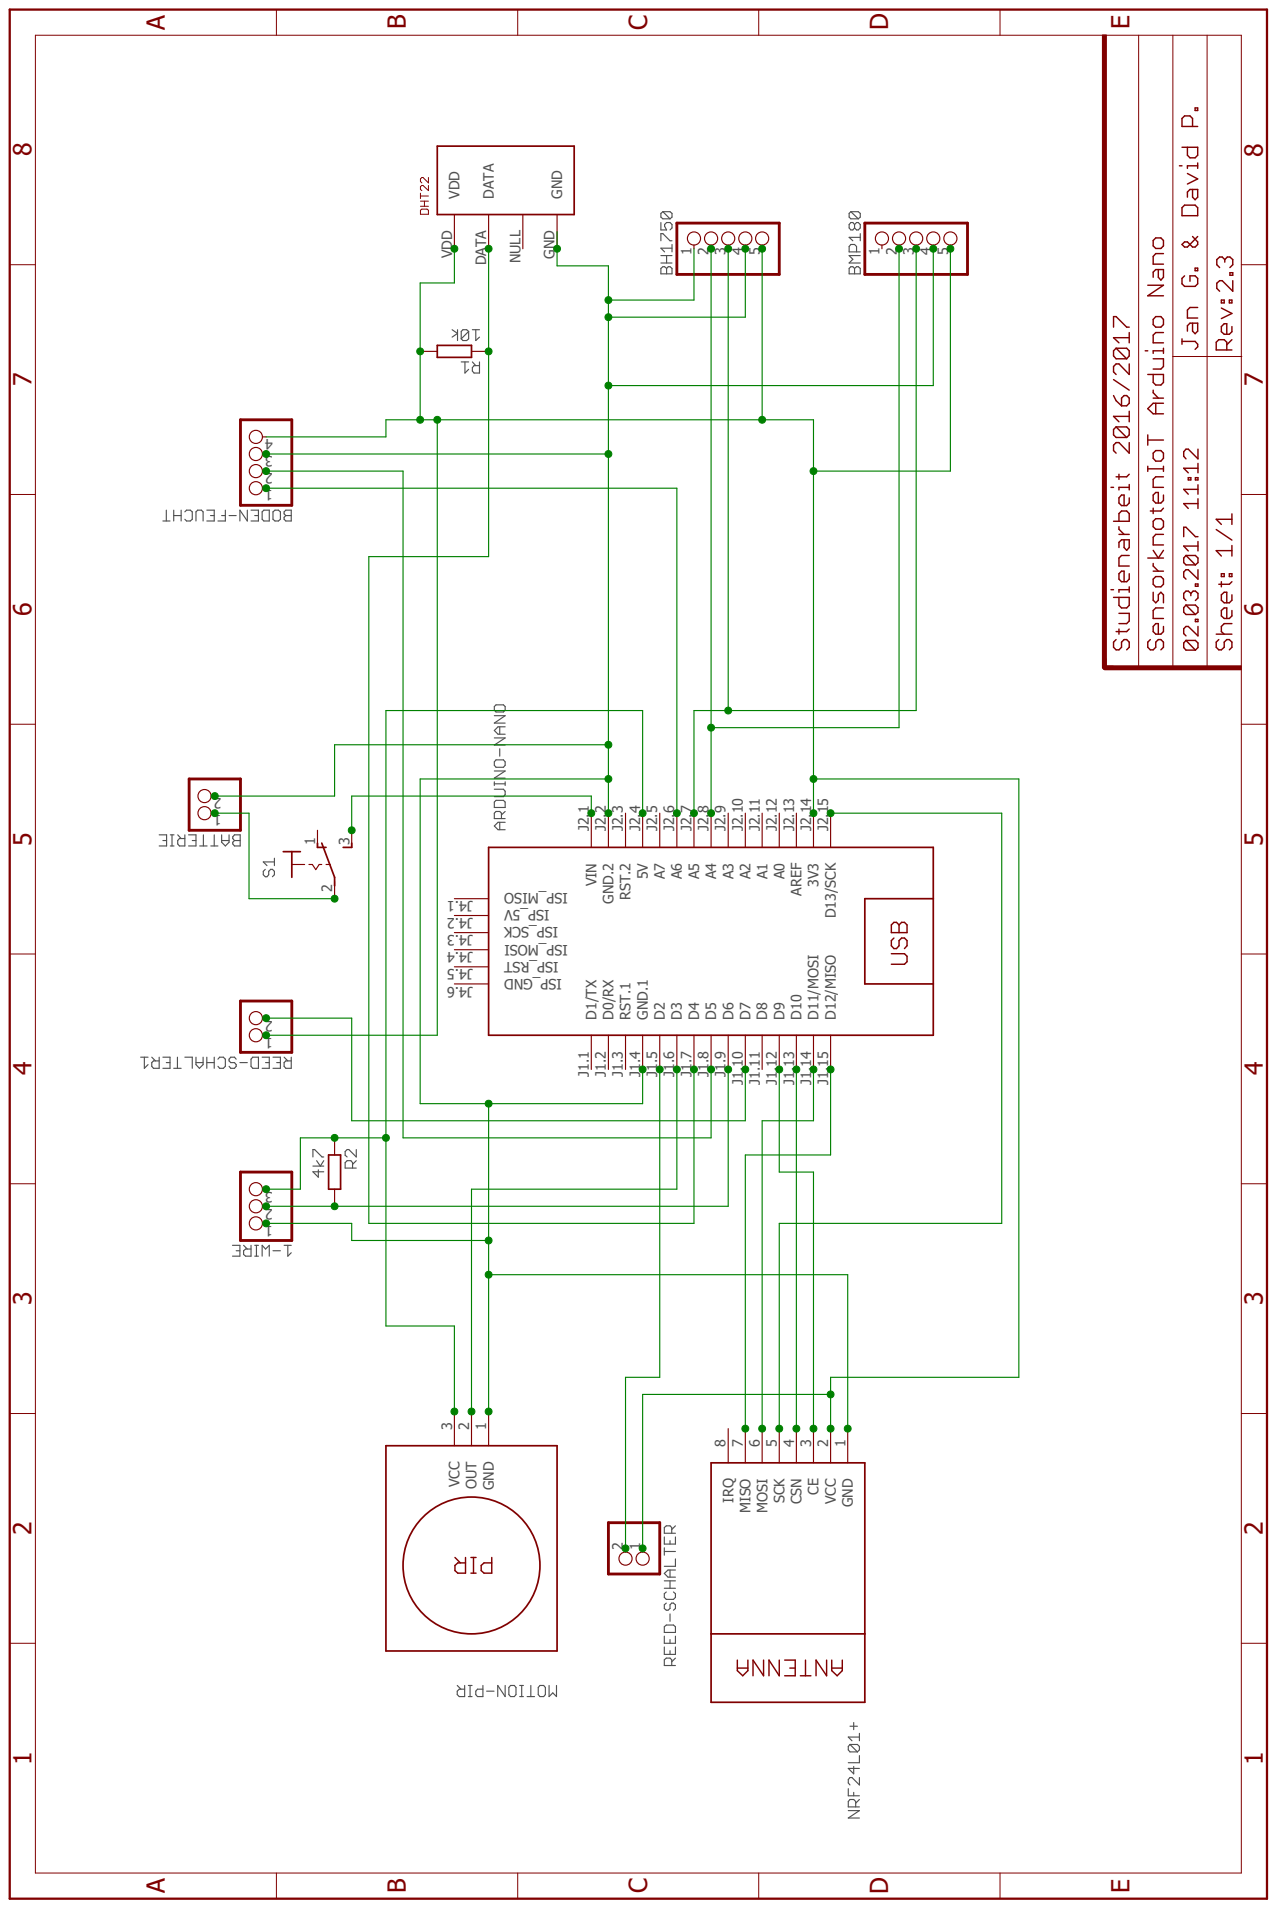
[picture p78: page 1]
