davidReward/dokustudienarbeit/V2Doku/bilder/ArduinoProMini-rotated.pdf

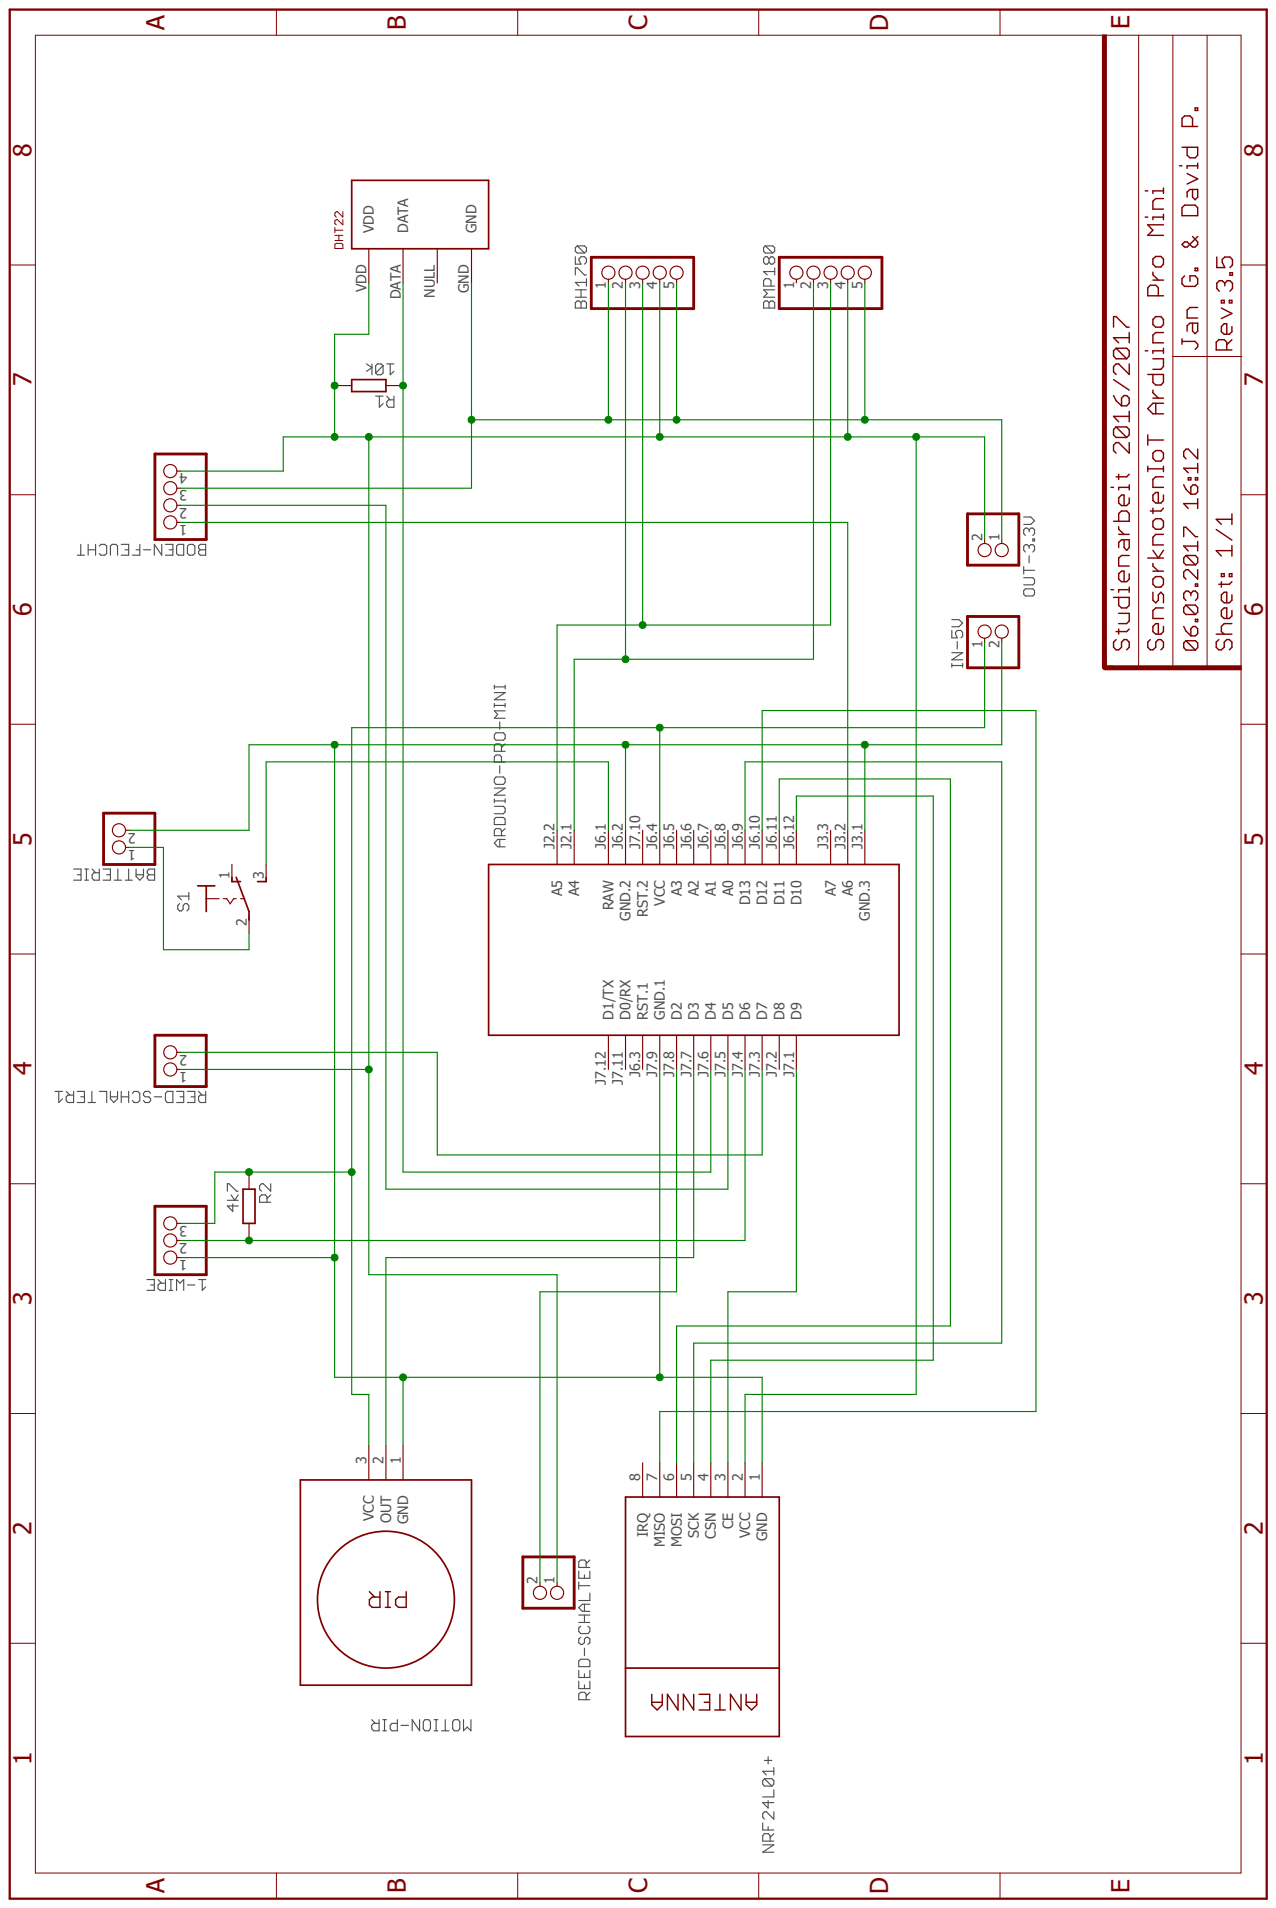
[picture p79: page 1]
