davidReward/dokustudienarbeit/V2Doku/bilder/ArduinoNano.pdf

12 | 123 | 1234 2 | 31 ¹² ABCDE | 1 | 2 | 3 | 4 | 5 | 6 | 7 | 8 | ABCDE 1 | 2 | 3 | 4 | 5 | 6 | 7 | 8

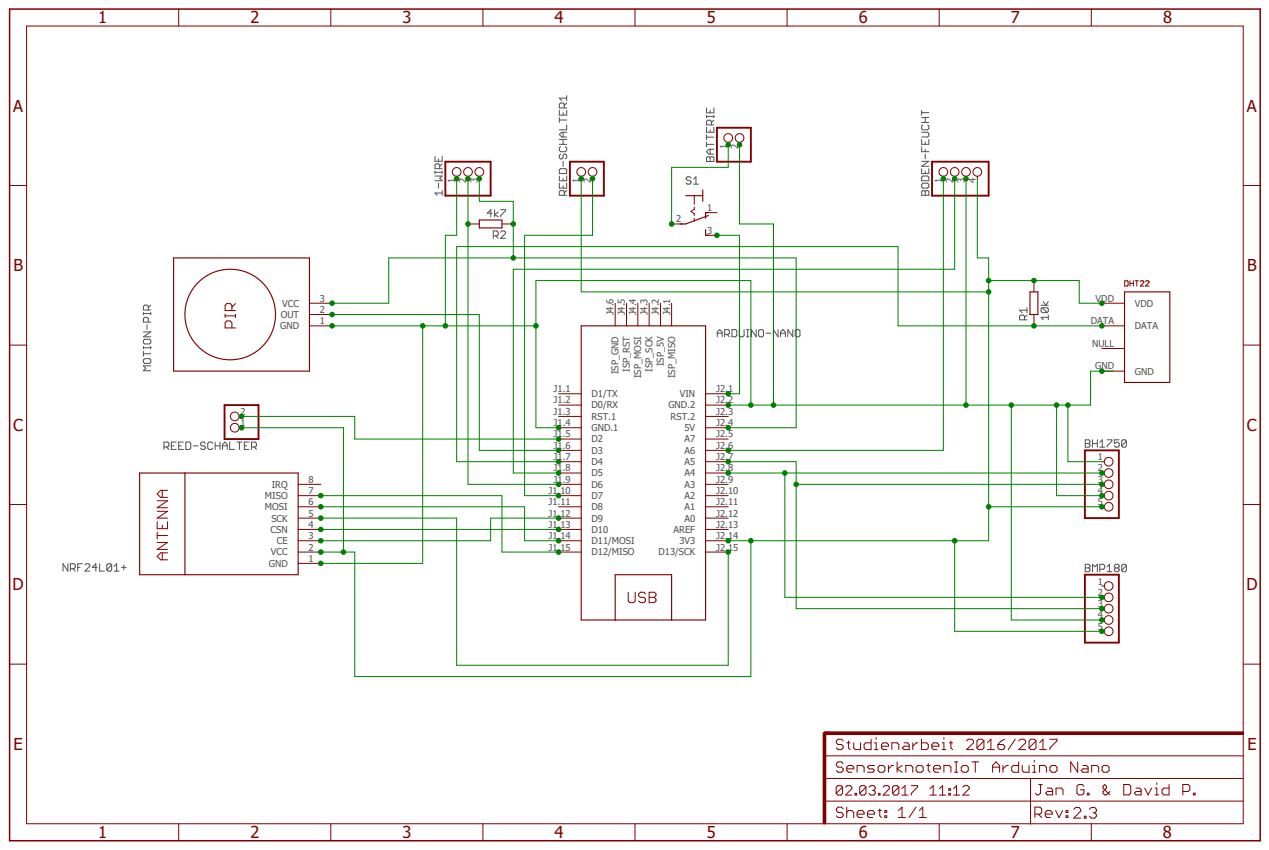
[picture p80: page 1]

D3 J1.6
D4 J1.7
D5 J1.8

6 | D8 J1.11 D9 J1.12

3 | D11/MOSI J1.14
2 | D12/MISO J1.15
