davidReward/dokustudienarbeit/(commit log)

2017-03-23 raspberry added
2017-04-25 spi begonnen
2017-04-25 pics i2c added
2017-05-06 Python und PyCharm, IoT begonnen
2017-05-07 Kapitel: Arduino Hardware
2017-05-08 korrektur sheet added
    [korrekturAnki.xlsx]
2017-05-10 Bilder Sensorknoten
2017-05-13 sensorik fertig, listing eingebunden
2017-05-13 anbindung raspi/arduino
2017-05-13 Kapitel Messwerterfassung mit Arduino
2017-05-14 Kaptitel verwendete Sensoren abgeschlossen
2017-05-14 Bild hinzugefügt Kapitel verwendete Sensoren
2017-05-14 Kapitel Hardware arduino
2017-05-14 Kapitel Hardware Arduino fertiggestellt
