davidReward/dokustudienarbeit/V2Doku/bilder/IMG_1878.JPG

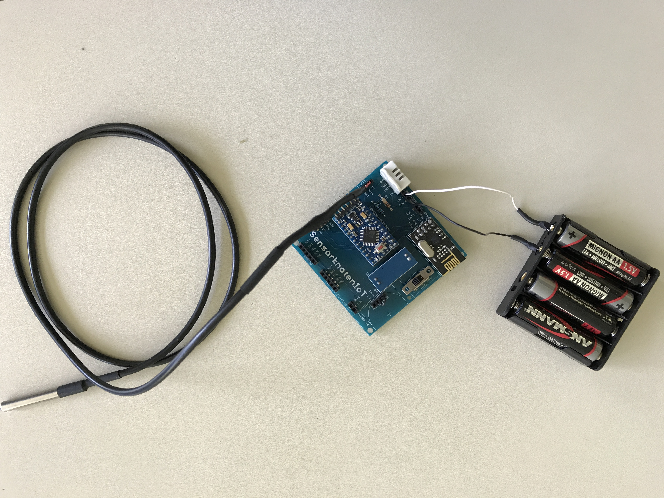
V2Doku/bilder/IMG_1878.JPG
