davidReward/dokustudienarbeit/V2Doku/bilder/IMG_1879.JPG

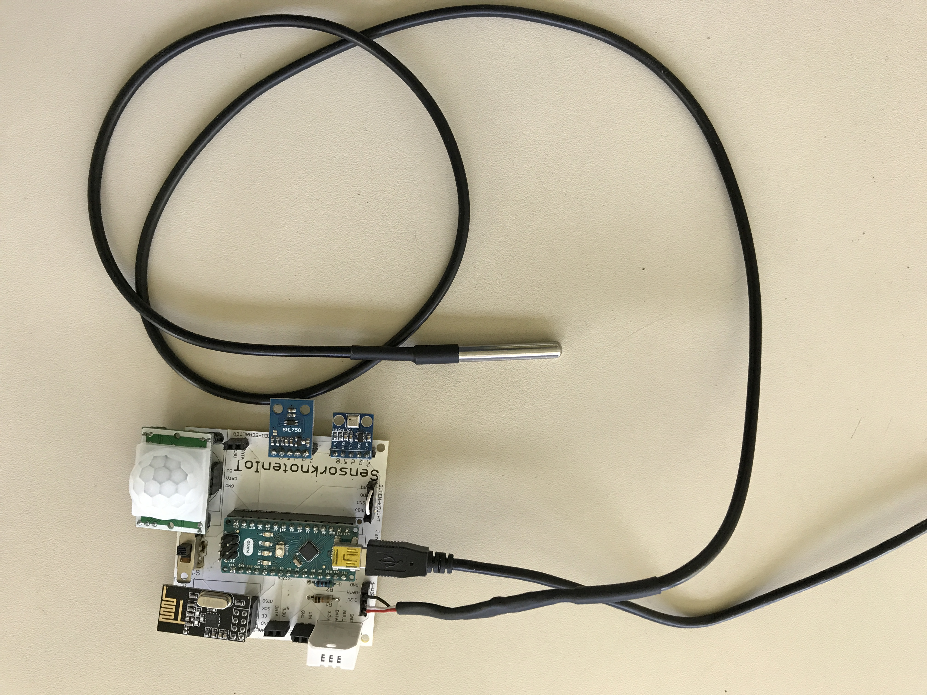
V2Doku/bilder/IMG_1879.JPG
